PisterLab/scum-dev-board/sulu-ldo/readme.md

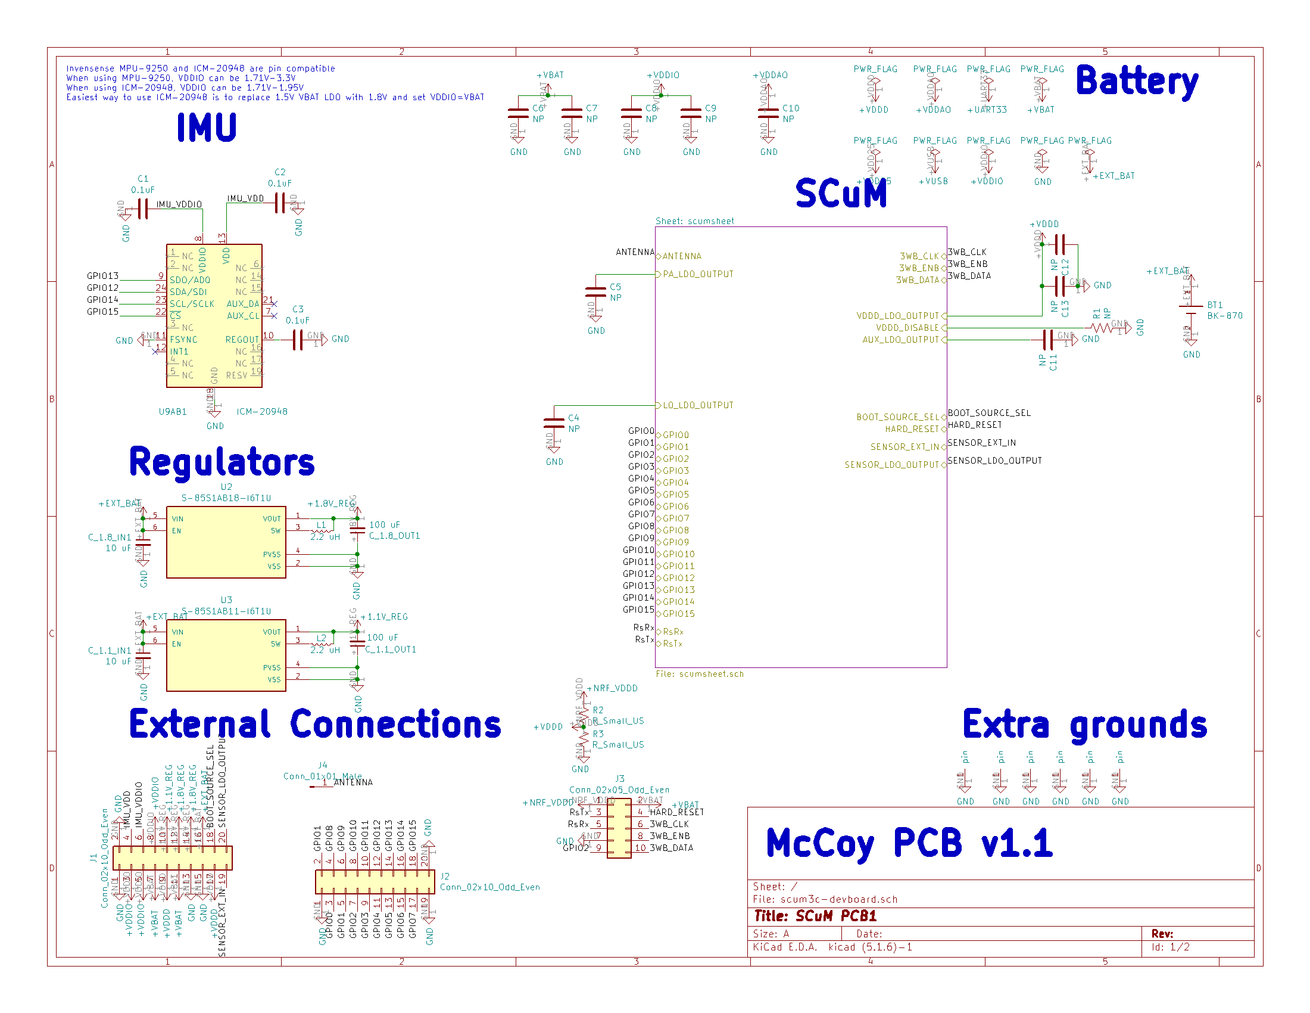
[picture p5: sulu-ldo/pictures/scum3c-devboard_schematic_Page_1.png]
Schematic page 1

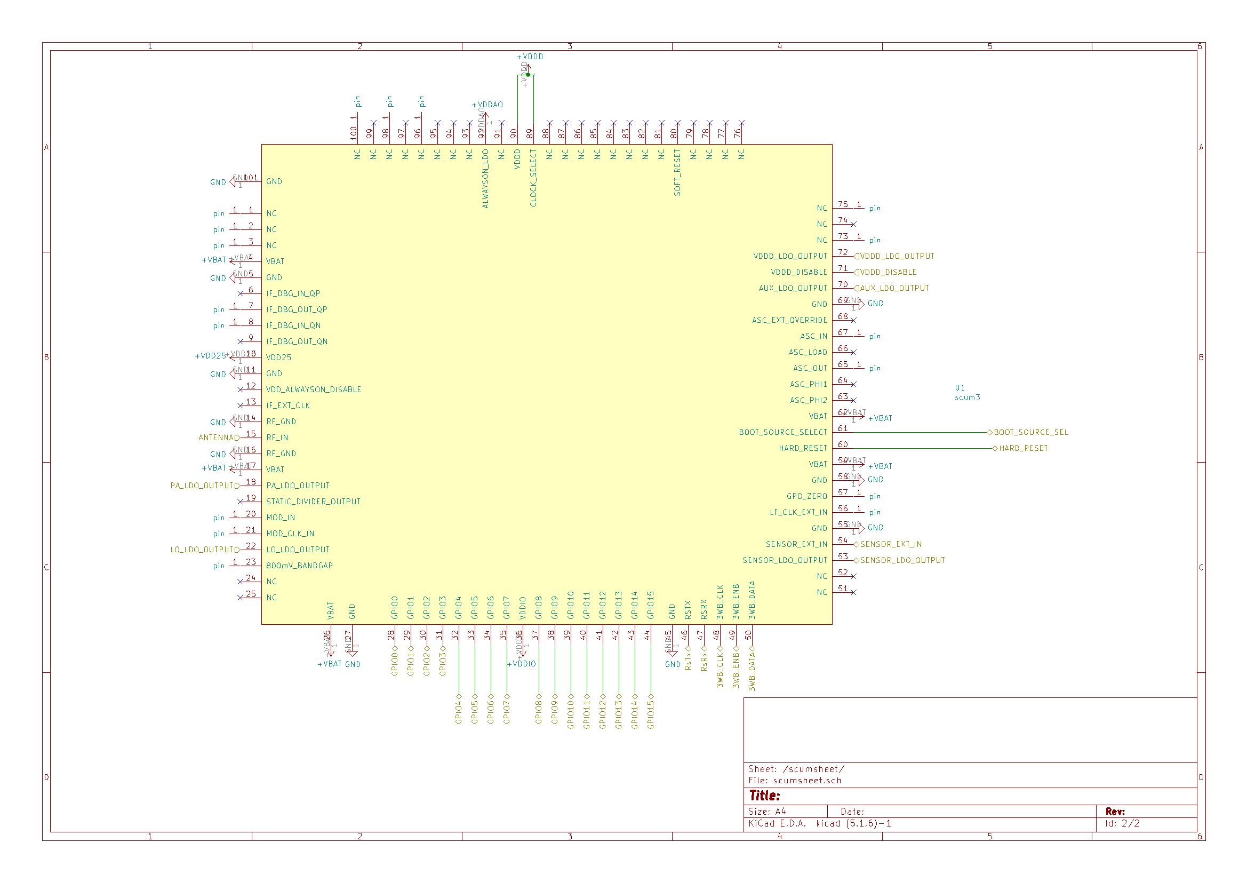
[picture p6: sulu-ldo/pictures/scum3c-devboard_schematic_Page_2.png]
Schematic page 2

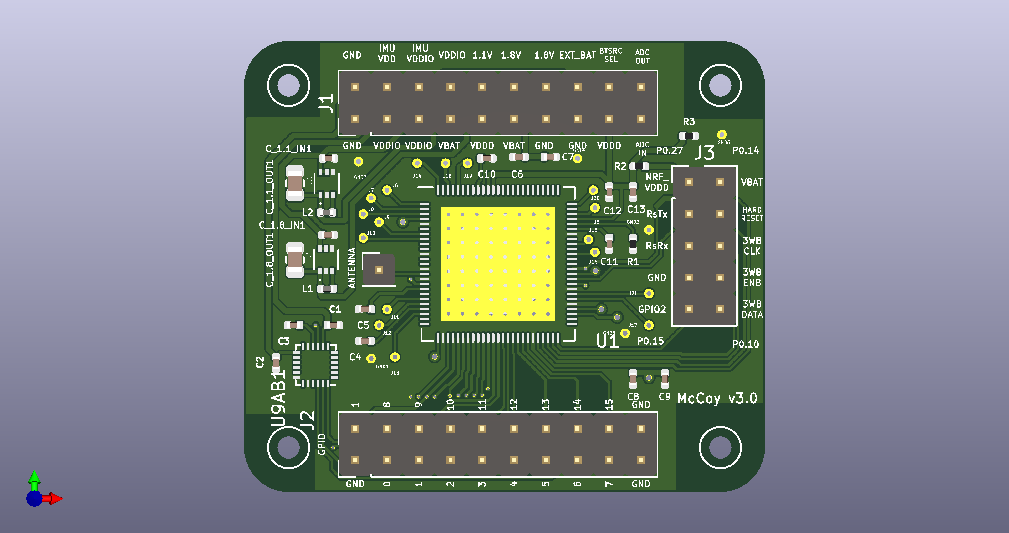
[picture p7: sulu-ldo/pictures/scum3c-devboard.png]
3D front

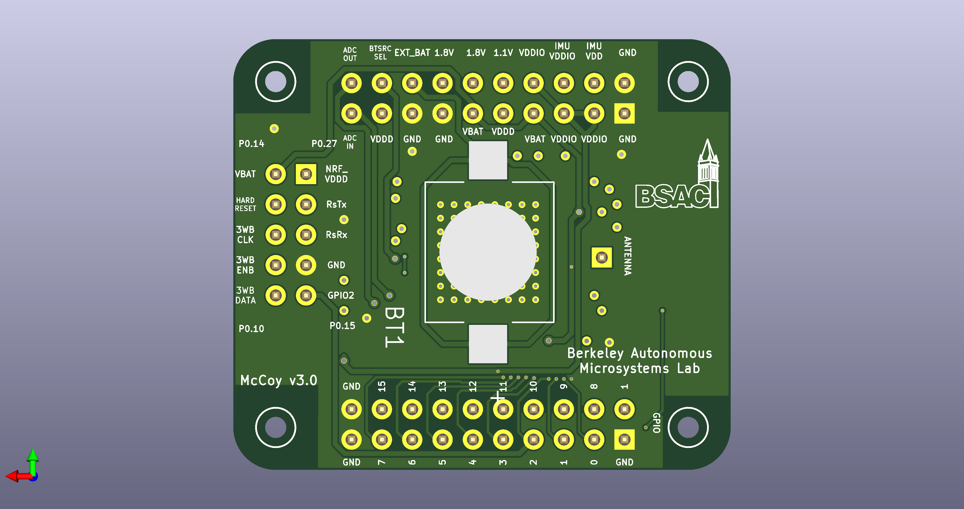
[picture p8: sulu-ldo/pictures/scum3c-devboard_back.png]
3D back


### Update from board review 2021.04.27
- Put the antenna on a solo pin
- rearrange some pins
- change through hole size to 15 mils
- nrf pin labels

### Updates 2021.04.25
- New layout for compatibility with NRF
- Bunch of through holes for emergency connections
- Return of the 2986 battery clip

### Updates 2021.04.14
- Austin’s requested layout
- Larger dimensions -- no longers square
- 0.1” pins
- Pins for all GPIOs
- Antenna pin
- Removed I2C for IMU
- Via holes for wiring
- 2 layer instead of 4 layer
- HARD_RESET pin
- GPO_ZERO pin instead of LED
- Swapped GPIO 12 and GPIO 13 on IMU
- Consolidated headers
- Neatened labels
- New battery clip

### Updates 2020.12.05
- removed zener diode
- added GPIOs 8, 9, 10
- added ground connections near GPIO
- added labels
- moved passives around
- added ADC pins

### Updates 2020.12.02
- Replaced antenna header with VDDD
- Kept LED
- 0-80 standoffs
- 0.1” -> 0.05” headers
- Removed GPIO 8-15 pins

### Updates 2020.10.07
- 30mm x 30 mm
- holes for standoffs
- SR521SW battery clip
- IMU
- GPIO, 3WB, UART, VBAT, VDDIO pins
- 1.8 V Zener diode for voltage protection
- LED programming indicator

### Updates 2021.01.15
- Added missing BOOT_SOURCE_SEL header
