PisterLab/scum-dev-board/spock/NJU7665.pdf

# NJU7665 Series

- 1 -

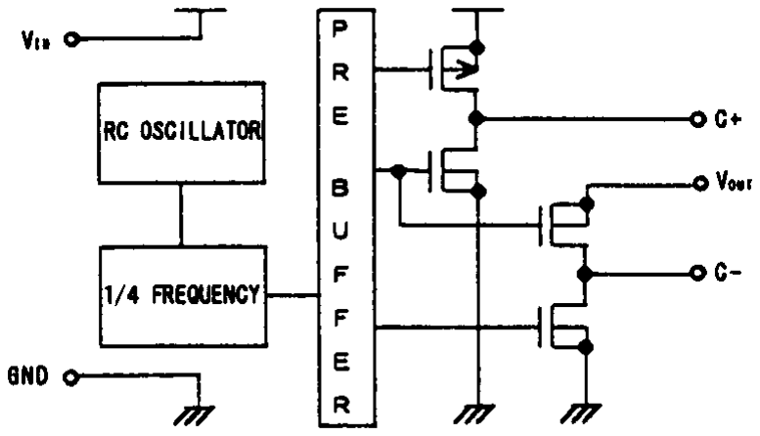
[picture p9: figure]

Ver.2018-07-18

## SMALL PACKAGE VOLTAGE INVERTER

■ GENERAL DESCRIPTION | ■ PACKAGE OUTLINE

### The NJU7665 series is a voltage inverter incorporated RC oscillator, pre-buffer and power-MOS, which generates a

polarity-converted negative voltage from +1.5V to +5.5V.

### The switching frequency is fixed by internal RC oscillator and the

following line-up of 3 version are available to select.

### The NJU7665 series is in MTP-5 package and it is suitable for

battery use items and other portable items.

### ■ FEATURES

Input Voltage | : | 1.5 to 5.5V
Switching Frequency | : | fsw = 7.5k, 75k, 150kHz
Low Output Resistance | : | 75Ω MAX. (C version, C = 1μF, VIN = 3V)
Low Operating Current | : | 100μA MAX. (Aversion)

### C-MOS Technology

Package Outline | : | MTP-5

### ■ LINE-UP TABLE

TYPE NO. | Switching Frequency | Supply Current | Output Resistance
NJU7665A | 7.5kHz (typ.) | 100μA(max.) | 1kΩ (max.)
NJU7665B | 75kHz (typ.) | 0.65mA(max.) | 100Ω (max.)
NJU7665C | 150kHz (typ.) | 1.4mA(max.) | 75Ω (max.)
■ BLOCK DIAGRAM | ■ PIN CONFIGURATION

### ■ TERMINAL DESCRIPTION

Terminal No. | Symbol | Function
1 | VOUT | Output Voltage
2 | VIN | Power Supply Terminal
3 | C
- Charge Pump Capacitor (-) Connecting Terminal
4 | GND | Ground Terminal
5 | C
| + | Charge Pump Capacitor (+) Connecting Terminal

### NJU7665XF

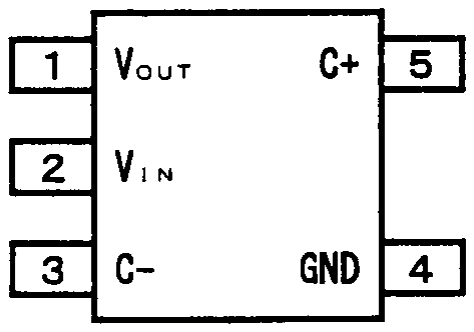
[picture p10: figure]

- 2 -
■ ABSOLUTE MAXIMUM RATINGS | (Ta = 25ºC)
PARAMETER | SYMBOL | RATINGS | UNIT
Input Supply Voltage | VIN | -0.3 to 6.0 | V
Power Dissipation | PD | 200 | mW
Operating Temperature | Topr | -40 to + 85 | ºC
Storage Temperature | Tstg | -55 to +125 | ºC
Note1) Decoupling capacitor should be connected between VIN and GND due to the stabilized operation for the IC.

### ■ ELECTRICAL CHARACTERISTICS

Aversion | (VIN = 3.0V, C1 = C2 = 1μF, Ta = 25°C)
PARAMETER | SYMBOL | CONDITION | MIN. | TYP. | MAX. | UNIT
Supply Current | IIN | RL= ∞ | – | – | 100 | μA
Input Supply Voltage | VIN | -40 °C ≤ Ta ≤ 85°C | 1.5 | – | 5.5 | V
Output Resistance | ROUT | IOUT = 500μA | – | – | 1.0 | kΩ
Switching Frequency | FSW | | 4.5 | 7.5 | 10.5 | kHz
Voltage Conversion Rate | VEF | RL= ∞ | 90 | 99.3 | – | %
B version | (VIN = 3.0V, C1 = C2 = 1μF, Ta = 25°C)
PARAMETER | SYMBOL | CONDITION | MIN. | TYP. | MAX. | UNIT
Supply Current | IIN | RL= ∞ | – | – | 0.65 | mA
Input Supply Voltage | VIN | -40 °C ≤ Ta ≤ 85°C | 1.5 | – | 5.5 | V
Output Resistance | ROUT | IOUT = 5mA | – | – | 100 | Ω
Switching Frequency | FSW | | 40 | 75 | 100 | kHz
Voltage Conversion Rate | VEF | RL= ∞ | 90 | 99.3 | – | %
C version | (VIN = 3.0V, C1 = C2 = 1μF, Ta = 25°C)
PARAMETER | SYMBOL | CONDITION | MIN. | TYP. | MAX. | UNIT
Supply Current | IIN | RL= ∞ | – | – | 1.4 | mA
Input Supply Voltage | VIN | -40 °C ≤ Ta ≤ 85°C | 1.5 | – | 5.5 | V
Output Resistance | ROUT | IOUT = 10mA | – | – | 75 | Ω
Switching Frequency | FSW | | 80 | 150 | 200 | kHz
Voltage Conversion Rate | VEF | RL= ∞ | 90 | 99.3 | – | %
NOTE2) Please minimize the wiring impedance of C+, C- terminals due to the power conversion rate.

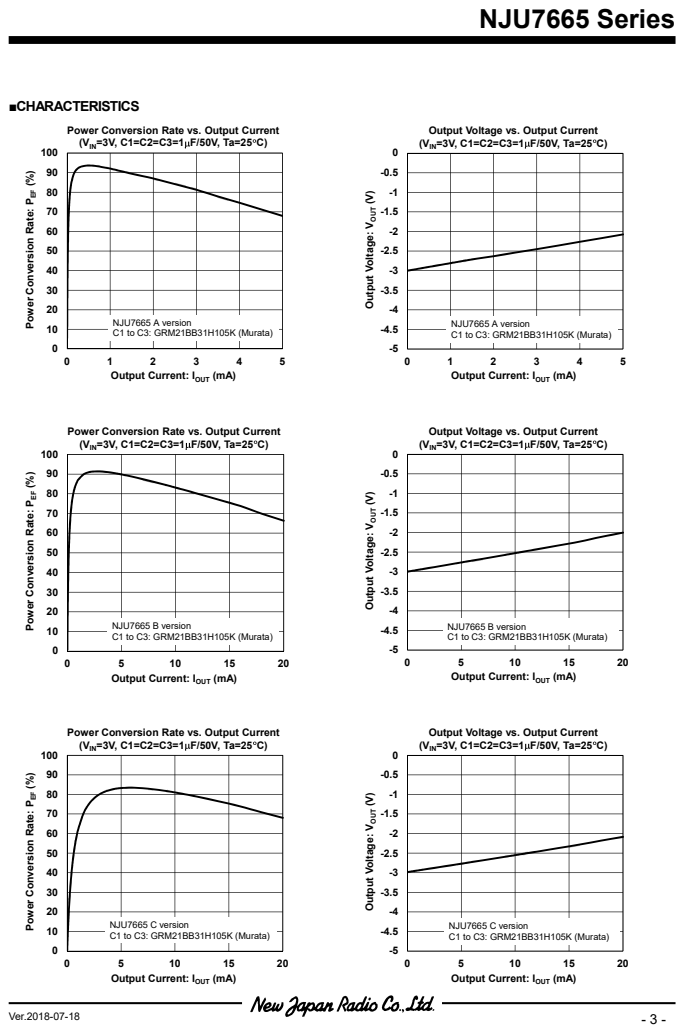
[picture p11: page 3]
■CHARACTERISTICS; NJU7665 A version C1 to C3: GRM21BB31H105K (Murata); Output Voltage vs. Output Current (VIN=3V, C1=C2=C3=1 F/50V, Ta=25 C); NJU7665 B version C1 to C3: GRM21BB31H105K (Murata); NJU7665 C version C1 to C3: GRM21BB31H105K (Murata)

Power Conversion Rate vs. Output Current
(VIN=3V, C1=C2=C3=1 F/50V, Ta=25 C)

Power Conversion Rate: PEF

Output Voltage: VOUT

Output Current: IOUT

- 4 -

### ■ APPLICATION CIRCUIT

### 1. Negative Voltage Output Circuit

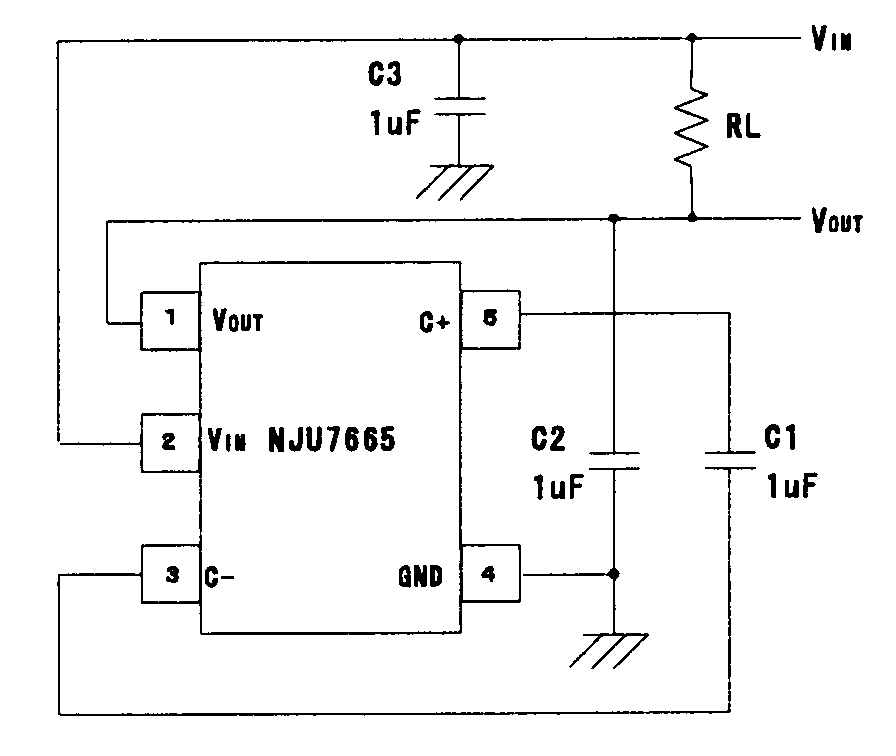
[picture p12: figure]

### 2. Parallel Connection Circuit

The following circuit reduce the output impedance.

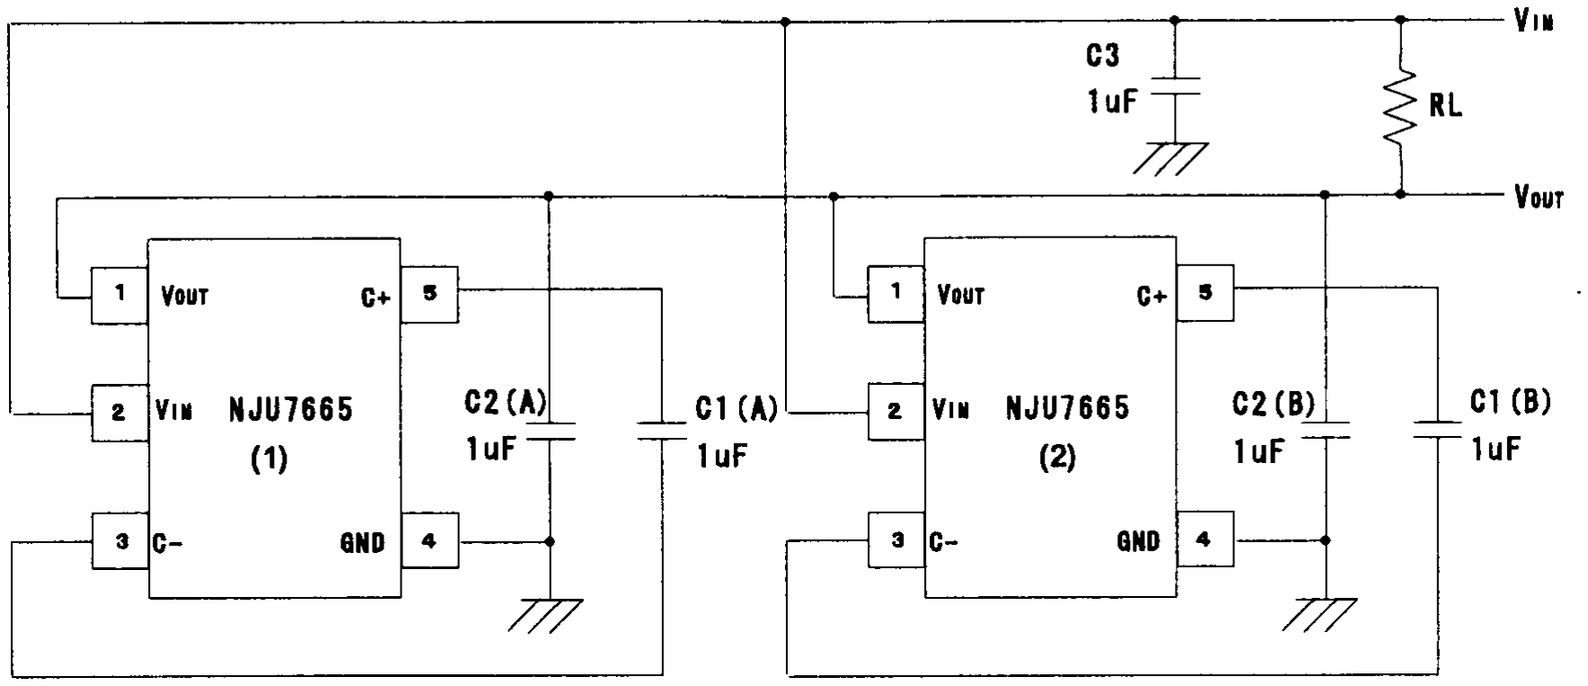
[picture p13: figure]

[CAUTION]
The specificationson thisdatabookare only given forinformation,without any guarantee asregardseither mistakesoromissions.The application circuitsinthisdatabookare describedonlyto showrepresentativeusages of the productandnot intended forthe guarantee orpermissionofanyright including theindustrialrights.
