PisterLab/scum-dev-board/sulu-ldo/pictures/mccoy_v2_bond_diagram.pptx

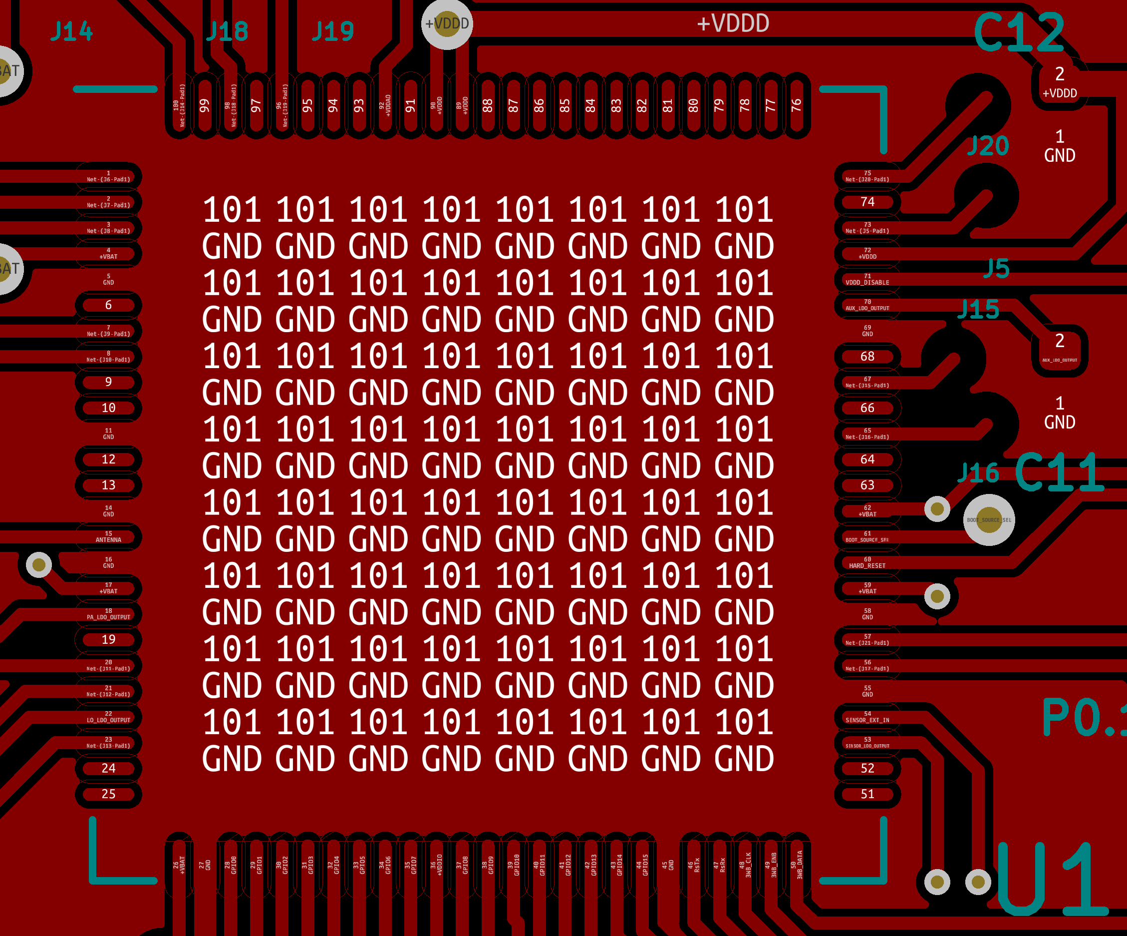
[picture p14: figure]
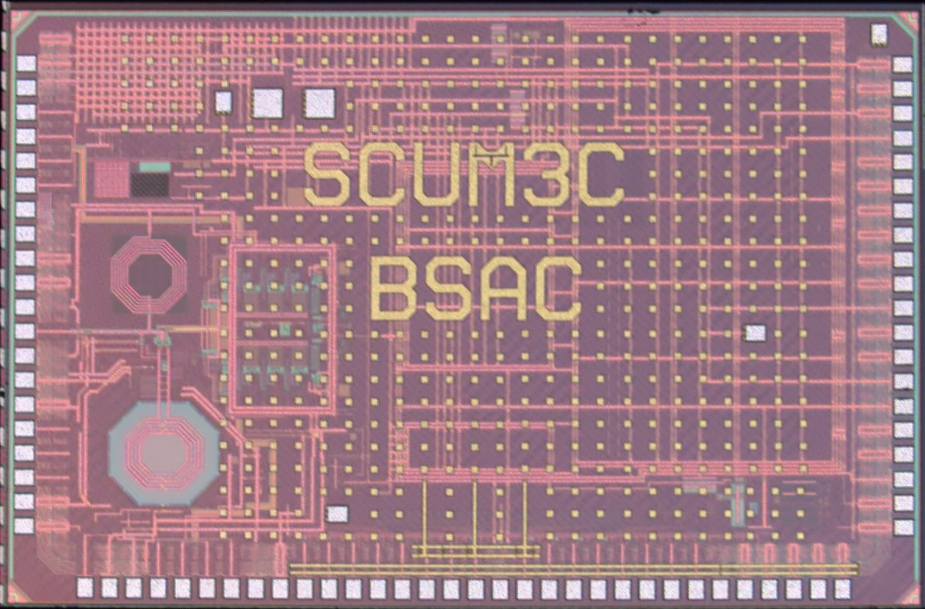
[picture p15: figure]
