PisterLab/scum-dev-board/SCM3C_PCB_Page_1.png

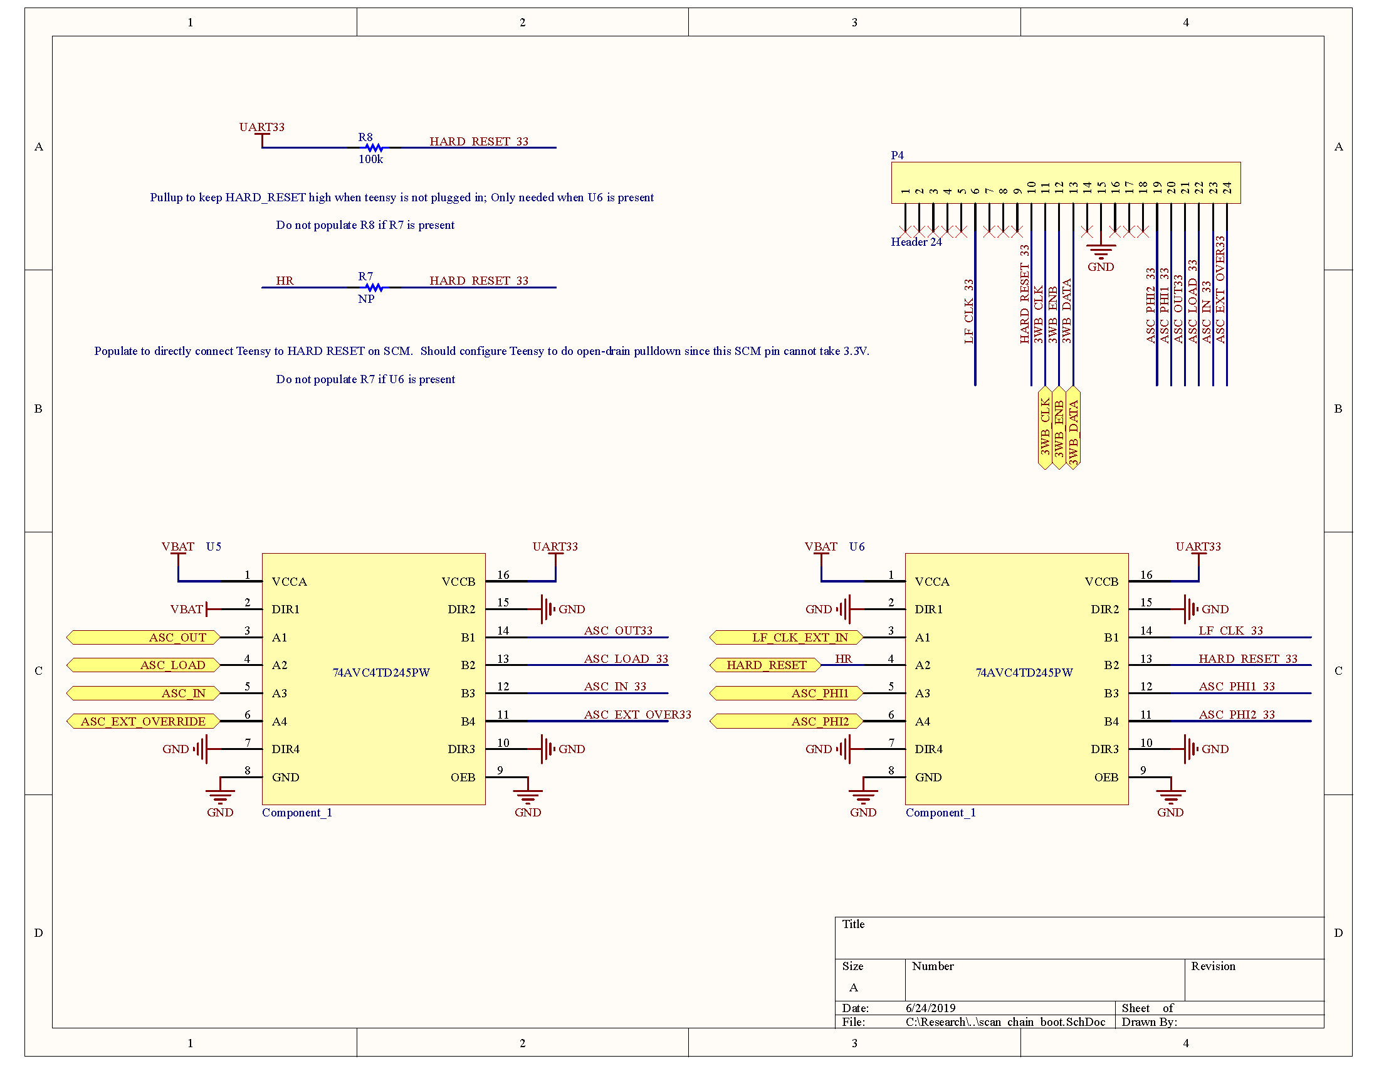
SCM3C_PCB_Page_1.png
