PisterLab/scum-dev-board/SCM3C_PCB_Page_2.png

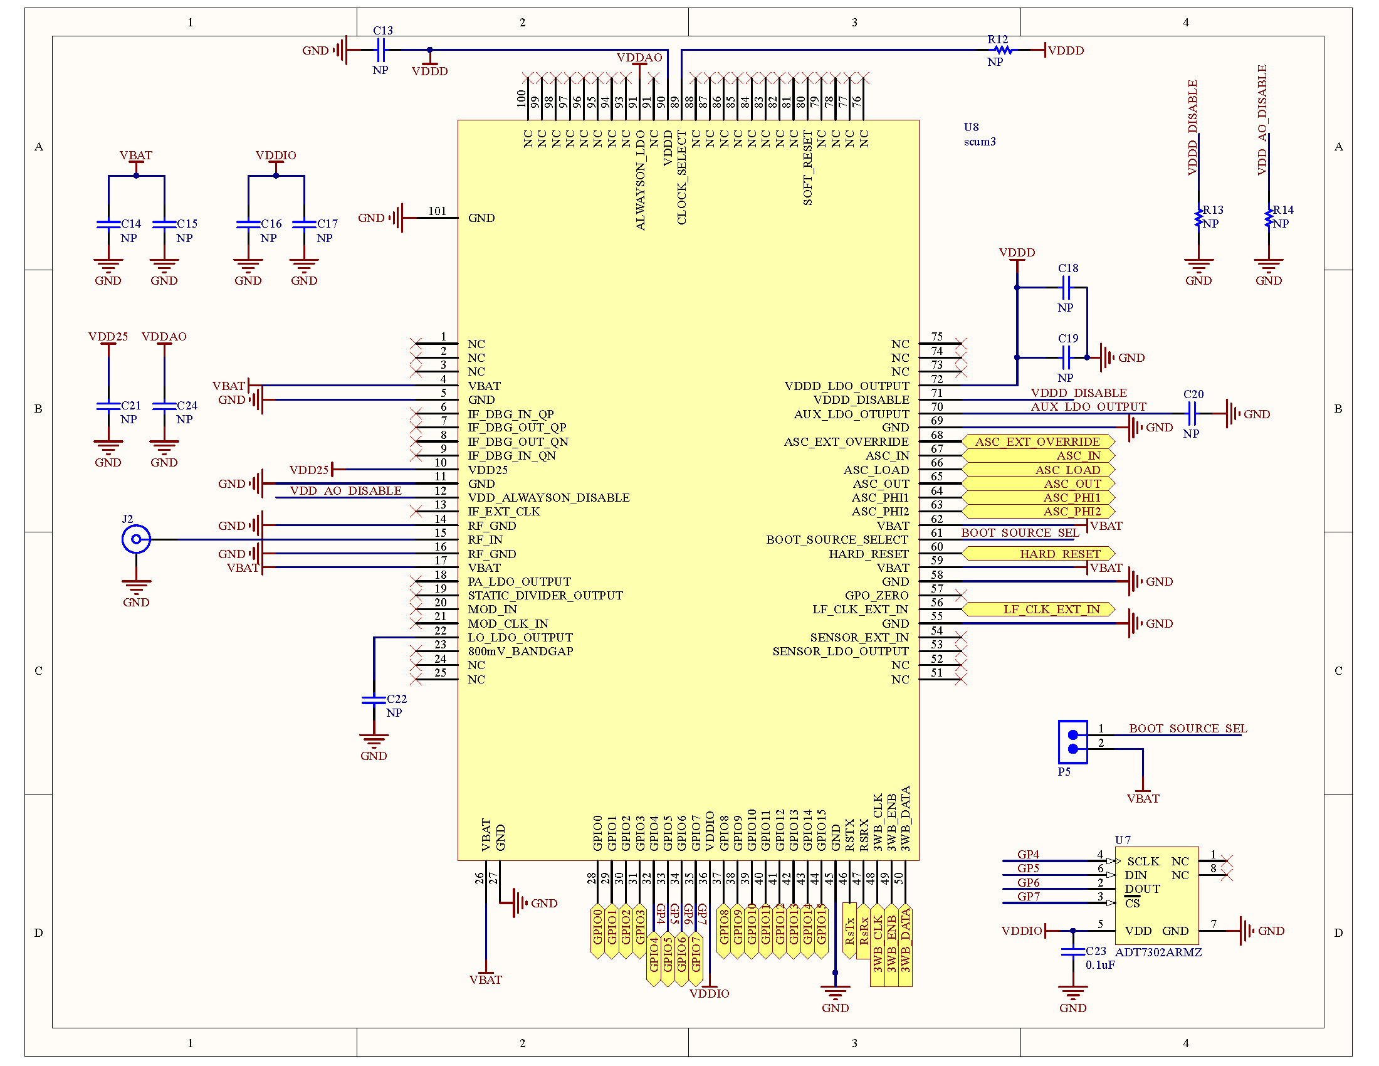
SCM3C_PCB_Page_2.png
