PisterLab/scum-dev-board/SCM3C_PCB_Page_3.png

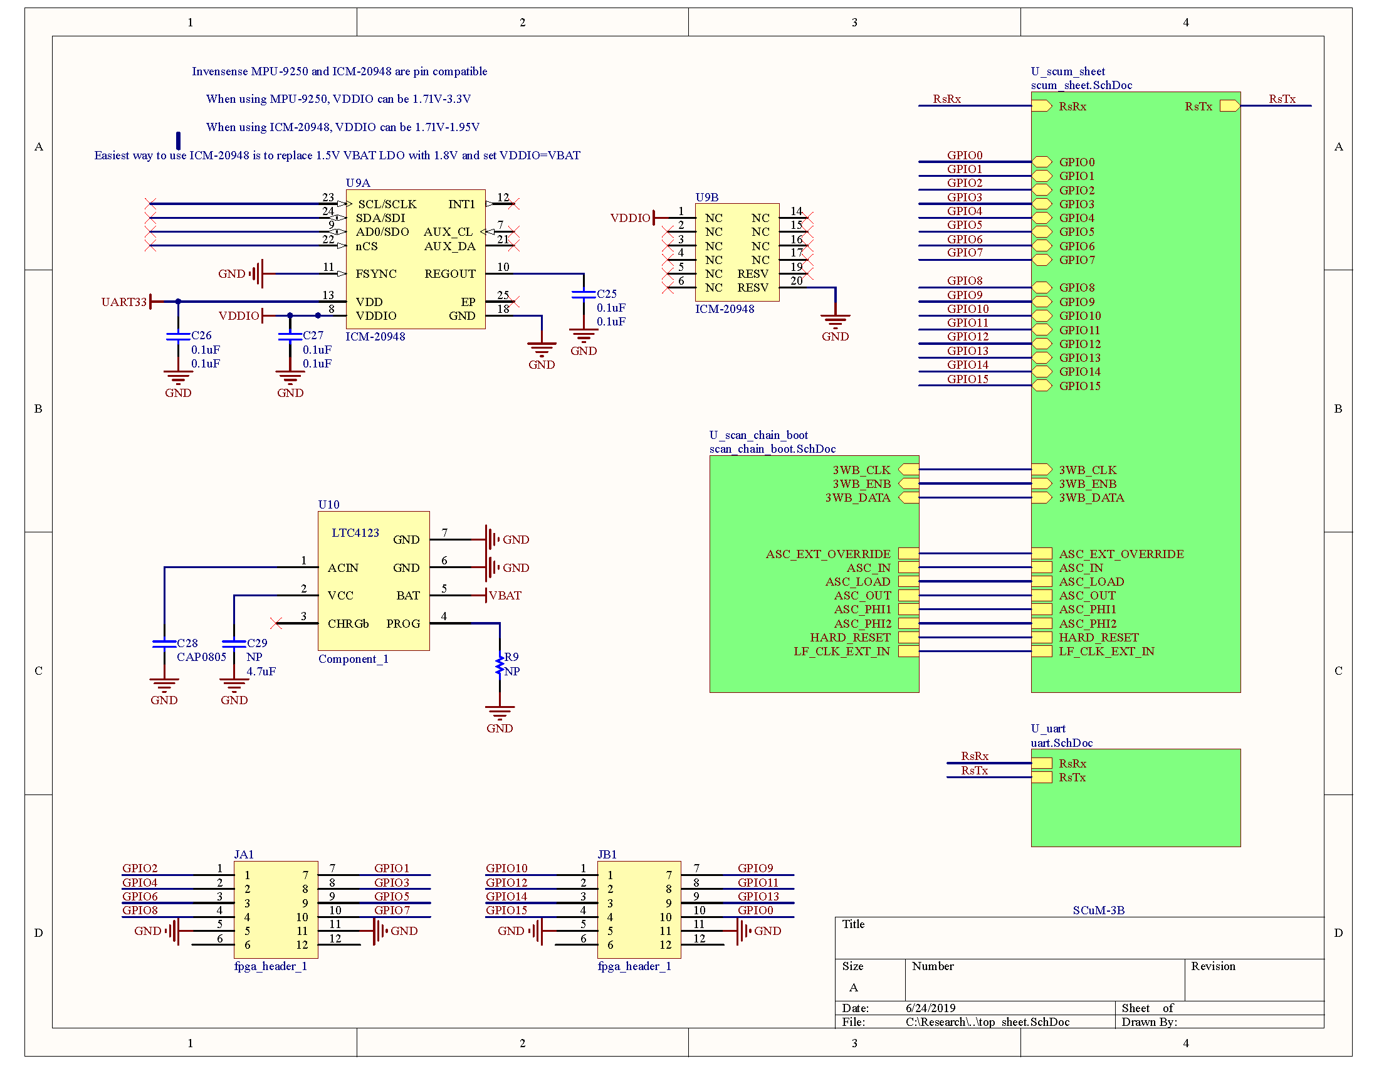
SCM3C_PCB_Page_3.png
