PisterLab/scum-dev-board/SCM3C_PCB_Page_4.png

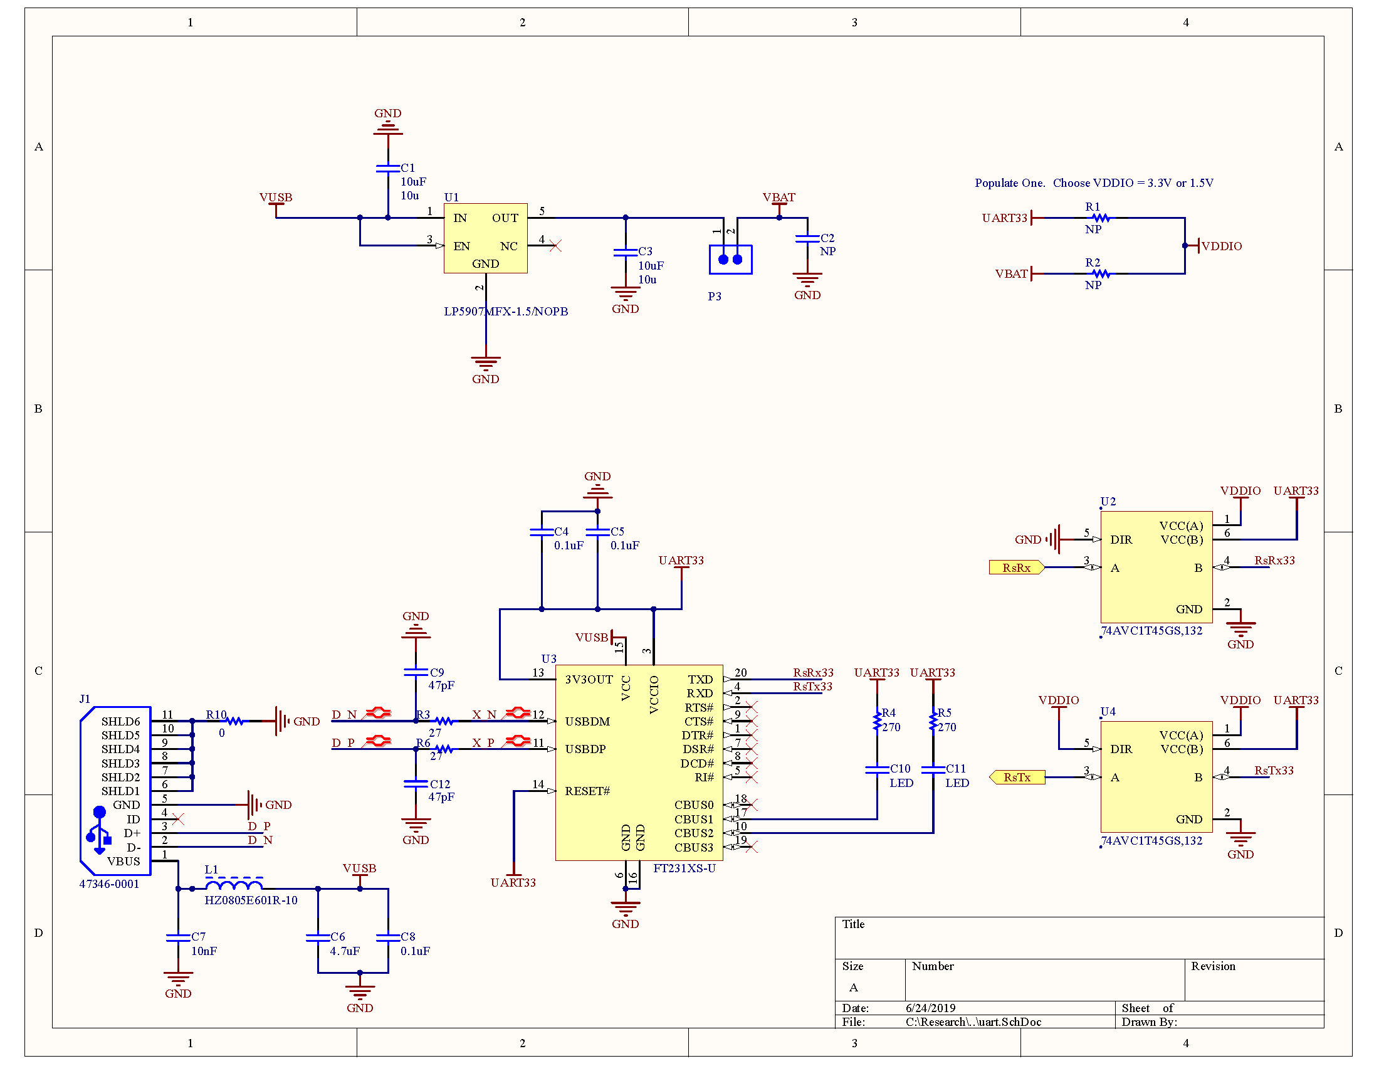
SCM3C_PCB_Page_4.png
