PisterLab/scum-dev-board/SCM3C_PCB_Page_5.png

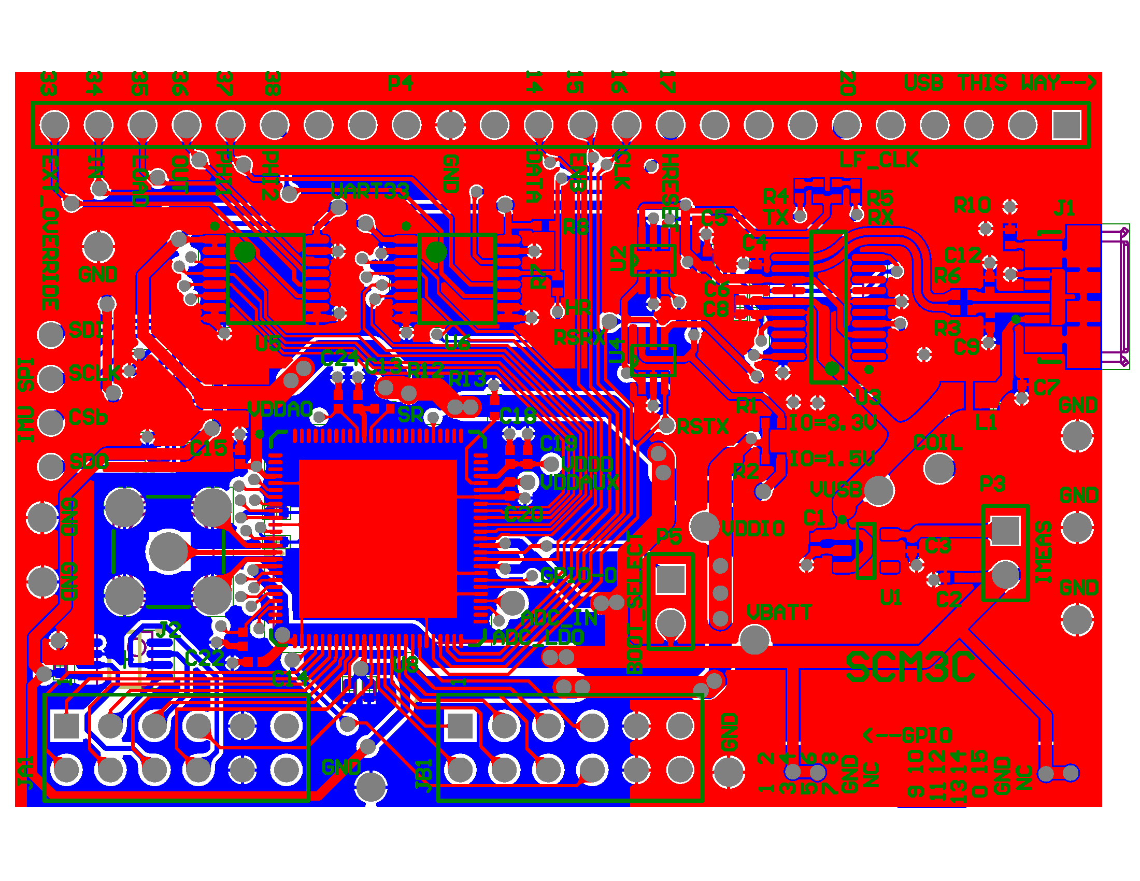
SCM3C_PCB_Page_5.png
