PisterLab/scum-dev-board/SCM3C_PCB_Page_6.png

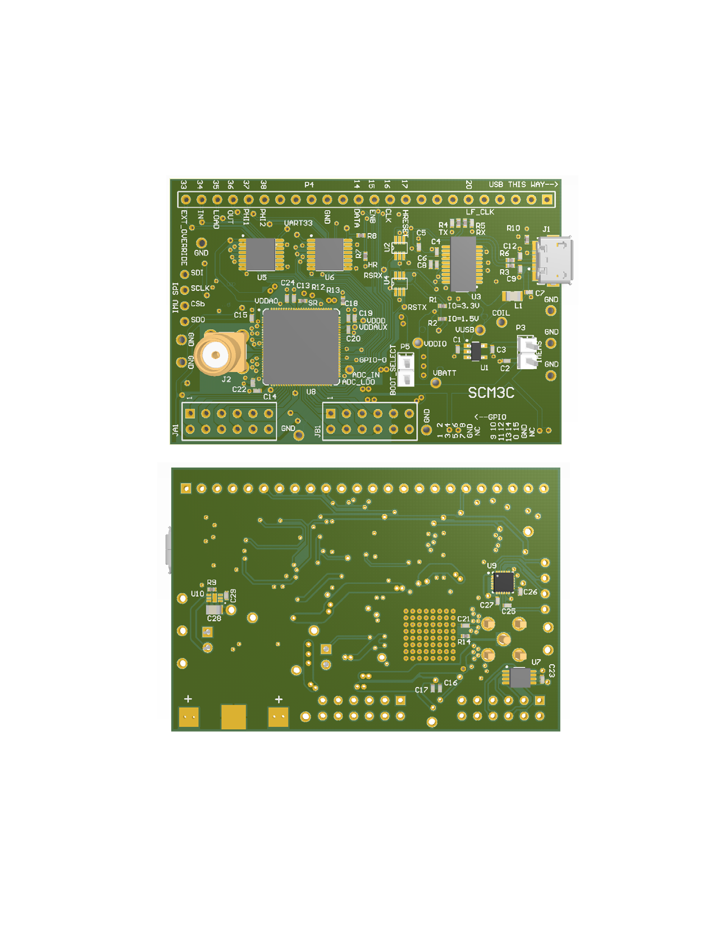
SCM3C_PCB_Page_6.png
