PisterLab/scum-dev-board/spock/Images/3D back view.PNG

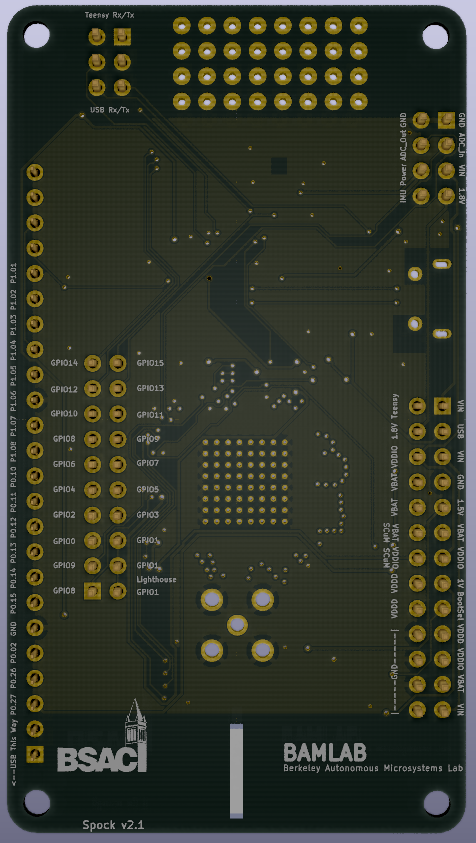
spock/Images/3D back view.PNG
