PisterLab/scum-dev-board/spock/Images/3D front view.PNG

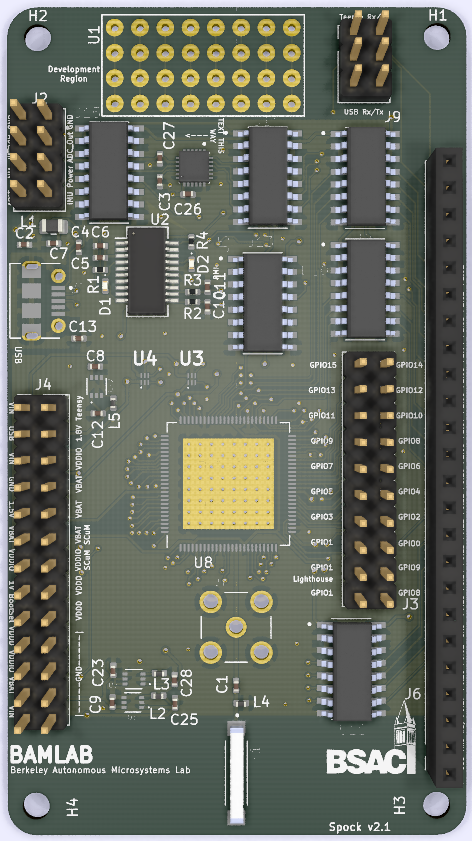
spock/Images/3D front view.PNG
