PisterLab/scum-dev-board/spock/Images/3D view.PNG

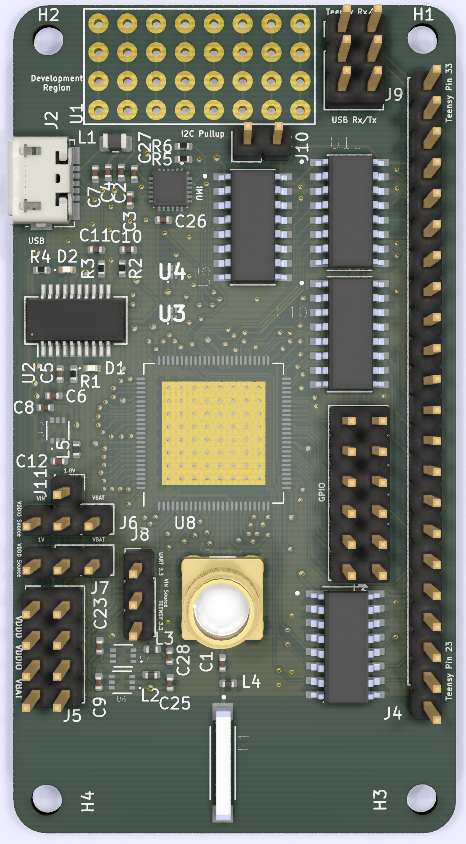
spock/Images/3D view.PNG
