PisterLab/scum-dev-board/spock/Images/Back Layout.PNG

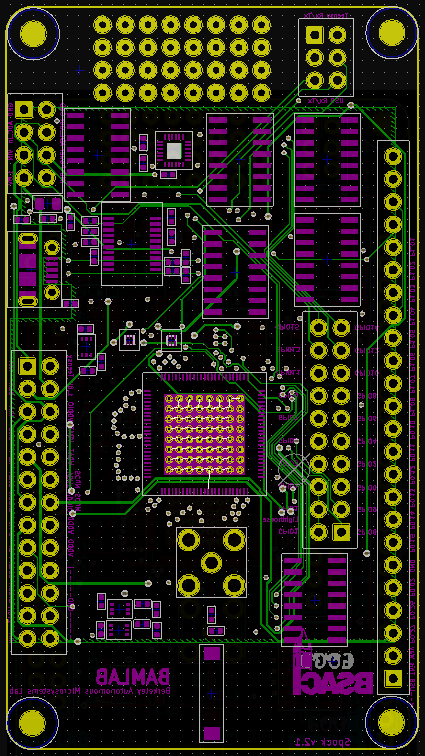
spock/Images/Back Layout.PNG
