PisterLab/scum-dev-board/spock/Images/bigBoard_bond_diagram.png

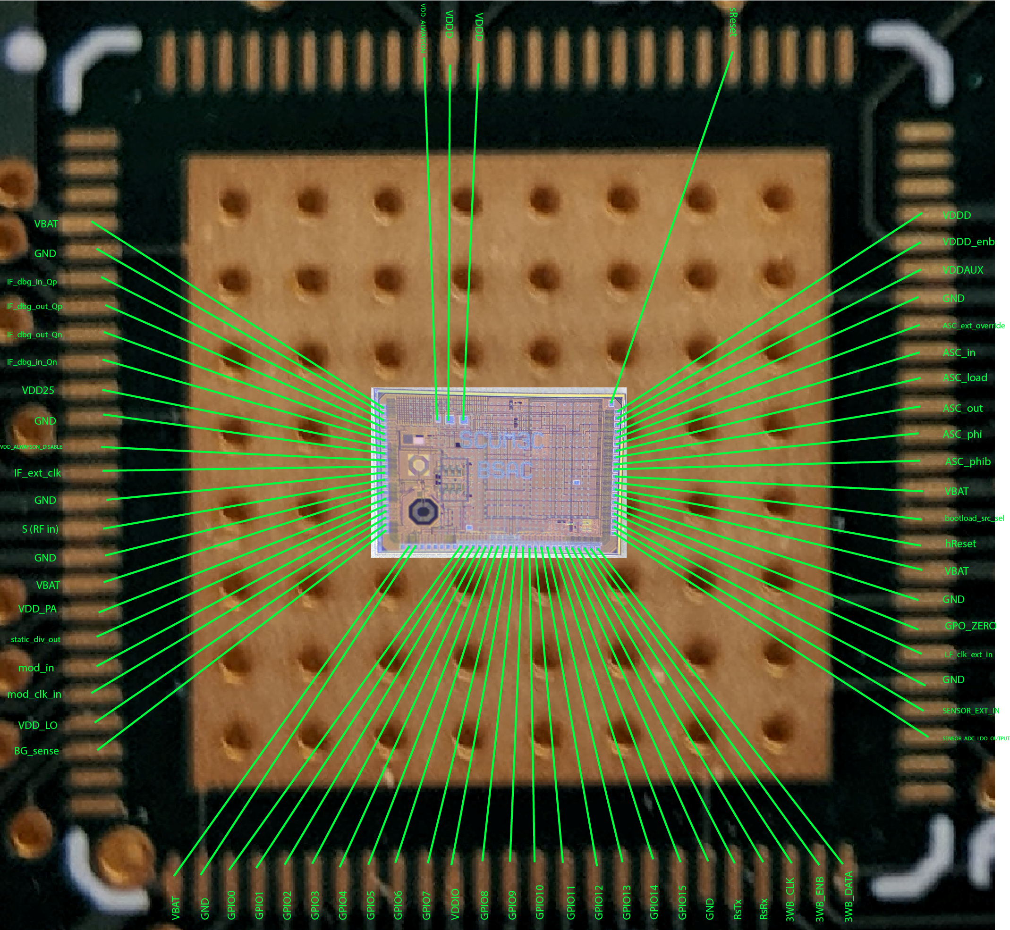
spock/Images/bigBoard_bond_diagram.png
