PisterLab/scum-dev-board/spock/Images/bigBoard_orientation_for_bonding.png

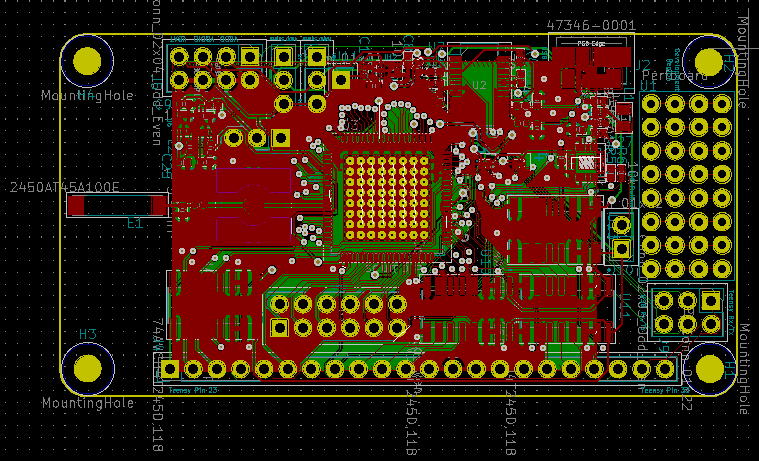
spock/Images/bigBoard_orientation_for_bonding.png
