PisterLab/scum-dev-board/spock/Images/Front Layout.PNG

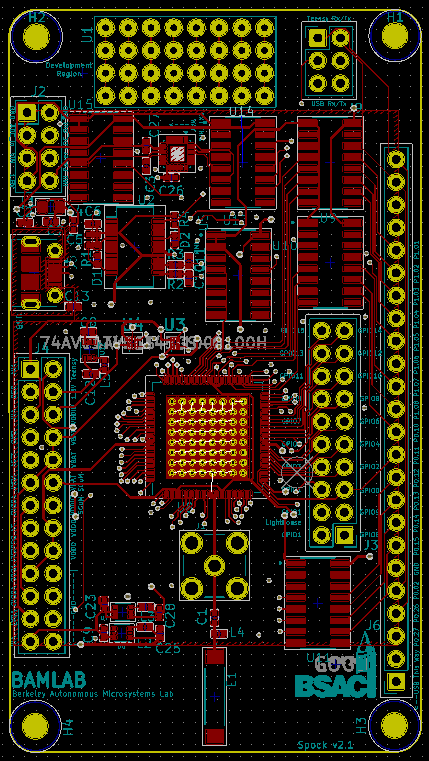
spock/Images/Front Layout.PNG
