PisterLab/scum-dev-board/sulu-ldo/pictures/gerber_settings1.png

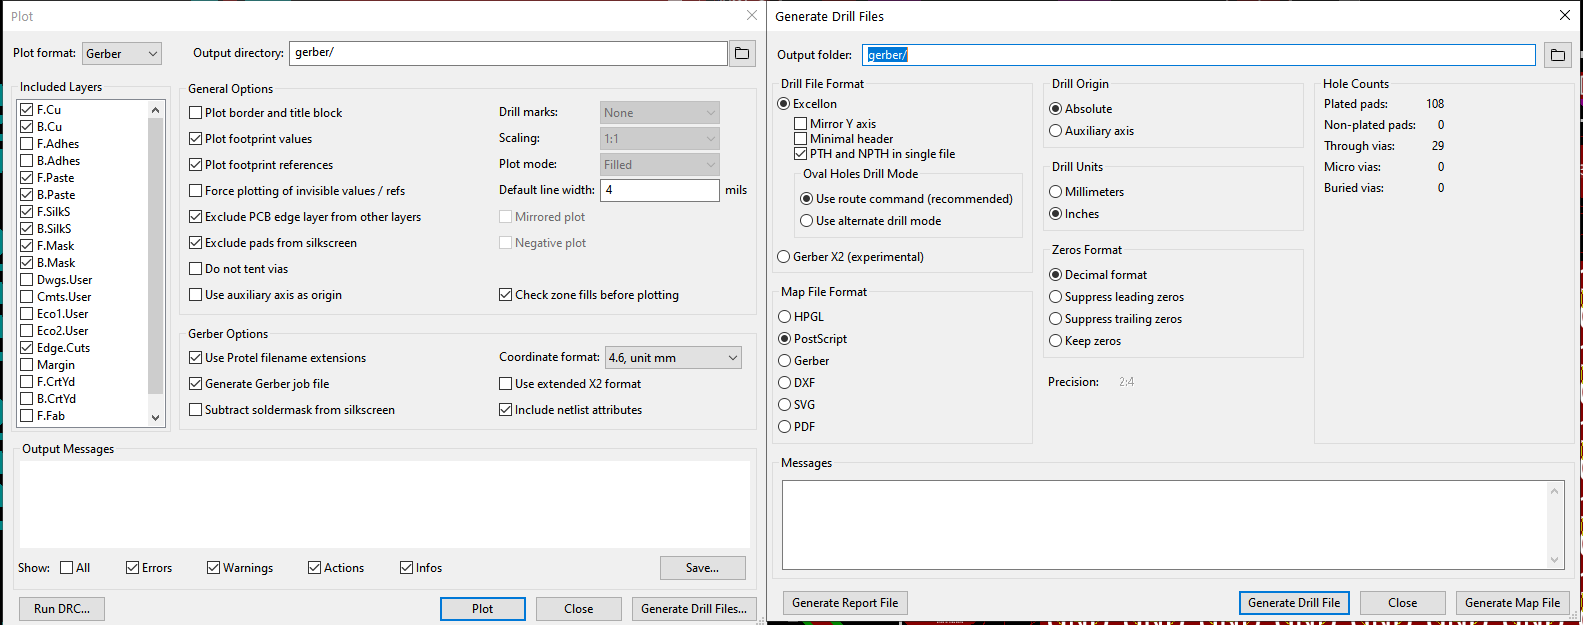
sulu-ldo/pictures/gerber_settings1.png
