PisterLab/scum-dev-board/sulu-ldo/pictures/scum3c_die_photo.png

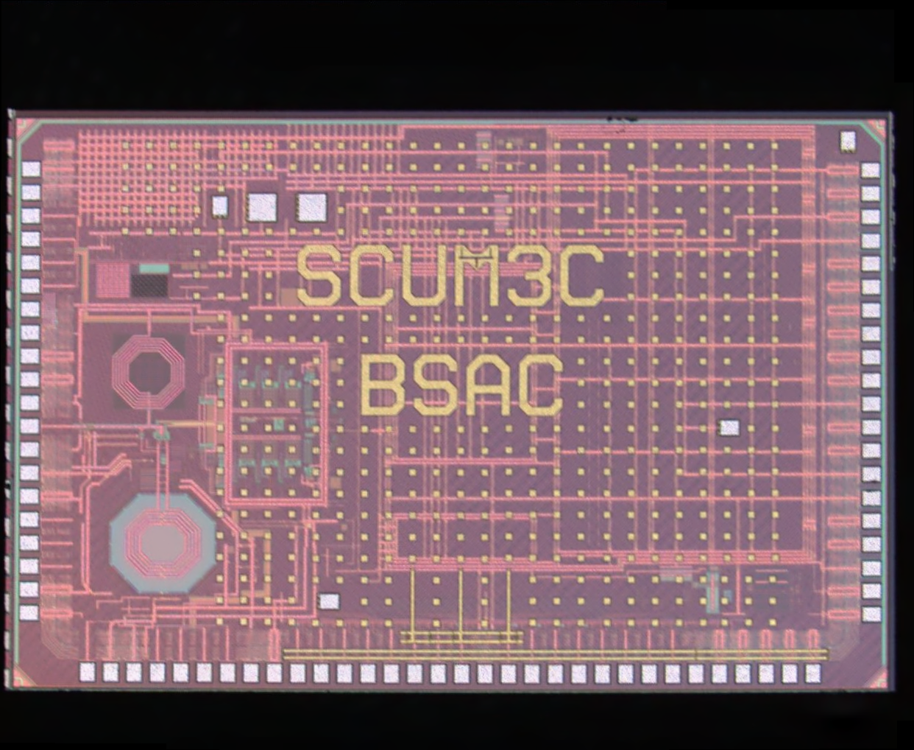
sulu-ldo/pictures/scum3c_die_photo.png
