PisterLab/scum-dev-board/sulu-ads1299/sulu_ads1299_bom_final.xlsx

Description | Detailed description | Designator | Manufacturer | Manufacturer Part Number# | Supplier | Supplier Part # | Link | QTY/BOARD | Populate
CAP CER (NP) |  | C1, C2, C3, C4, C5 |  |  |  |  |  |  | N
CAP CER 0.1UF 6.3V 10% X7R 0402 | 0.1 µF ±10% 6.3V Ceramic Capacitor X7R 0402 (1005 Metric) | C9, C10, C12, C15, C18 | Samsung Electro-Mechanics | CL05B104KQ5NNNC | Digi-Key | 1276-1511-1-ND | https://www.digikey.com/en/products/detail/samsung-electro-mechanics/CL05B104KQ5NNNC/3887169 | 5 | Y
CAP CER 1UF 6.3V X5R 0402 | 1 µF ±10% 6.3V Ceramic Capacitor X5R 0402 (1005 Metric) | C7, C8, C11, C14, C16, C17, C19 | Samsung Electro-Mechanics | CL05A105KQ5NNNC | Digi-Key |  | https://www.digikey.com/en/products/detail/samsung-electro-mechanics/CL05A105KQ5NNNC/3886668 | 7 | Y
CAP CER 2.2UF 10V X5R 0402 | 2.2 µF ±20% 10V Ceramic Capacitor X5R 0402 (1005 Metric) | C6 | Samsung Electro-Mechanics | CL03A225MQ3CRNC | Digi-Key |  | https://www.digikey.com/en/products/detail/samsung-electro-mechanics/CL05A225MP5NSNC/3887125 | 1 | Y
CAP CER 3.3UF 6.3V X5R 0402 | 3.3 µF ±10% 6.3V Ceramic Capacitor X5R 0402 (1005 Metric) | C27, C28, C29, C30 |  | C1005X5R0J335K050BC | Digi-Key |  | https://www.digikey.com/en/products/detail/tdk-corporation/C1005X5R0J335K050BC/2443424 | 4 | Y
CAP CER 10UF 6.3V X5R 0402 | 10 µF ±20% 6.3V Ceramic Capacitor X5R 0402 (1005 Metric) | C13, C26, C_1.1_IN1, C_1.8_IN1, C_1.1_OUT1, C_1.8_OUT1 | Murata Electronics | GRM155R60J106ME15D | Digi-Key |  | https://www.digikey.com/en/products/detail/murata-electronics/GRM155R60J106ME15D/5877401 | 6 | Y
CAP CER 100UF 6.3V X5R 0805 | 100 µF ±20% 6.3V Ceramic Capacitor X5R 0805 (2012 Metric) | C20 | Murata Electronics | GRM21BR60J107ME15K | Digi-Key |  | https://www.digikey.com/en/products/detail/murata-electronics/GRM21BR60J107ME15K/9887675 | 1 | Y
CAP CER (NP) |  | C21, C22, C23, C24, C25 |  |  |  |  |  |  | N
CONN SMA RCPT STR 50 OHM PCB | SMA Connector Receptacle, Female Socket 50Ohm Through Hole Solder | J1 |  | 733910060 | Digi-Key |  | https://www.digikey.com/en/products/detail/molex/0733910060/1465165 | 1 | N
RES SMD 10K OHM 1% 1/16W 0402 | 10 kOhms ±1% 0.063W, 1/16W Chip Resistor 0402 (1005 Metric) Thick Film | R1, R2 | YAGEO | RC0402FR-0710KP | Digi-Key |  | https://www.digikey.com/en/products/detail/yageo/RC0402FR-0710KP/4935264 | 2 | Y
RES 42.2K OHM 1% 1/16W 0402 | 42.2 kOhms ±1% 0.063W, 1/16W Chip Resistor 0402 (1005 Metric) Automotive AEC-Q200 Thick Film | R3 |  | RMCF0402FT42K2 | Digi-Key |  | https://www.digikey.com/en/products/detail/stackpole-electronics-inc/RMCF0402FT42K2/1714724 | 1 | Y
RES 66.5K OHM 1% 1/16W 0402 | 66.5 kOhms ±1% 0.063W, 1/16W Chip Resistor 0402 (1005 Metric) Automotive AEC-Q200 Thick Film | R4 |  | RMCF0402FT66K5 | Digi-Key |  | https://www.digikey.com/en/products/detail/stackpole-electronics-inc/RMCF0402FT66K5/1761639 | 1 | Y
RES 0 OHM |  | R5 |  |  |  |  |  |  | N
RES (NP) |  | R6 |  |  |  |  |  |  | N
RES SMD 200 OHM 0.5% 1/16W 0402 | 200 Ohms ±0.5% 0.063W, 1/16W Chip Resistor 0402 (1005 Metric) Thin Film | R7, R8, R9, R10, R11, R12, R13, R14 |  | RT0402DRE07200RL | Digi-Key |  | https://www.digikey.com/en/products/detail/yageo/RT0402DRE07200RL/1071388 | 8 | Y
FIXED IND 2.2UH 1.1A 270MOHM SMD | 2.2 µH Shielded Molded Inductor 1.1 A 270mOhm Max 0806 (2016 Metric) | L1, L2 |  | 74438343022 | Digi-Key |  | https://www.digikey.com/en/products/detail/w%C3%BCrth-elektronik/74438343022/4969341 | 2 | Y
IC REG BUCK 1.8V 200MA SNT-6A | Buck Switching Regulator IC Positive Fixed 1.8V 1 Output 200mA 6-SMD, Flat Leads | U1 | ABLIC Inc. | S-85S1AB18-I6T1U | Digi-Key |  | https://www.digikey.com/en/products/detail/ablic-u-s-a-inc/S-85S1AB18-I6T1U/9489538 | 1 | Y
IC REG BUCK 1.1V 200MA SNT-6A | Buck Switching Regulator IC Positive Fixed 1.1V 1 Output 200mA 6-SMD, Flat Leads | U2 | ABLIC Inc. | S-85S1AB11-I6T1U | Digi-Key |  | https://www.digikey.com/en/products/detail/ablic-u-s-a-inc/S-85S1AB11-I6T1U/9489535 | 1 | Y
IC REG CHARG PUMP 5V 200MA 8WSON | Charge Pump Switching Regulator IC Positive Fixed 5V 1 Output 200mA 8-WFDFN Exposed Pad | U3 | Texas Instruments | LM2775QDSGRQ1 | Digi-Key |  | https://www.digikey.com/en/products/detail/texas-instruments/LM2775QDSGRQ1/9675908 | 1 | Y
IC AFE 4 CHAN 24BIT 64TQFP | 4 Channel AFE 24 Bit 64-TQFP (10x10) | U4 | Texas Instruments | ADS1299-4PAG | Digi-Key | 3301-ADS1299-4PAG-ND | https://www.digikey.com/en/products/detail/texas-instruments/ADS1299-4PAG/14638208 | 1 | Y
SCuM QFN |  | U5 |  | Custom |  |  |  | 1 | N
CONN HEADER VERT 2POS 2.54MM | Connector Header Through Hole 2 position 0.100" (2.54mm) | J2 | Sullins Connector Solutions | PRPC002SFAN-RC | Digi-Key |  | https://www.digikey.com/en/products/detail/sullins-connector-solutions/PRPC002SFAN-RC/2775372 | 1 | Y
CONN SOCKET 10POS 0.1 GOLD PCB | 10 Position Elevated Socket Connector 0.100" (2.54mm) Through Hole Gold | J3 | Samtec Inc. | ESQ-110-14-G-S | Digi-Key |  | https://www.digikey.com/en/products/detail/samtec-inc/ESQ-110-14-G-S/6678044 | 1 | Y
CONN SOCKET 20POS 0.1 GOLD PCB | 20 Position Elevated Socket Connector 0.100" (2.54mm) Through Hole Gold | J4 | Samtec Inc. | ESQ-110-24-G-D | Digi-Key |  | https://www.digikey.com/en/products/detail/samtec-inc/ESQ-110-24-G-D/7097691 | 1 | Y
CONN RCPT 22POS 0.1 GOLD PCB | 22 Position Receptacle Connector 0.100" (2.54mm) Through Hole Gold | J5 | Samtec Inc. | SSW-111-24-F-D | Digi-Key |  | https://www.digikey.com/en/products/detail/samtec-inc/SSW-111-24-F-D/7878118 | 1 | Y
CONN HEADER VERT 2POS 2.5MM | Connector Header Through Hole 2 position 0.098" (2.50mm) | J6 | JST Sales America Inc. | B2B-XH-A-GU | Digi-Key |  | https://www.digikey.com/en/products/detail/jst-sales-america-inc/B2B-XH-A-GU/2043065 | 1 | Y
CONN HEADER VERT 14POS 2.54MM | Connector Header Through Hole 14 position 0.100" (2.54mm) | J7 | Sullins Connector Solutions | PRPC007DAAN-RC | Digi-Key |  | https://www.digikey.com/en/products/detail/sullins-connector-solutions/PRPC007DAAN-RC/2775287 | 1 | Y
THROUGH-HOLE TACTILE SWITCH, SPS | Tactile Switch SPST-NO Top Actuated Through Hole | SW1 | CIT Relay and Switch | CT11024.3F160 | Digi-Key |  | https://www.digikey.com/en/products/detail/cit-relay-and-switch/CT11024-3F160/12418834 | 1 | Y
