PisterLab/scum-dev-board/sulu-reg/sulu_reg_bom_0806ind.xlsx

Description | Detailed description | Designator | Manufacturer | Manufacturer Part Number# | Supplier | Supplier Part # | Link | QTY/BOARD
CAP CER 0.1UF 6.3V 10% X7R 0402 | 0.1 µF ±10% 6.3V Ceramic Capacitor X7R 0402 (1005 Metric) | C1, C2, C3 | Samsung Electro-Mechanics | CL05B104KQ5NNNC | Digi-Key | 1276-1511-1-ND | https://www.digikey.com/en/products/detail/samsung-electro-mechanics/CL05B104KQ5NNNC/3887169 | 3
IMU ACCEL/GYRO/COMPI2C/SPI 24QFN | Accelerometer, Gyroscope, Magnetometer, 9 Axis Sensor I²C, SPI Output | U9AB1 | TDK InvenSense | ICM-20948 | Digi-Key | 1428-1123-1-ND | https://www.digikey.com/en/products/detail/tdk-invensense/ICM-20948/6623535 | 1
CAP CER 100UF 2.5V X5R 0805 | 100 µF ±20% 2.5V Ceramic Capacitor X5R 0805 (2012 Metric) | C_1.1_OUT1, C_1.8_OUT2 | Murata Electronics | GRM21BR60E107ME15L | Digi-Key |  | https://www.digikey.com/en/products/detail/murata-electronics/GRM21BR60E107ME15L/6155809 | 2
Battery Holder (Open) Coin, 24.5mm 1 Cell PC Pin | Battery Holder (Open) Coin, 24.5mm 1 Cell PC Pin | BT1 |  | BH1000G | Digi-Key |  | https://www.digikey.com/en/products/detail/mpd-memory-protection-devices/BH1000G/140383 | 1
BATT LITHIUM COIN 3.0V | Coin, 24.5mm Lithium Manganese Dioxide Battery Non-Rechargeable (Primary) |  |  | CR 2477 JAUCH (IB) | Digi-Key |  | https://www.digikey.com/en/products/detail/jauch-quartz/CR-2477-JAUCH-(IB)/9561010 | 1
CAP CER 10UF 10V X5R 0402 | 10 µF ±20% 10V Ceramic Capacitor X5R 0402 (1005 Metric) | C_1.1_IN1, C_1.8_IN2 |  |  | Digi-Key |  | https://www.digikey.com/en/products/detail/samsung-electro-mechanics/CL05A106MP8NUB8/5961314 | 2
CONN SMA RCPT STR 50 OHM PCB | SMA Connector Receptacle, Female Socket 50Ohm Through Hole Solder |  |  | 733910060 | Digi-Key |  | https://www.digikey.com/en/products/detail/molex/0733910060/1465165 | 1
RES 42.2K OHM 1% 1/16W 0402 | 42.2 kOhms ±1% 0.063W, 1/16W Chip Resistor 0402 (1005 Metric) Automotive AEC-Q200 Thick Film | R2 |  | RMCF0402FT42K2 | Digi-Key |  | https://www.digikey.com/en/products/detail/stackpole-electronics-inc/RMCF0402FT42K2/1714724 | 1
RES 66.5K OHM 1% 1/16W 0402 | 66.5 kOhms ±1% 0.063W, 1/16W Chip Resistor 0402 (1005 Metric) Automotive AEC-Q200 Thick Film | R3 |  | RMCF0402FT66K5 | Digi-Key |  | https://www.digikey.com/en/products/detail/stackpole-electronics-inc/RMCF0402FT66K5/1761639 | 1
IC REG BUCK 1.8V 200MA SNT-6A | Buck Switching Regulator IC Positive Fixed 1.8V 1 Output 200mA 6-SMD, Flat Leads | U2 |  | S-85S1AB18-I6T1U | Digi-Key |  | https://www.digikey.com/en/products/detail/ablic-u-s-a-inc/S-85S1AB18-I6T1U/9489538 | 1
IC REG BUCK 1.1V 200MA SNT-6A | Buck Switching Regulator IC Positive Fixed 1.1V 1 Output 200mA 6-SMD, Flat Leads | U3 |  | S-85S1AB11-I6T1U | Digi-Key |  | https://www.digikey.com/en/products/detail/ablic-u-s-a-inc/S-85S1AB11-I6T1U/9489535 | 1
FIXED IND 2.2UH 1.1A 270MOHM SMD | 2.2 µH Shielded Molded Inductor 1.1 A 270mOhm Max 0806 (2016 Metric) | L1, L2 |  | 74438343022 | Digi-Key |  | https://www.digikey.com/en/products/detail/w%C3%BCrth-elektronik/74438343022/4969341 | 2
