PisterLab/scum-dev-board/scum3c_devboard/scum3c_devboard_surface_mount_components.jpeg

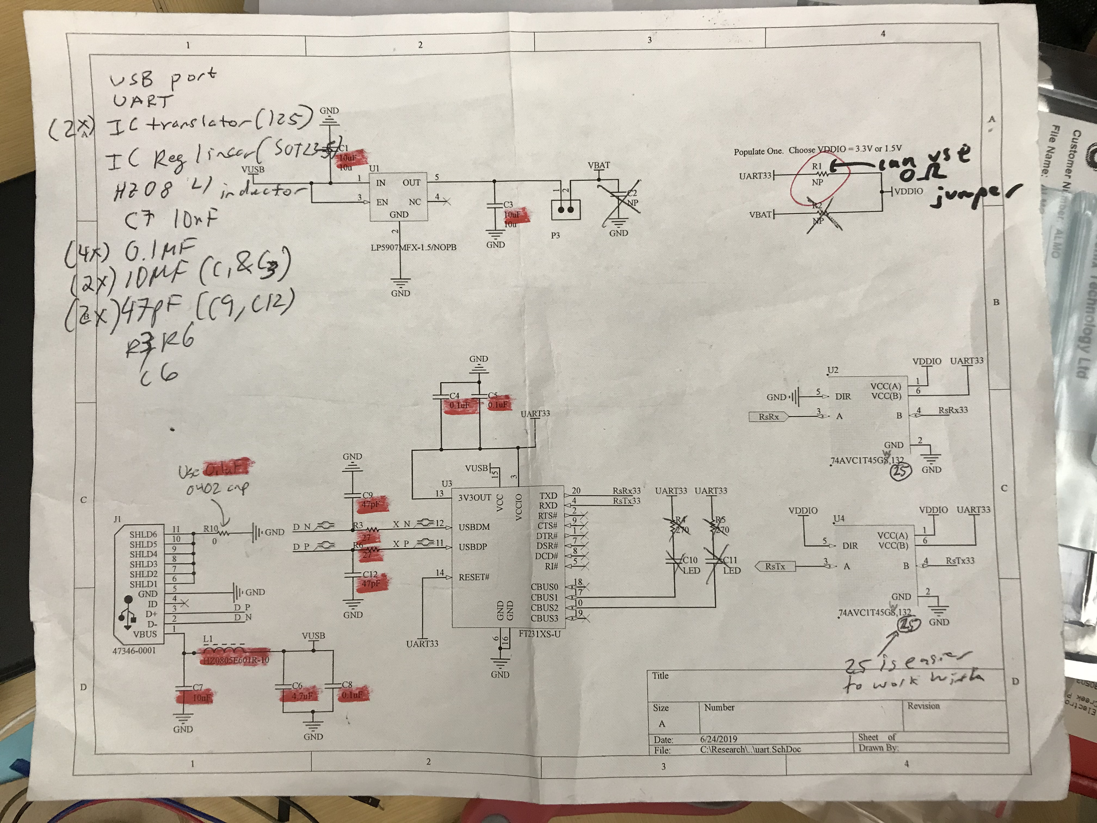
scum3c_devboard/scum3c_devboard_surface_mount_components.jpeg
