PisterLab/scum-dev-board/sulu-ads1299/downloaded_libs/3D_Models/BH1000G.STEP

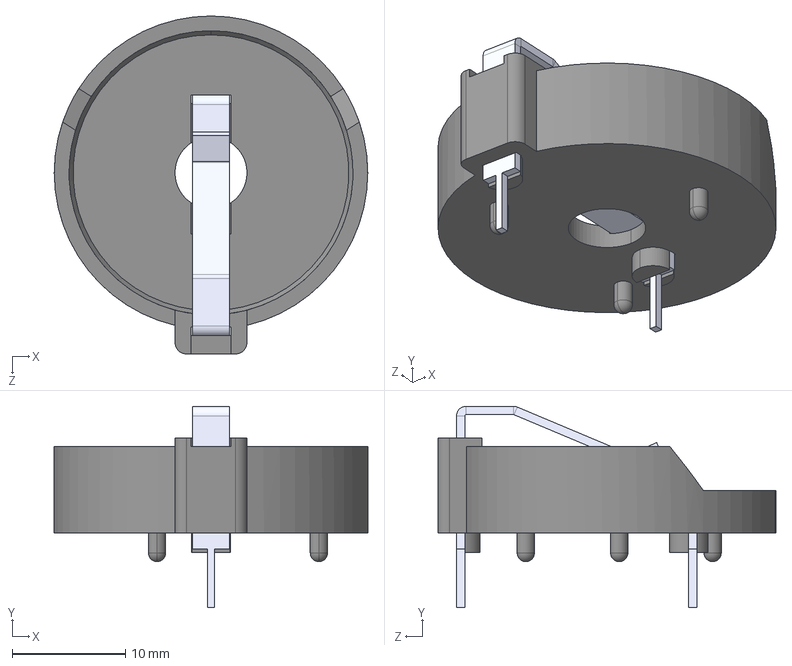
[picture p32: CAD file, 2021-09-03]
sulu-ads1299/downloaded_libs/3D_Models/BH1000G.STEP
27.7 x 17.8 x 29.8 mm
