PisterLab/scum-dev-board/sulu-ads1299/Switch_C&K_Components_TDA02H0SB1/eec.models/C&K_Components_-_TDA02H0SB1.step

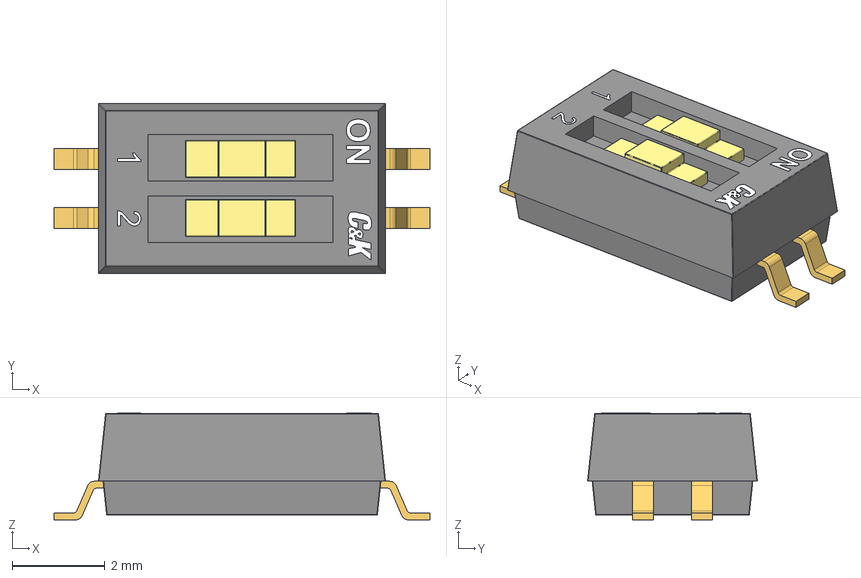
[picture p33: CAD file, 2023-06-01]
sulu-ads1299/Switch_C&K_Components_TDA02H0SB1/eec.models/C&K_Components_-_TDA02H0SB1.step
8.12 x 3.67 x 2.30 mm
logo_
terminal x 2
actuator x 2
