PisterLab/scum-dev-board/spock/downloaded_libs/3D_Models/CONSMA001-G.step

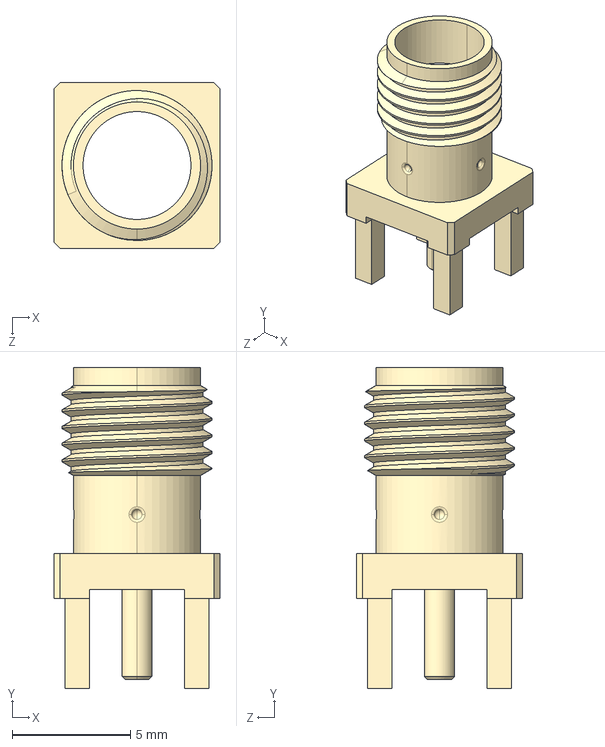
[picture p34: CAD file, 2021-03-09]
spock/downloaded_libs/3D_Models/CONSMA001-G.step
7.01 x 13.6 x 7.01 mm
