PisterLab/scum-dev-board/sulu-ads1299/downloaded_libs/3D_Models/DDZ9678-7.step

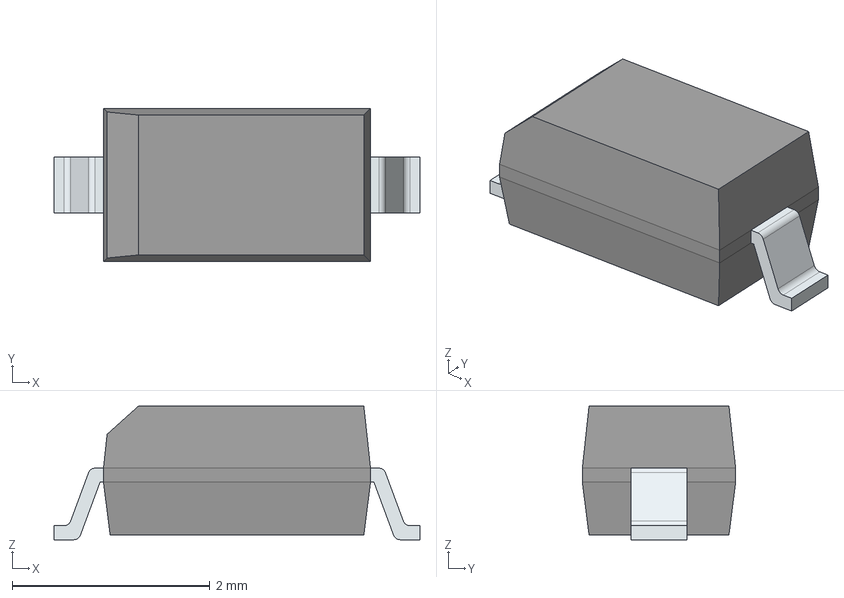
[picture p35: CAD file, 2020-10-07]
sulu-ads1299/downloaded_libs/3D_Models/DDZ9678-7.step
3.70 x 1.55 x 1.35 mm
FilletPinL
FilletPinR
