PisterLab/scum-dev-board/spock/downloaded_libs/3D_Models/CONSMA001-SMD-G-T--3DModel-STEP-56544.STEP

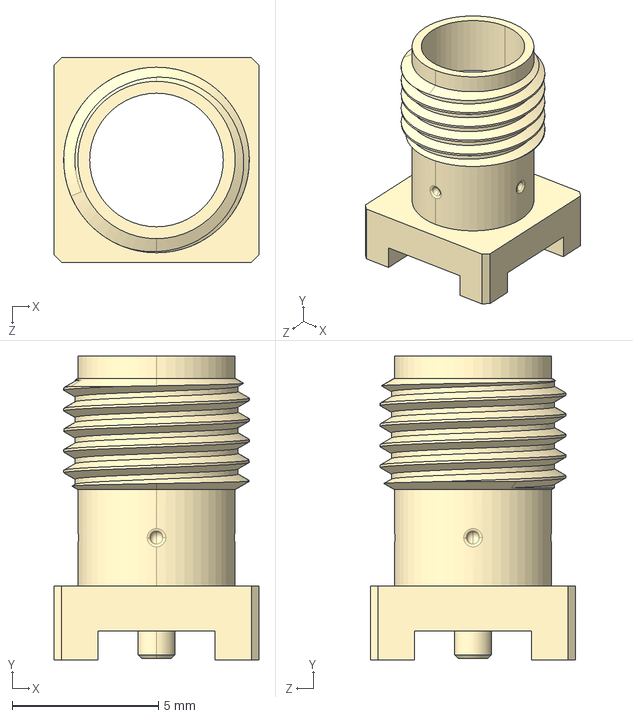
[picture p36: CAD file, 2021-01-27]
spock/downloaded_libs/3D_Models/CONSMA001-SMD-G-T--3DModel-STEP-56544.STEP
7.00 x 10.4 x 7.00 mm
