PisterLab/scum-dev-board/sulu-ads1299/downloaded_libs/3D_Models/2986.step

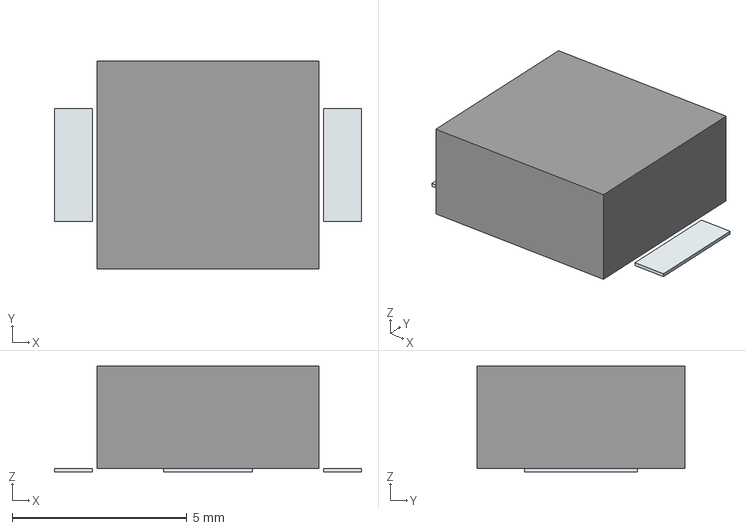
[picture p37: CAD file, 2020-10-07]
sulu-ads1299/downloaded_libs/3D_Models/2986.step
8.78 x 5.96 x 3.02 mm
Pins
