PisterLab/scum-dev-board/spock/downloaded_libs/3D_Models/2450AT45A100E.step

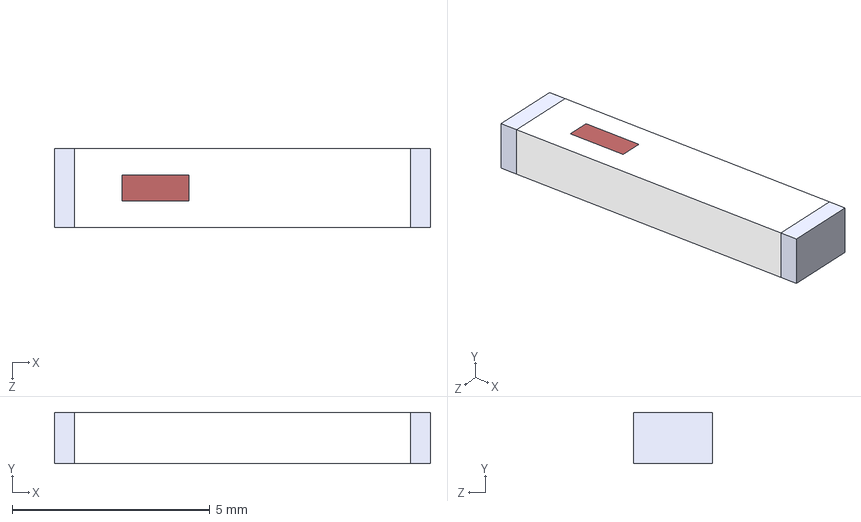
[picture p38: CAD file, 2021-01-27]
spock/downloaded_libs/3D_Models/2450AT45A100E.step
9.50 x 1.30 x 2.00 mm
