PisterLab/scum-dev-board/sulu-ads1299/downloaded_libs/3D_Models/ADP2138ACBZ-1.8.step

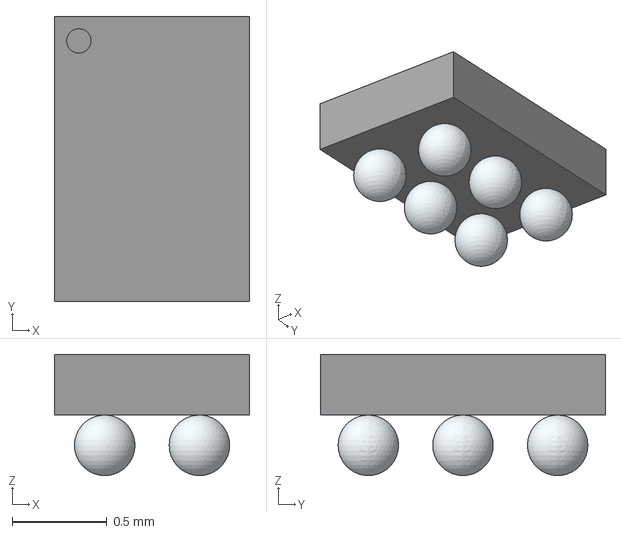
[picture p39: CAD file, 2020-10-07]
sulu-ads1299/downloaded_libs/3D_Models/ADP2138ACBZ-1.8.step
1.03 x 1.50 x 0.64 mm
