PisterLab/scum-dev-board/spock/downloaded_libs/3D_Models/ICM-20948.step

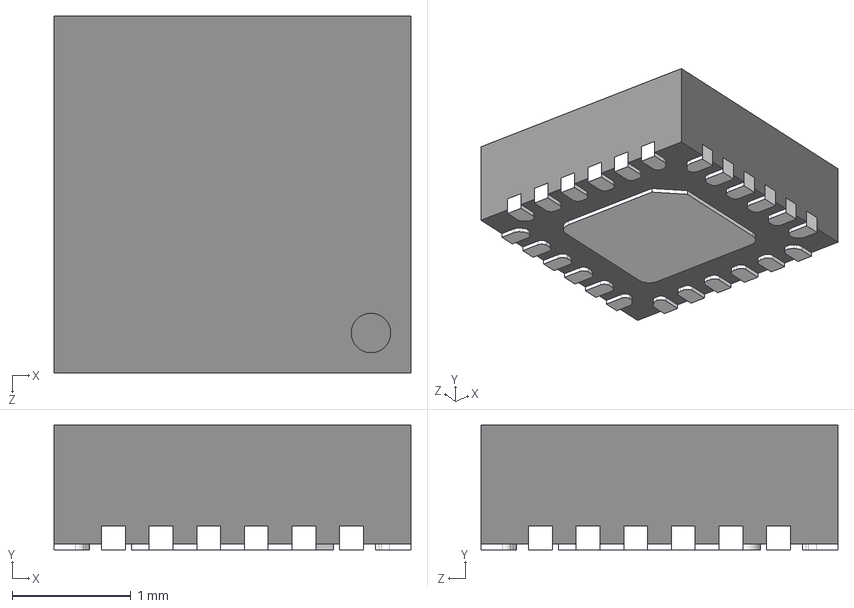
[picture p40: CAD file, 2021-01-22]
spock/downloaded_libs/3D_Models/ICM-20948.step
3.00 x 1.05 x 3.00 mm
