PisterLab/scum-dev-board/sulu-ads1299/downloaded_libs/3D_Models/FT231XS-U.step

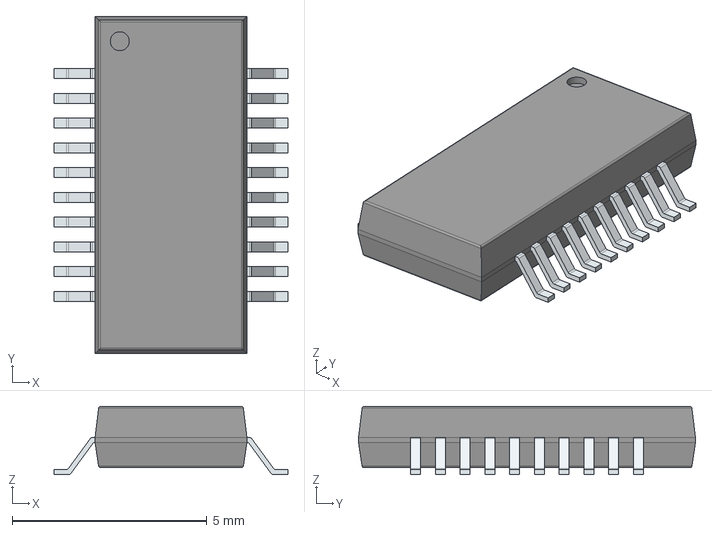
[picture p41: CAD file, 2020-08-20]
sulu-ads1299/downloaded_libs/3D_Models/FT231XS-U.step
5.99 x 8.65 x 1.75 mm
PinsArrayLR
