PisterLab/scum-dev-board/spock/downloaded_libs/3D_Models/74AVCH4T245D_118.step

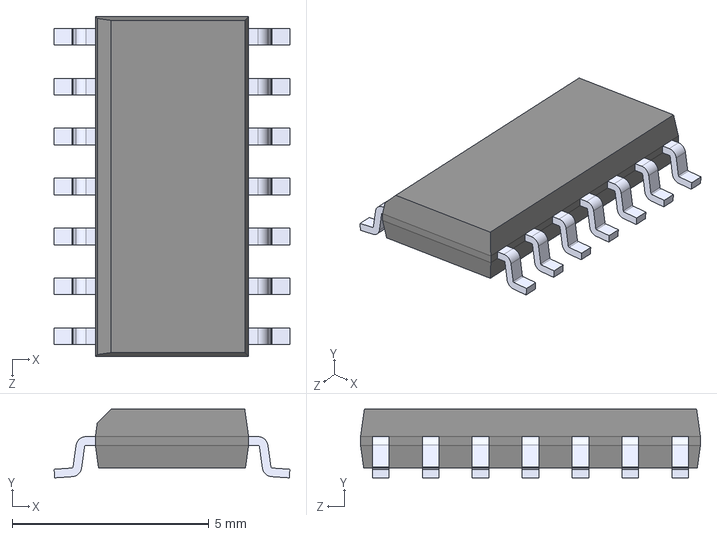
[picture p42: CAD file, 2021-01-22]
spock/downloaded_libs/3D_Models/74AVCH4T245D_118.step
6.00 x 1.75 x 8.65 mm
