PisterLab/scum-dev-board/spock/downloaded_libs/3D_Models/2450AT42B100E--3DModel-STEP-56544.STEP

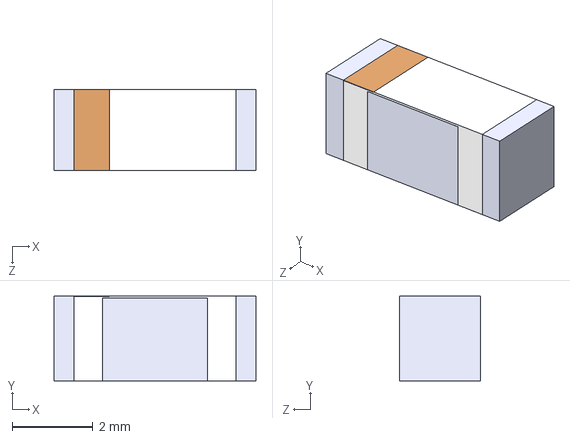
[picture p43: CAD file, 2020-12-02]
spock/downloaded_libs/3D_Models/2450AT42B100E--3DModel-STEP-56544.STEP
5.00 x 2.10 x 2.00 mm
