PisterLab/scum-dev-board/sulu-ads1299/downloaded_libs/3D_Models/HZ0805E601R-10.step

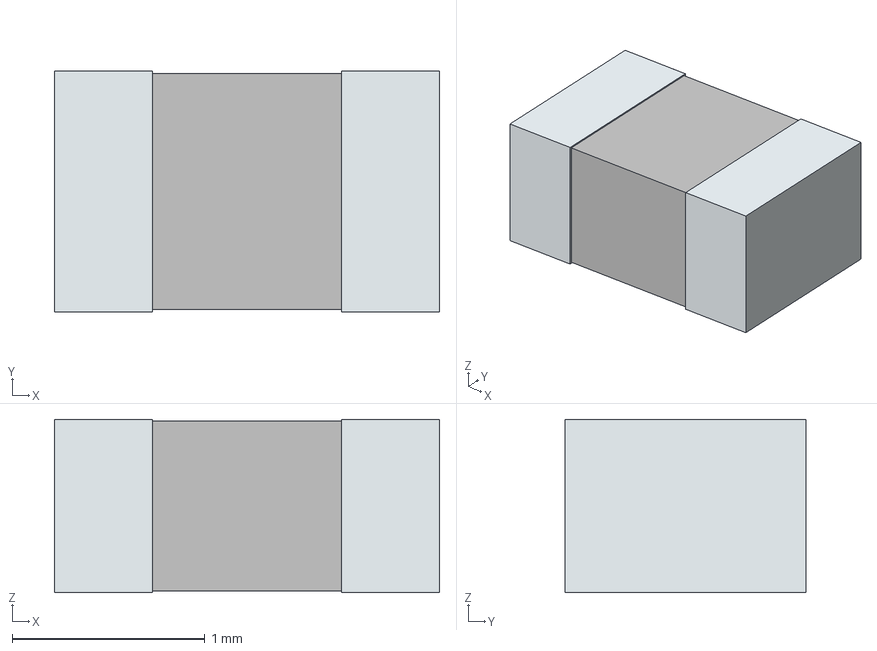
[picture p44: CAD file, 2020-08-20]
sulu-ads1299/downloaded_libs/3D_Models/HZ0805E601R-10.step
2.00 x 1.25 x 0.9 mm
term1
term2
