PisterLab/scum-dev-board/sulu-ads1299/downloaded_libs/3D_Models/NE555DR.step

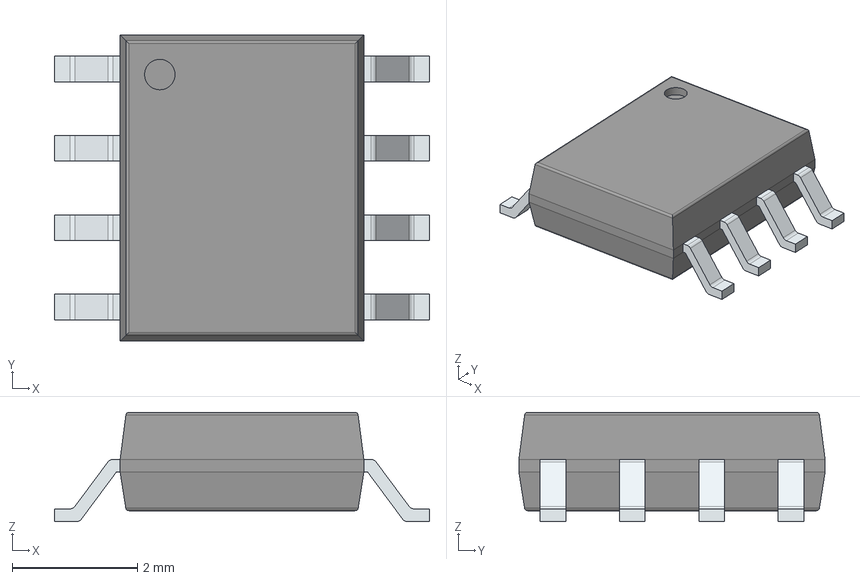
[picture p45: CAD file, 2020-08-20]
sulu-ads1299/downloaded_libs/3D_Models/NE555DR.step
6.00 x 4.90 x 1.75 mm
PinsArrayLR
