PisterLab/scum-dev-board/sulu-ads1299/downloaded_libs/3D_Models/74AVC4TD245PW_118.step

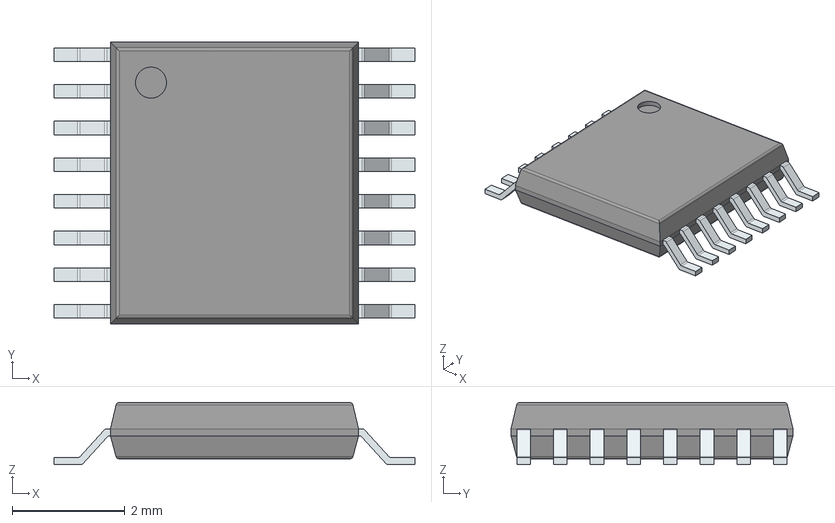
[picture p46: CAD file, 2020-08-20]
sulu-ads1299/downloaded_libs/3D_Models/74AVC4TD245PW_118.step
6.40 x 5.00 x 1.10 mm
PinsArrayLR
