PisterLab/scum-dev-board/spock/downloaded_libs/3D_Models/1050170001.step

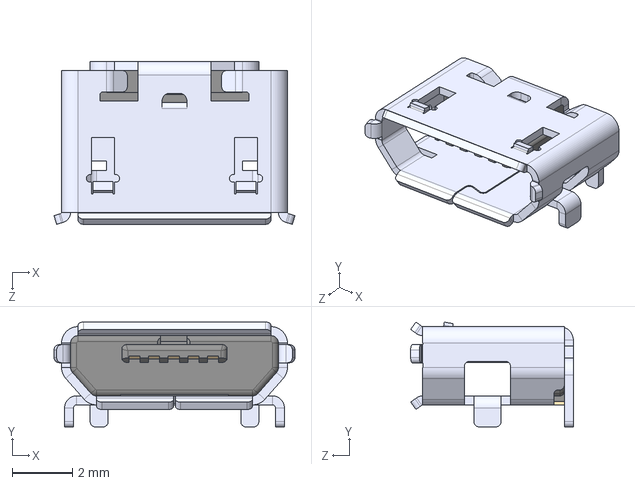
[picture p47: CAD file, 2021-06-09]
spock/downloaded_libs/3D_Models/1050170001.step
8.00 x 3.48 x 5.40 mm
