PisterLab/scum-dev-board/spock/downloaded_libs/3D_Models/TPS8268150SIPT.STEP

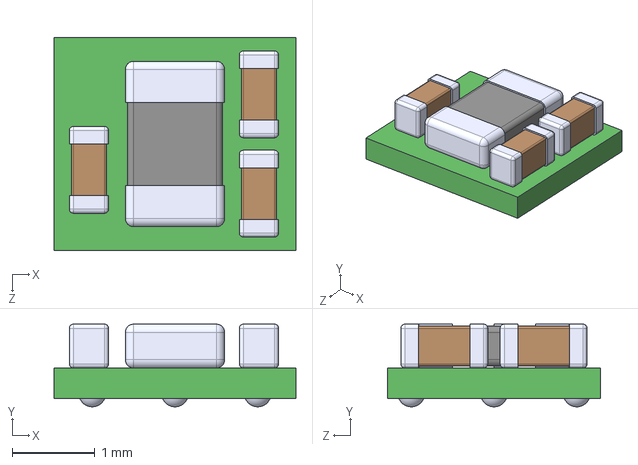
[picture p48: CAD file, 2020-12-02]
spock/downloaded_libs/3D_Models/TPS8268150SIPT.STEP
2.92 x 1.00 x 2.58 mm
