PisterLab/scum-dev-board/(threads)

Thread 5 (2020-08-21):

Dimension SCuM footprint

afearing, 2020-08-21:
I don't know what dimensions the footprint for SCuM should have. It would be easy to measure if I had a blank dev board.

afearing, 2020-10-07:
Done. Looked at Altium drawing. Looks like 12mm x 12mm with 0.2mm x 0.8mm contacts at 0.4mm pitch. 100 pin.

Closed 2020-10-07.

Thread 6 (2020-08-22):

Resize cap and resistor footprints

afearing, 2020-08-22:
I don't know what size these should be. Ideally as small as possible, but maybe the placement machine has a lower limit.

afearing, 2020-10-07:
Done. Pretty sure they're all 0402.

Closed 2020-10-07.

Thread 15 (2021-01-29):

Remove LED pads

afearing, 2021-01-29:
We don't need the LED, but the pad is still there so it can be probed to see if scum programmed

afearing, 2021-04-14:
Done.

Closed 2021-04-14.

Thread 17 (2021-02-05):

Connect antenna

afearing, 2021-02-05:

afearing, 2021-04-14:
Put a header pin with a short trace.

Closed 2021-04-14.

Thread 19 (2021-02-17):

Create map of pins

afearing, 2021-02-17:
The silkscreen labels got screwed up (probably added a pin without changing the labels on them) and the kicad nets lost their names, so it's hard to figure out the pins on the IRL board in 2/2021.

Thread 22 (2021-03-12):

Use larger IMU package

afearing, 2021-03-12:
The QFN-24 3x3mm package is really hard to work with.  Swap it to something with larger connections.

afearing, 2021-03-17:
https://invensense.tdk.com/products/motion-tracking/9-axis/icm-20948/
It looks like this IMU only comes in the 3x3 mm package.

afearing, 2021-04-14:
Can't be done and not needed.

Closed 2021-04-14.

Thread 26 (2021-04-14):

Courtyard for battery clip

afearing, 2021-04-14:
Need to figure out how much space it takes. Thought I did this but it doesn't show.

afearing, 2021-04-16:
Done

Closed 2021-04-16.
