PisterLab/scum-dev-board/spock/Images/bigBoard_bond_diagram_for_self_testing OUT OF DATE DO NOT USE.pdf

I

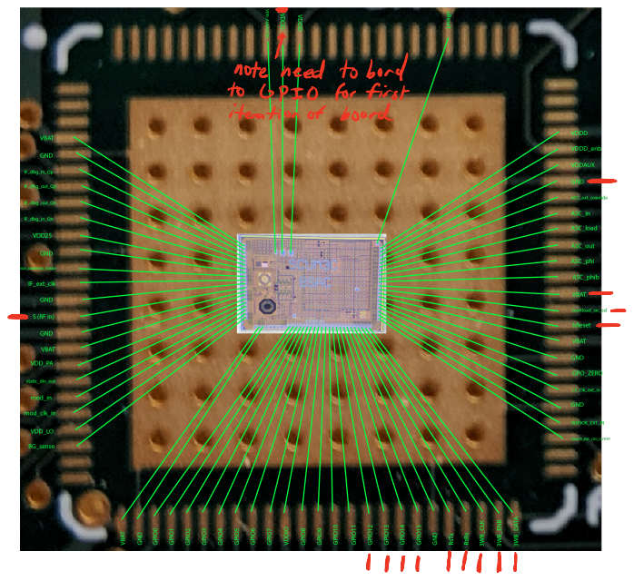
[picture p49: page 1]
note; need tobond; PIO for first; iteration of board; r ppp I l f I I
