PisterLab/scum-dev-board/SCM3C_PCB.pdf

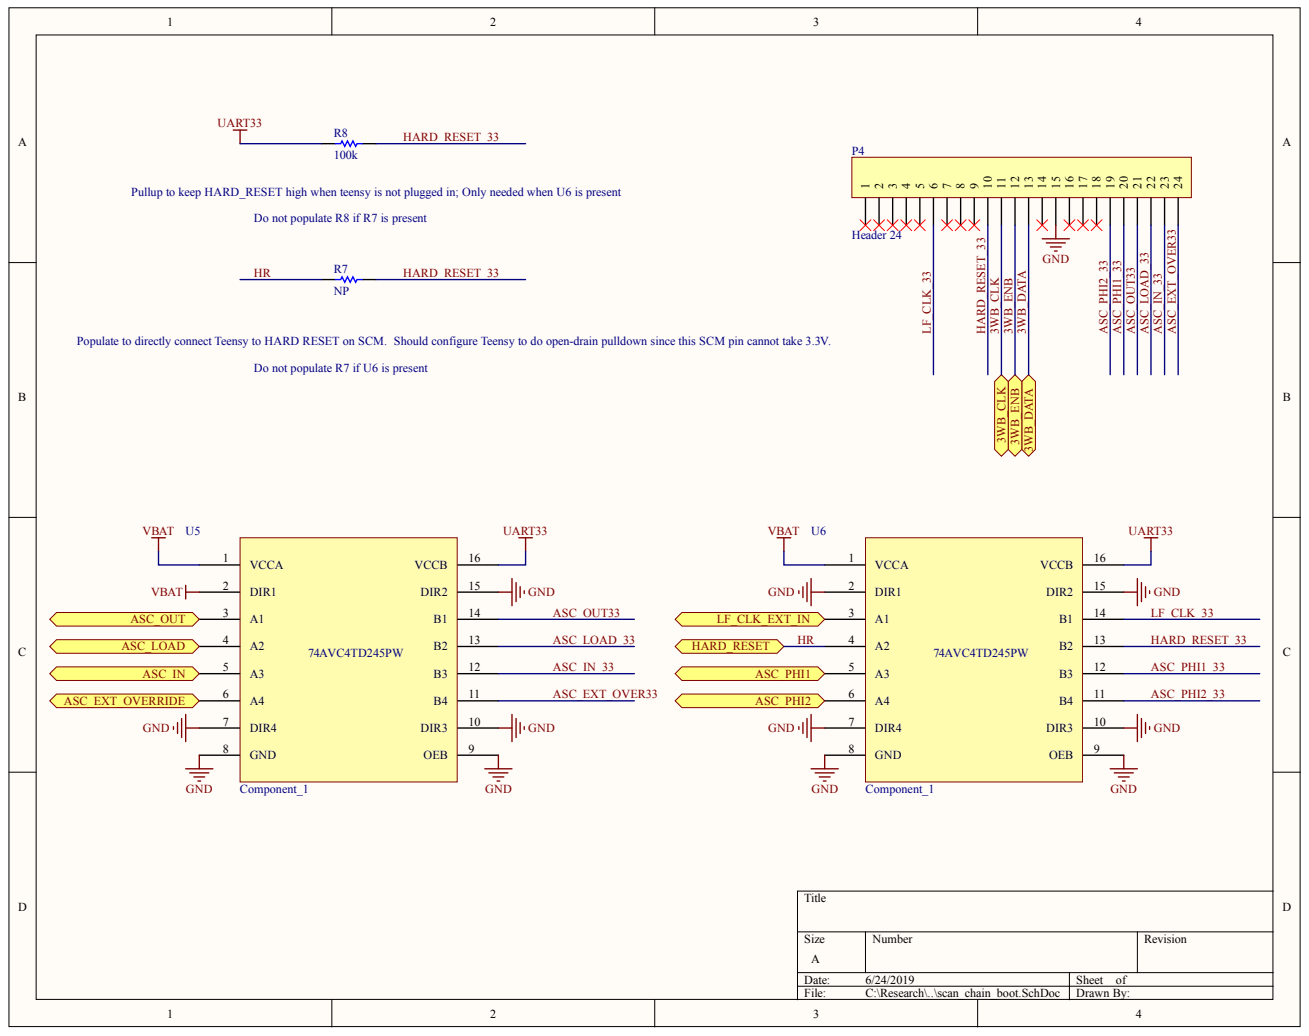
[picture p50: page 1]
Title; Size; Number; Revision; Date:; Sheet of; File:; C:\Research\..\scan_chain_boot.SchDoc; Drawn By:; Header 24; GND; ASC_EXT_O; VER33; ASC_IN_33; ASC_LO; ASC_O; ASC_PHI1_33; ASC_PHI2_33; ATA; 3WB_ENB; 3WB_CLK; D_RESET_33; VCCA 1; DIR1 2; DIR4 7; GND 8; OEB; DIR3; DIR2; VCCB; 74AVC4TD245PW; Component_1; VBAT; UART33; ASC_EXT_OVER33; ASC_LOAD_33; ASC_OUT33; HARD_RESET_33; LF_CLK_33; ASC_EXT_OVERRIDE; ASC_IN; ASC_LOAD; LF_CLK_EXT_IN; HARD_RESET; ASC_PHI2; ASC_PHI1; ASC_OUT

Pullup to keep HARD_RESET high when teensy is not plugged in; Only needed when U6 is present

Do not populate R8 if R7 is present

Populate to directly connect Teensy to HARD RESET on SCM. Should configure Teensy to do open-drain pulldown since this SCM pin cannot take 3.3V.

Do not populate R7 if U6 is present

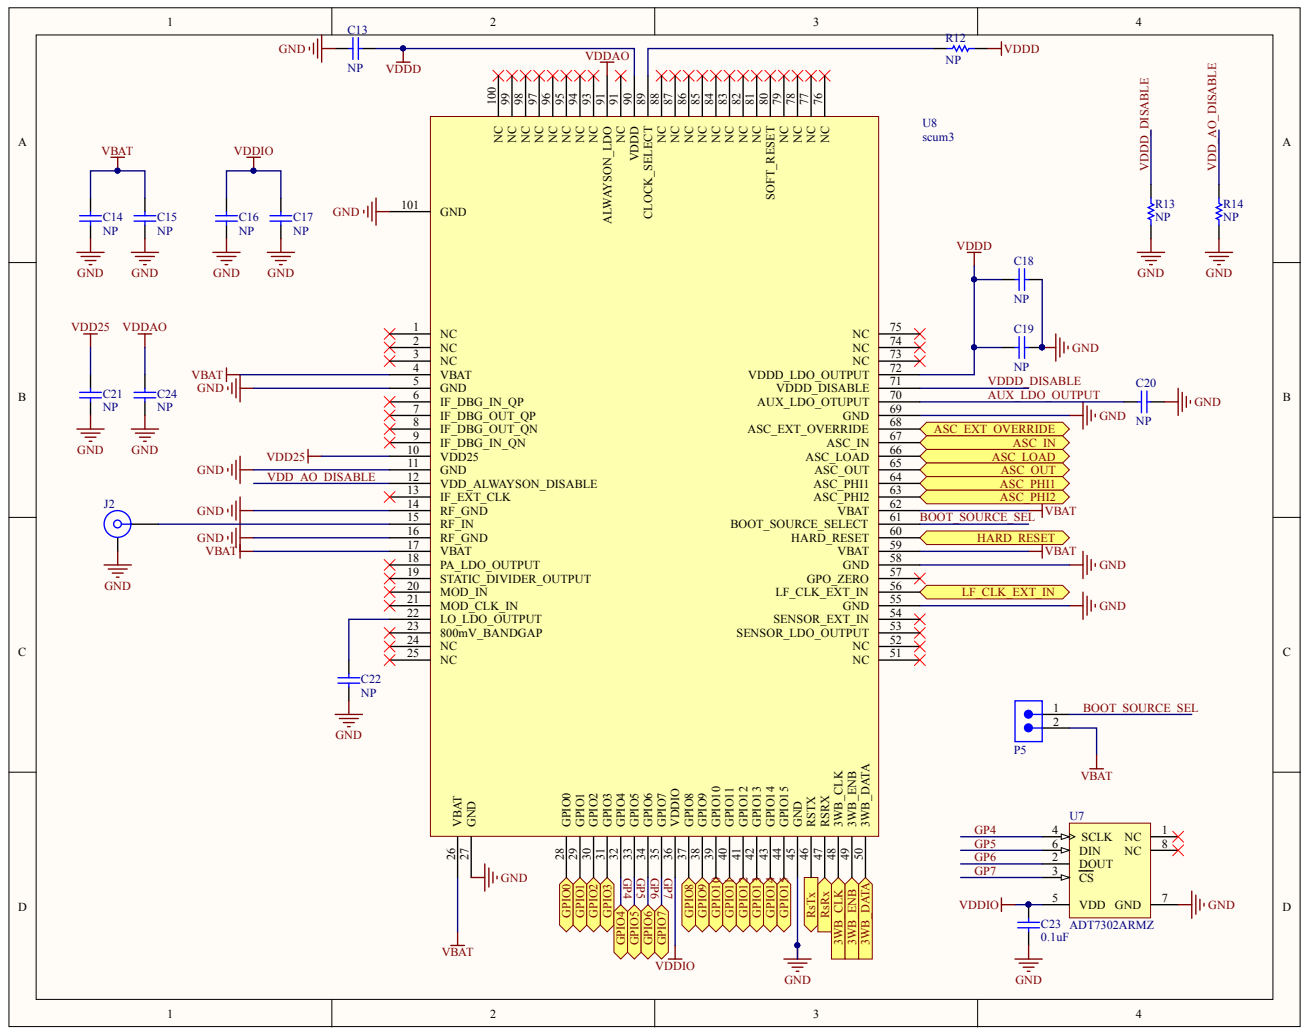
[picture p51: page 2]

NC 81 NC 82 NC 83 NC 84 NC 85 NC 86 NC 87 NC 88 CLOCK_SELECT 89 V

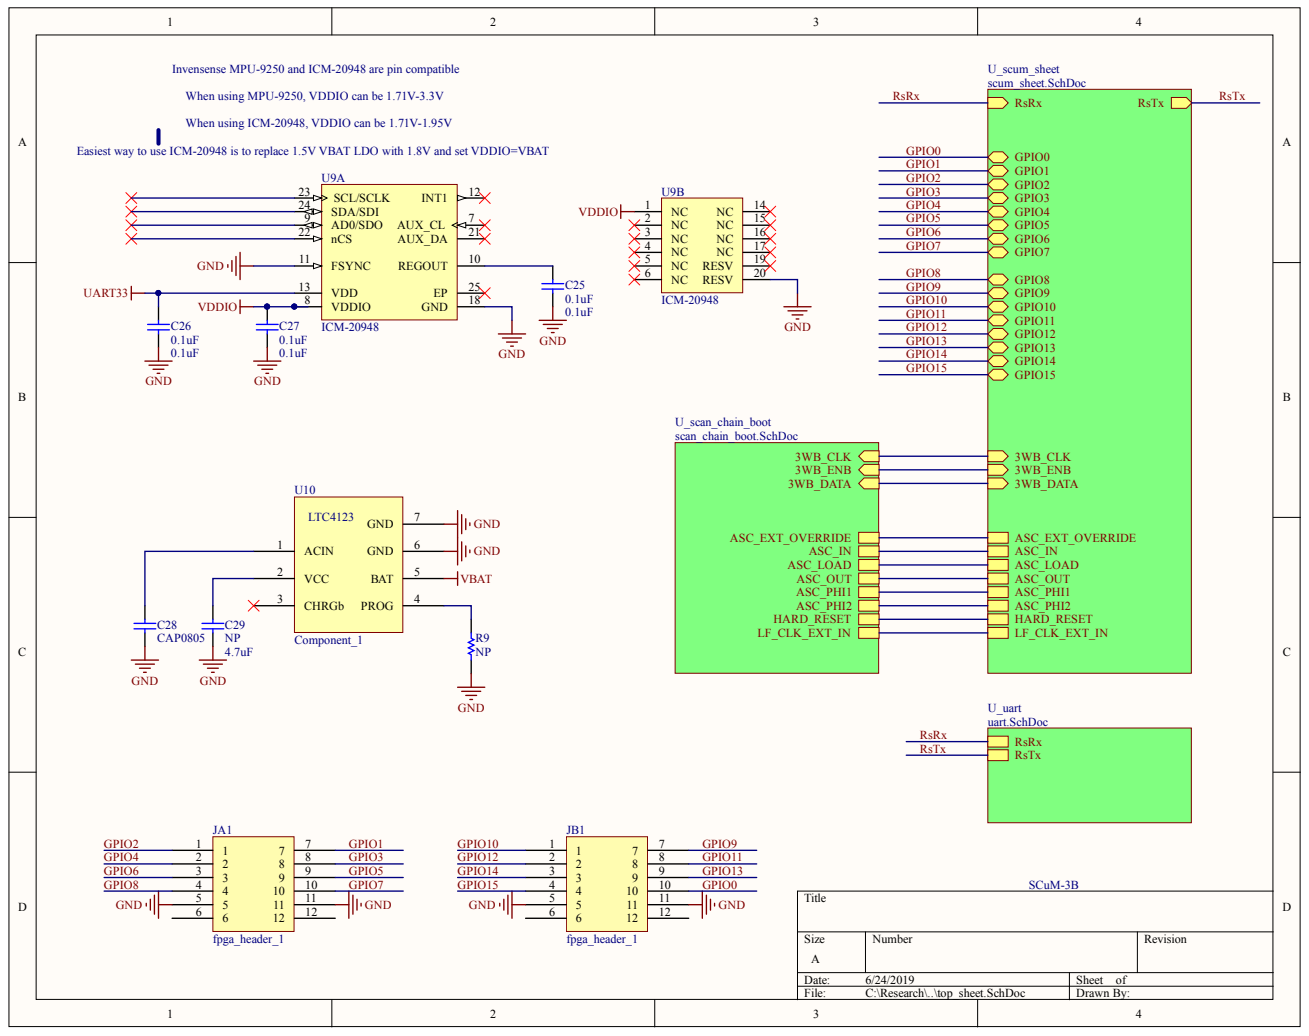
[picture p52: page 3]

Invensense MPU-9250 and ICM-20948 are pin compatible

When using MPU-9250, VDDIO can be 1.71V-3.3V

When using ICM-20948, VDDIO can be 1.71V-1.95V

Easiest way to use ICM-20948 is to replace 1.5V VBAT LDO with 1.8V and set VDDIO=VBAT

# RT33 VBAT

## R1 NP

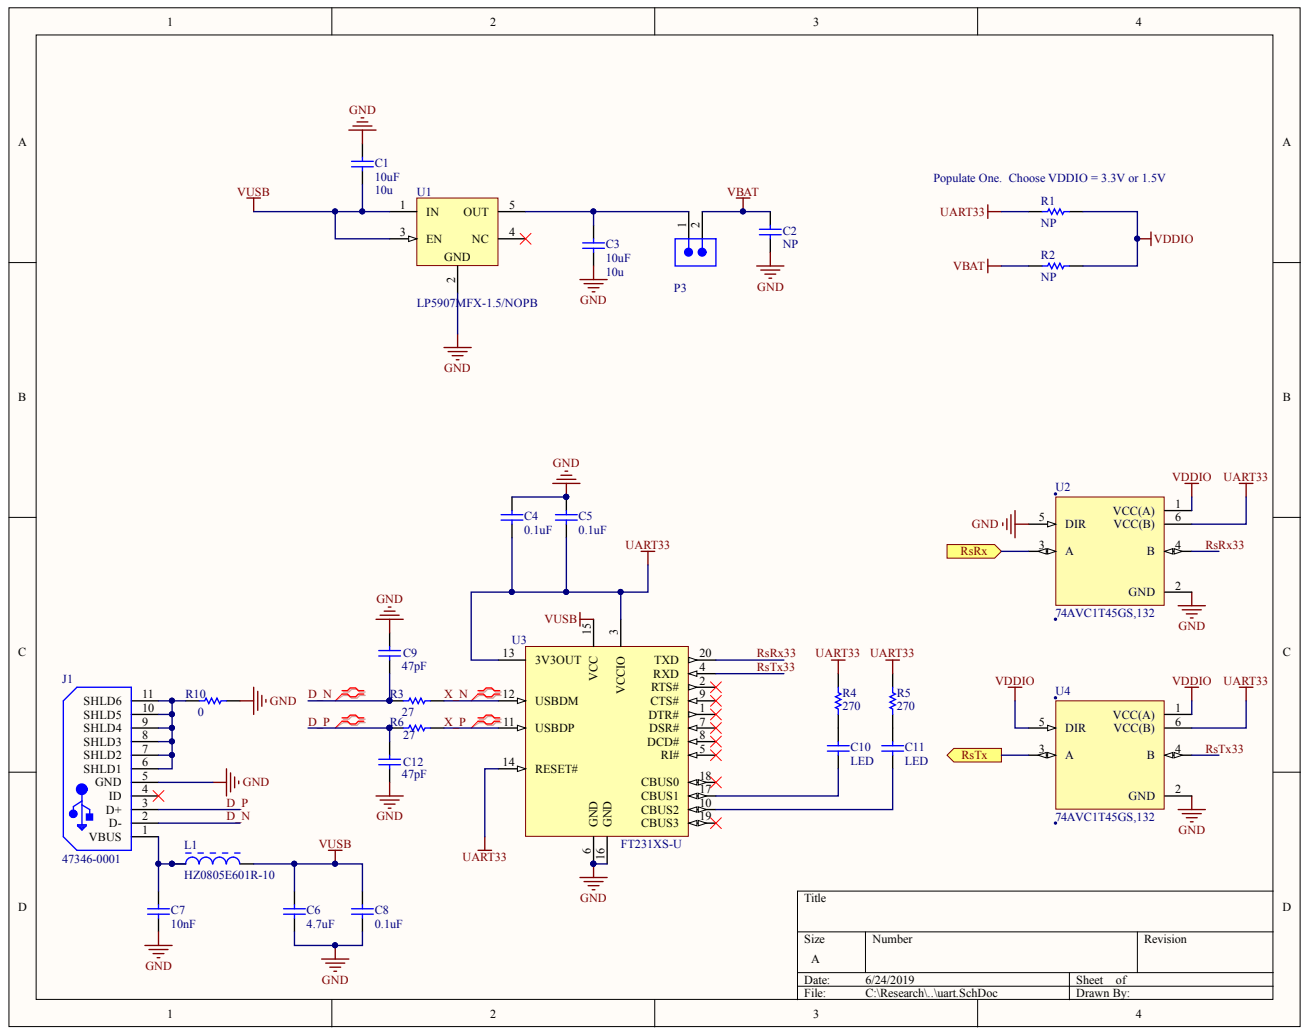
[picture p53: page 4]

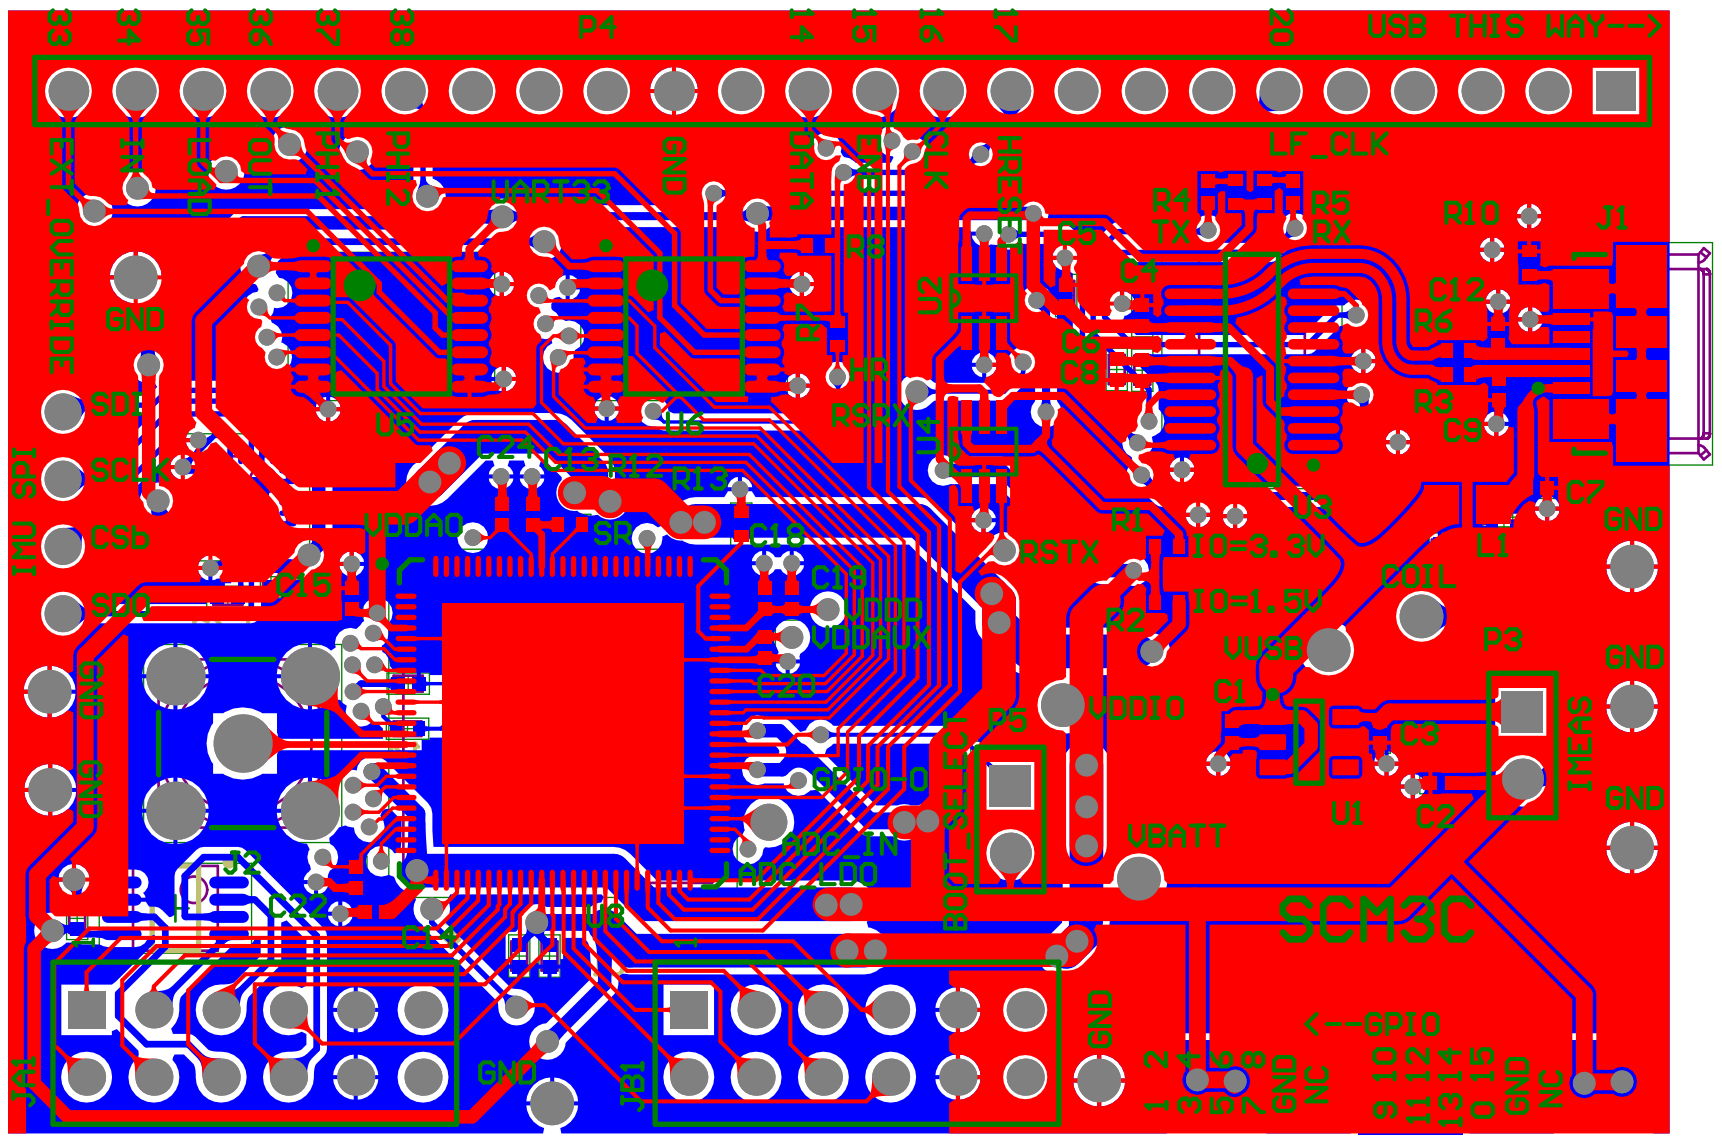
[picture p54: page 5]

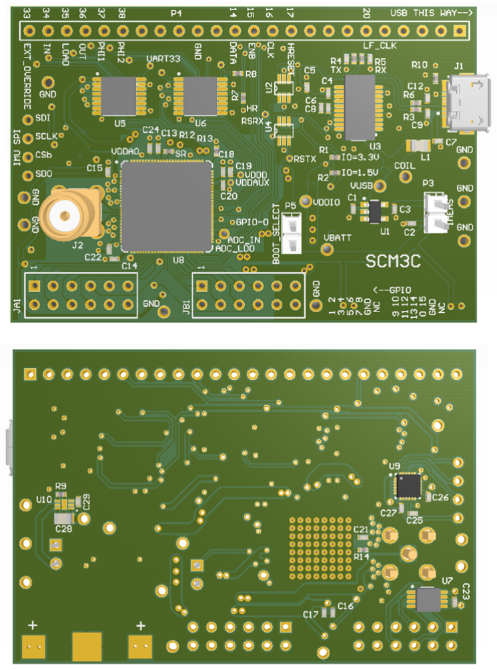
[picture p55: page 6]
