PisterLab/scum-dev-board/sulu-ldo/pictures/smallBoard_bond_diagram_for_self_testing.pdf

# org

# Etf

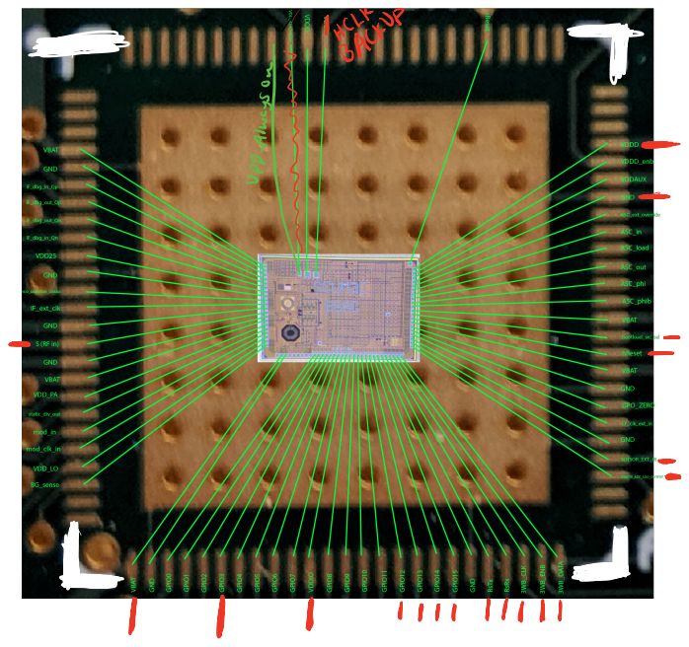
[picture p56: page 1]
Todd; Kiffin; and; a pro 11111
