PisterLab/scum-dev-board/sulu-ads1299/sulu_ads1299_sch_full.pdf

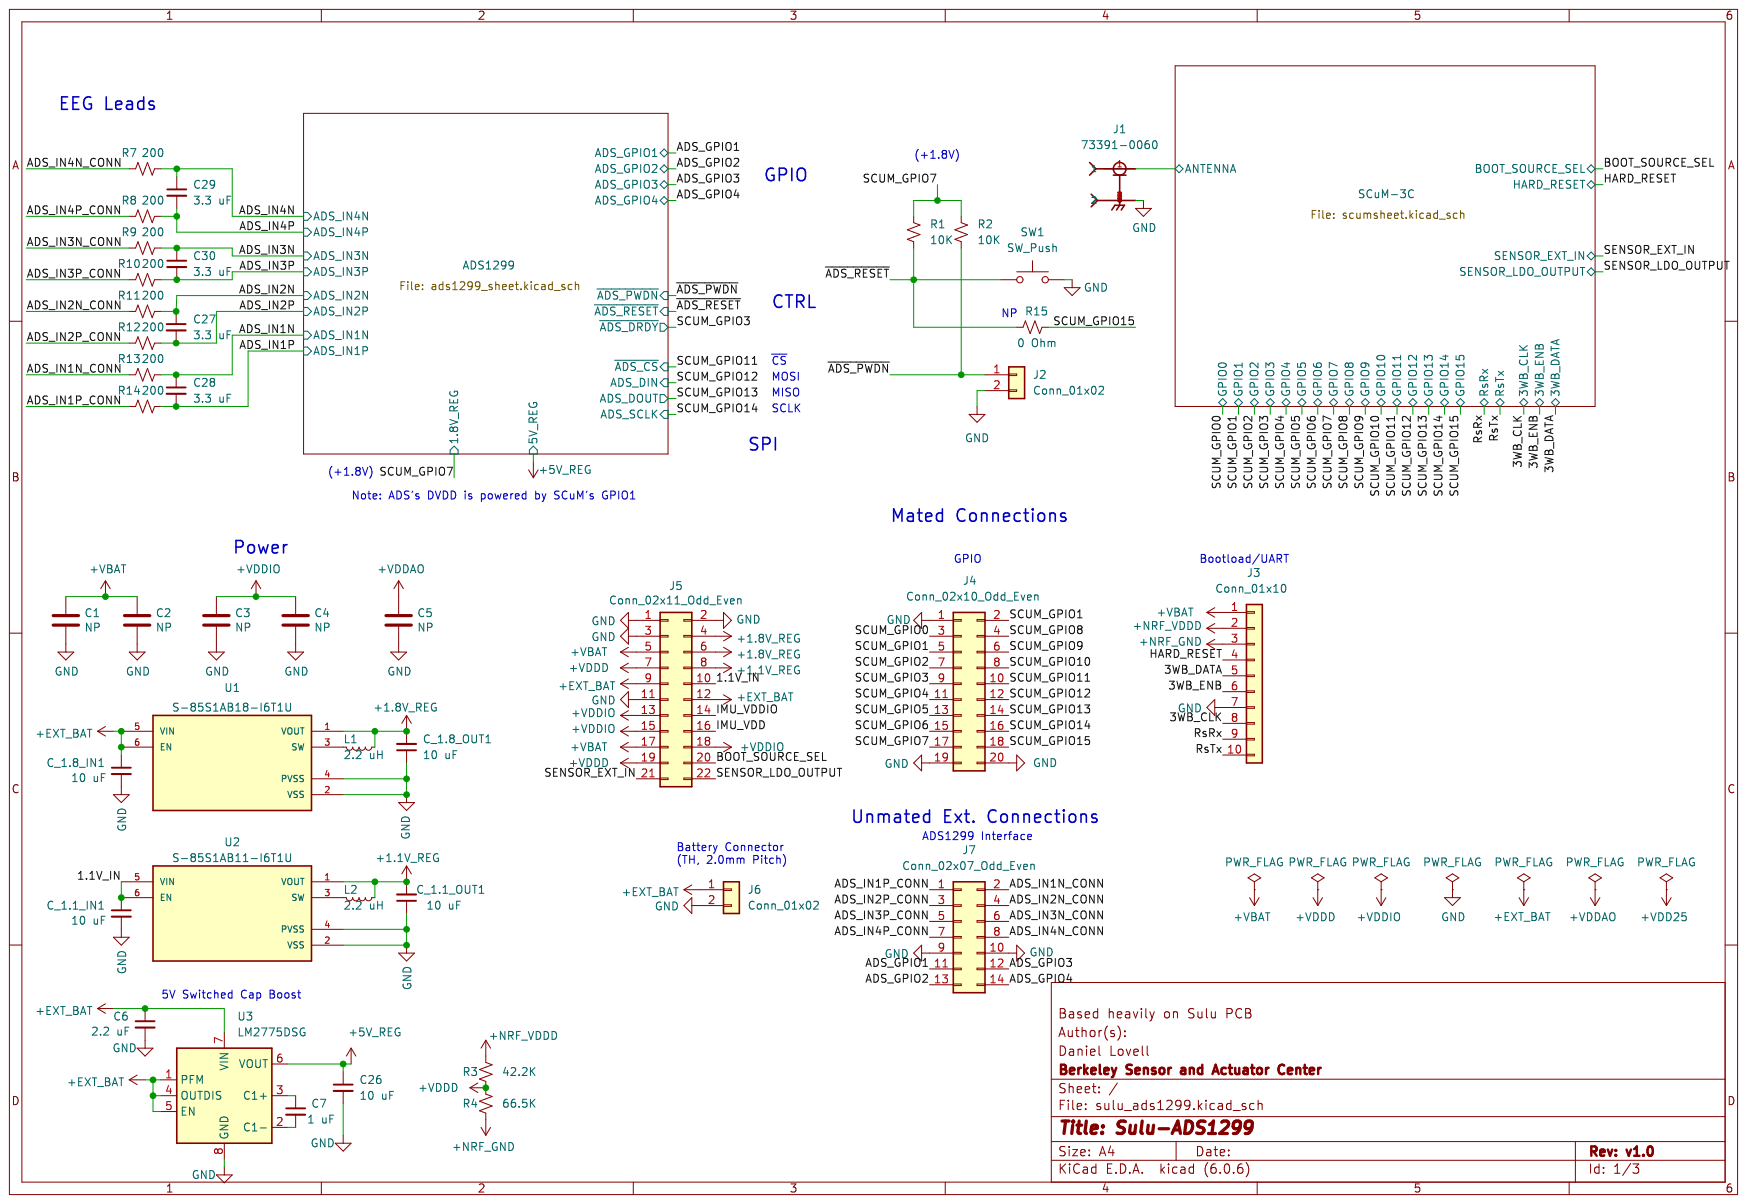
[picture p57: page 1]

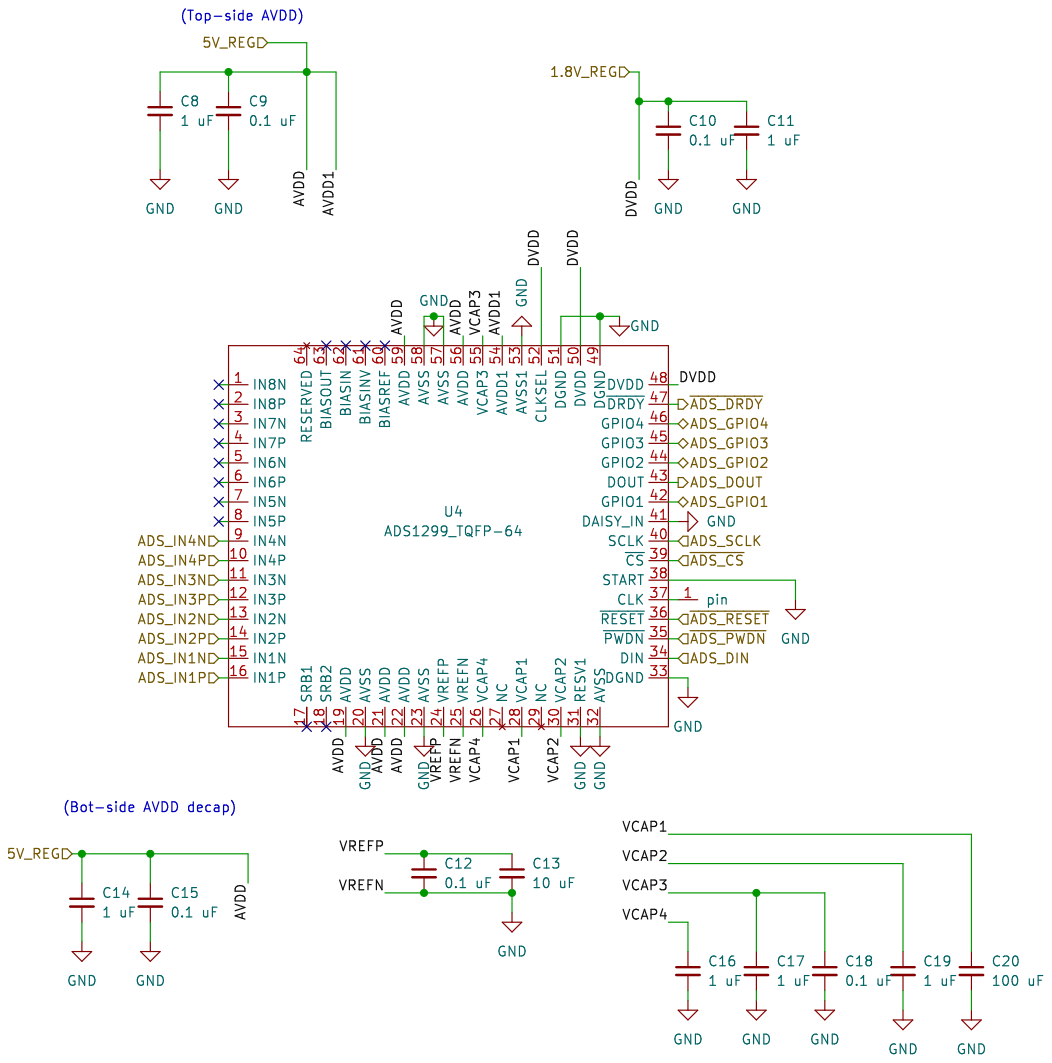
[picture p58: page 2]

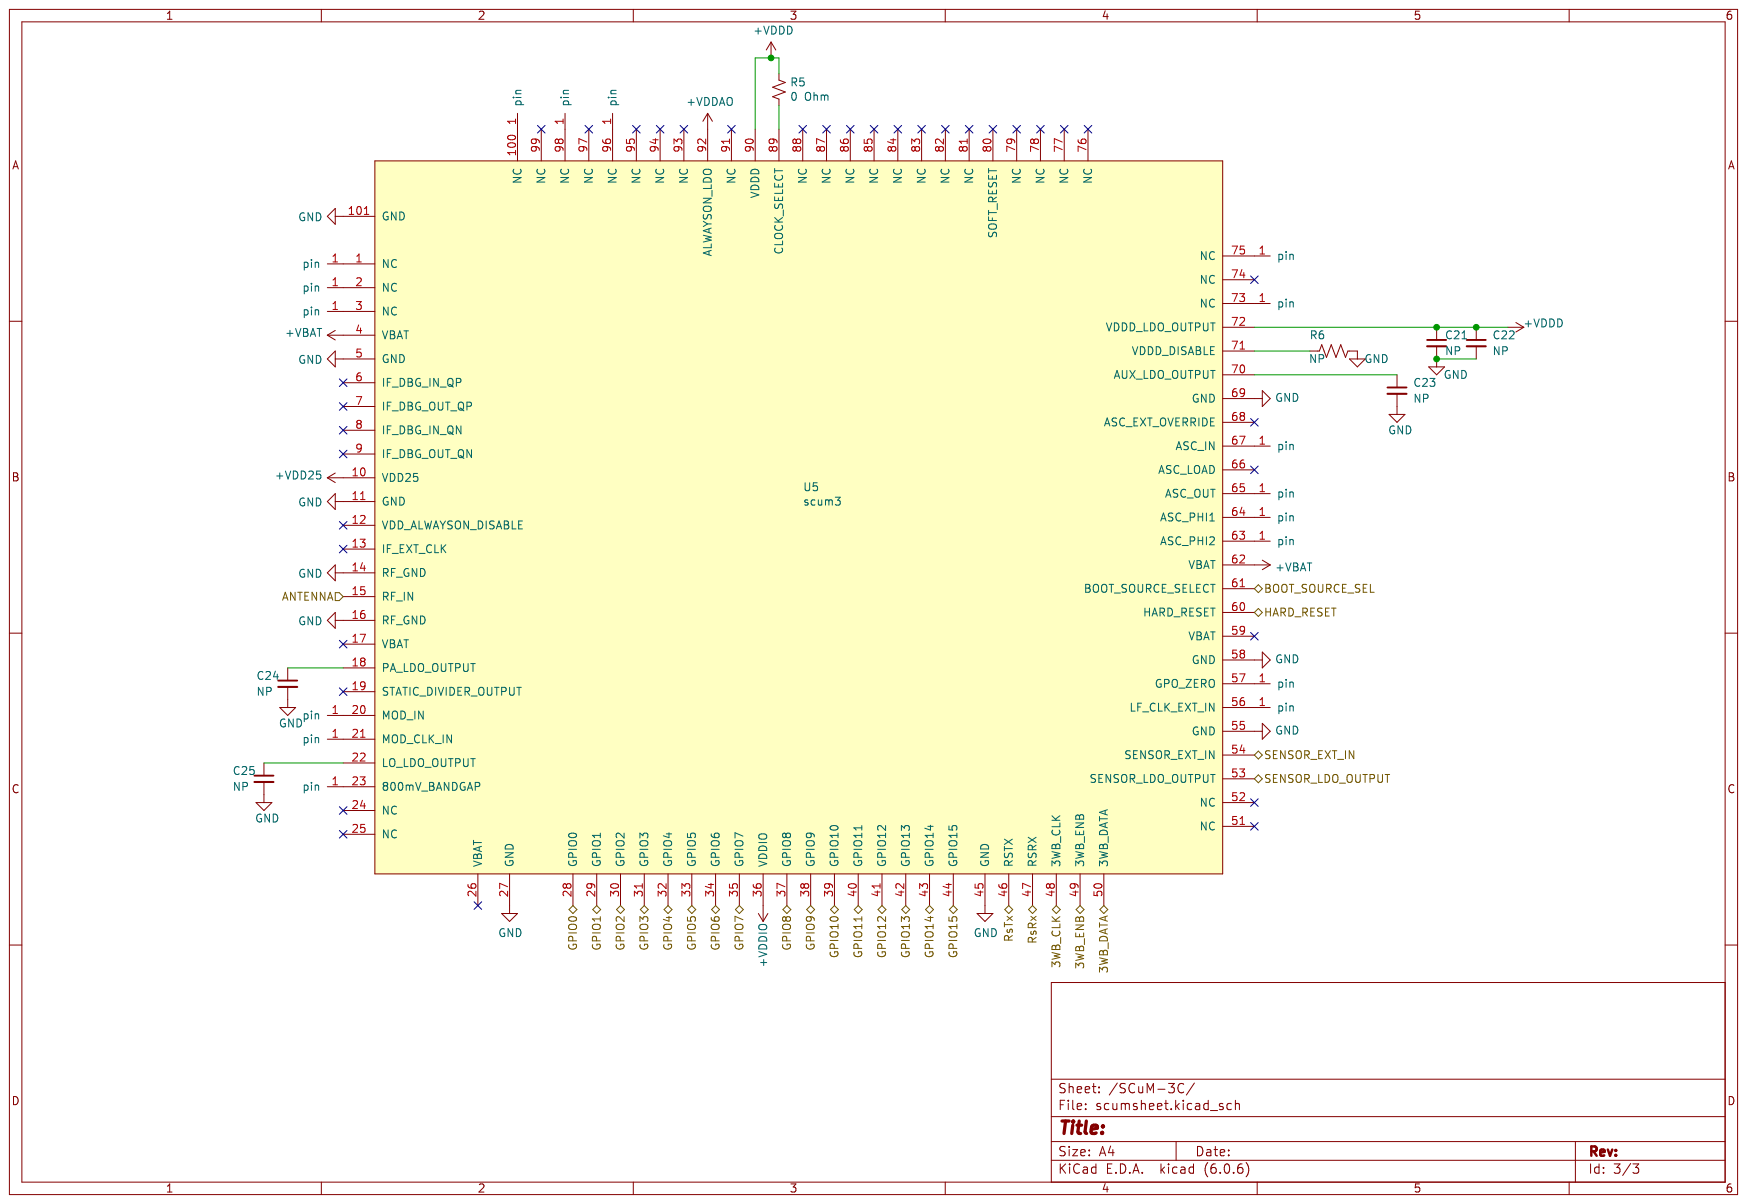
[picture p59: page 3]
