PisterLab/scum-dev-board/spock/Images/scum3c-devboard.pdf

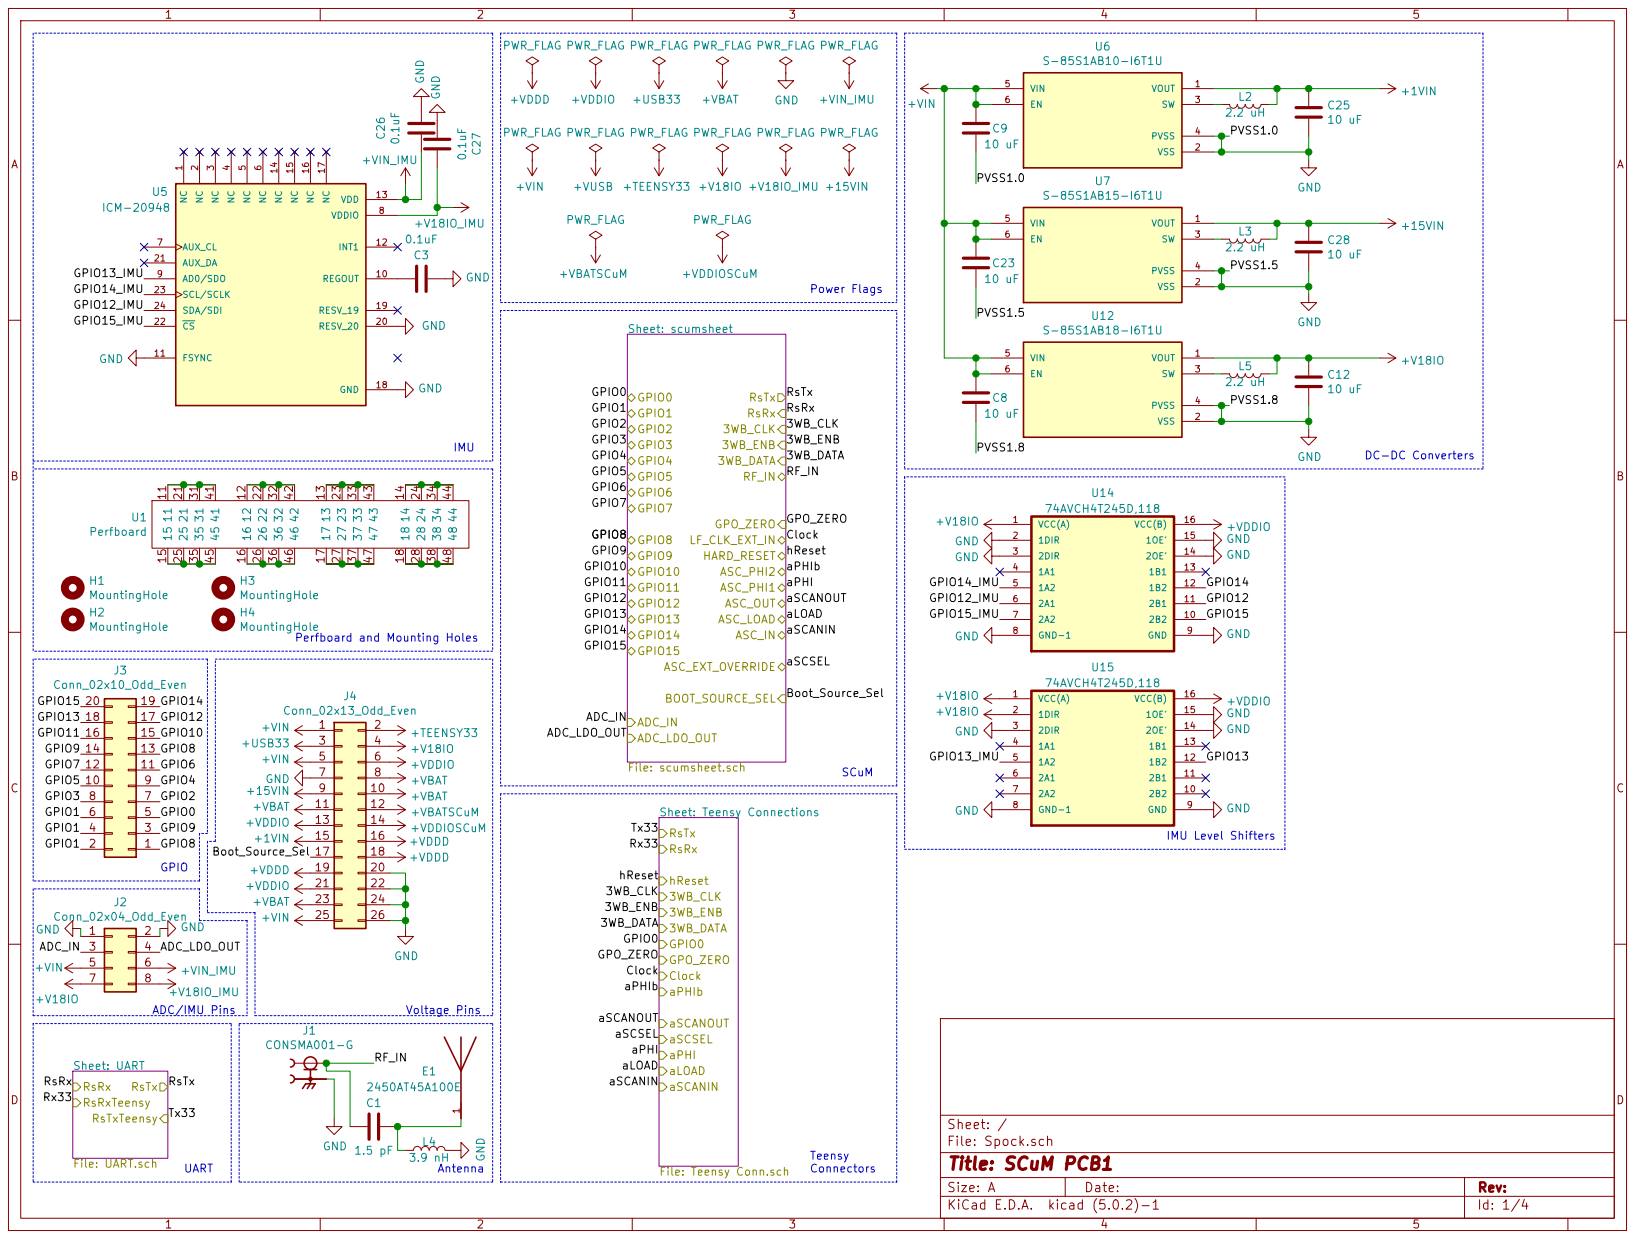
[picture p60: page 1]

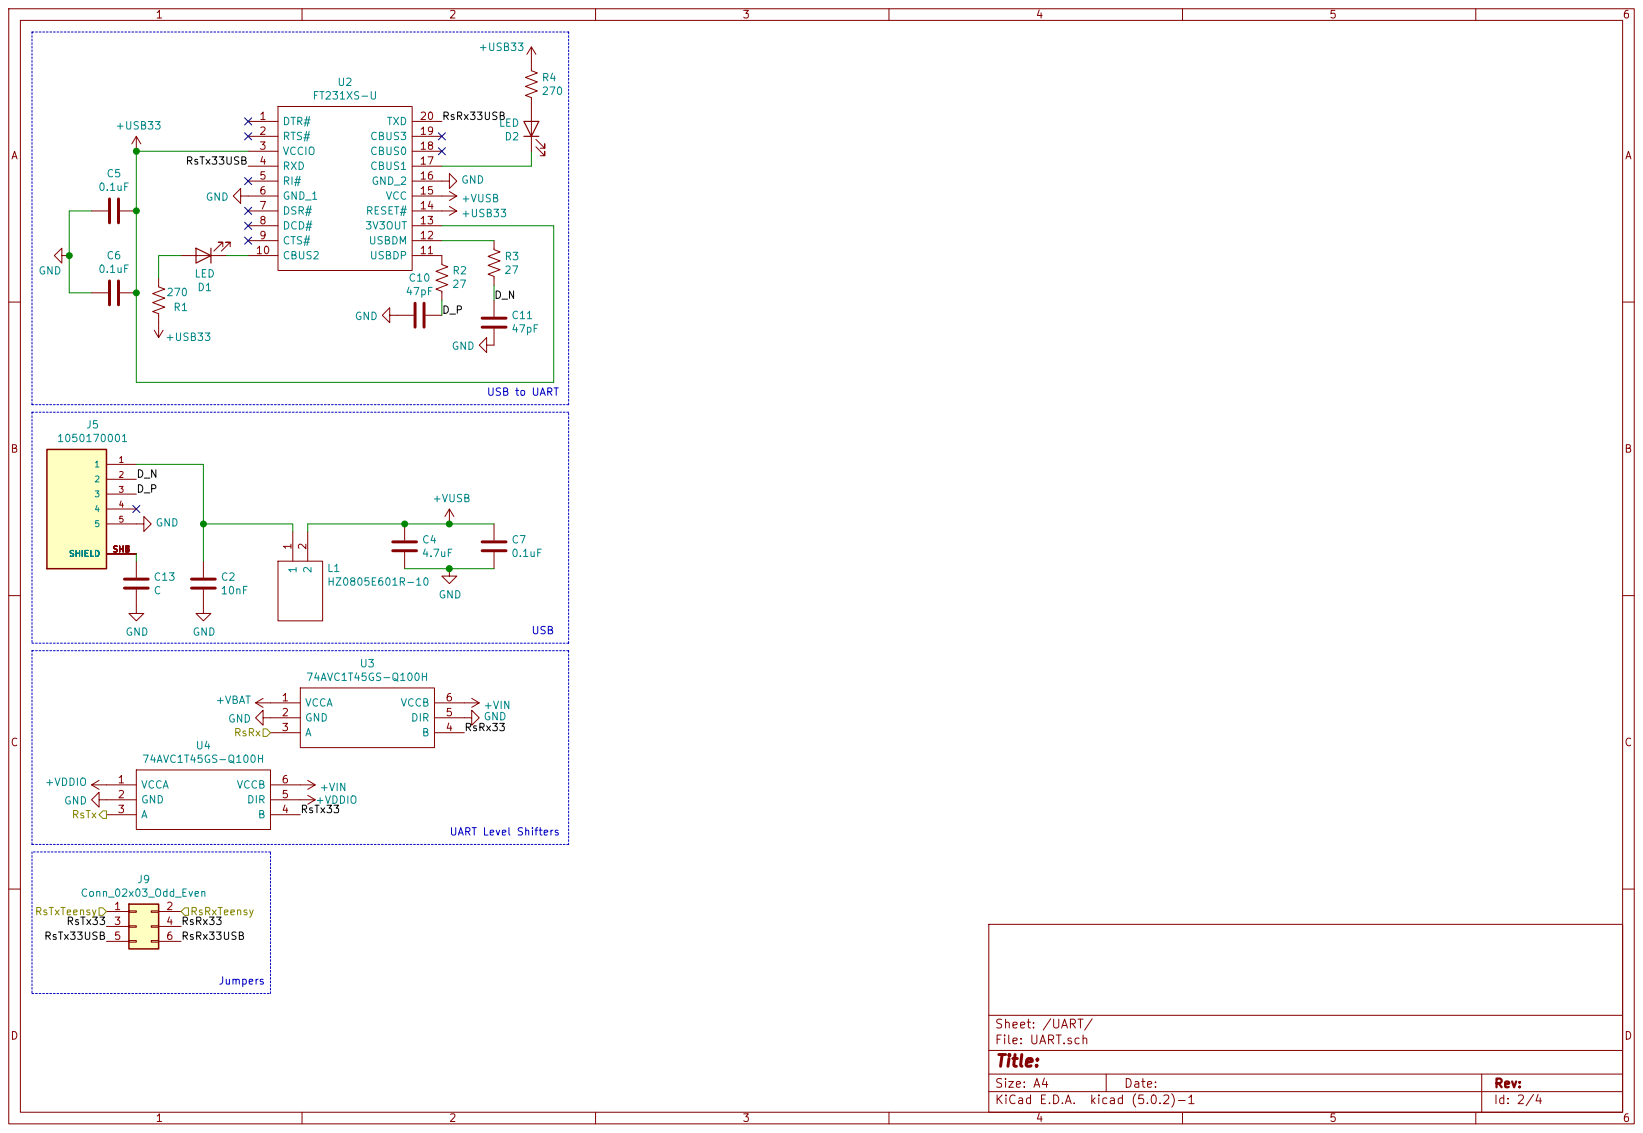
[picture p61: page 2]

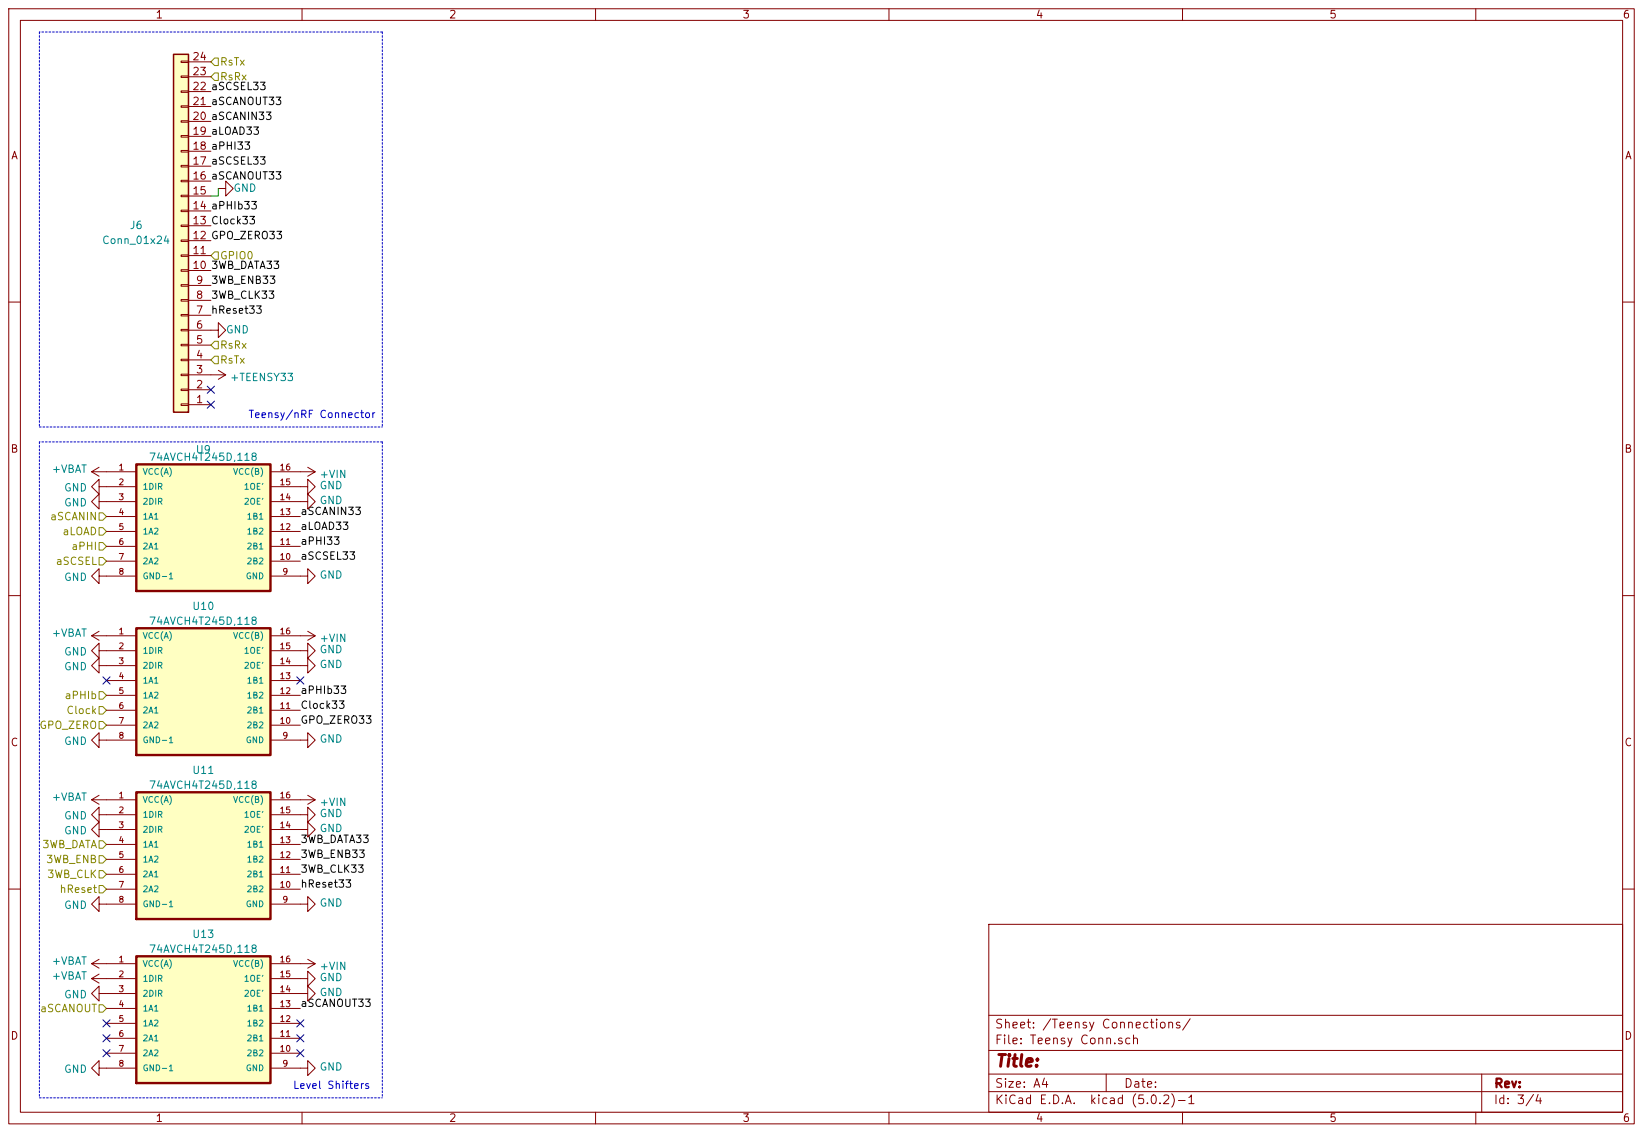
[picture p62: page 3]

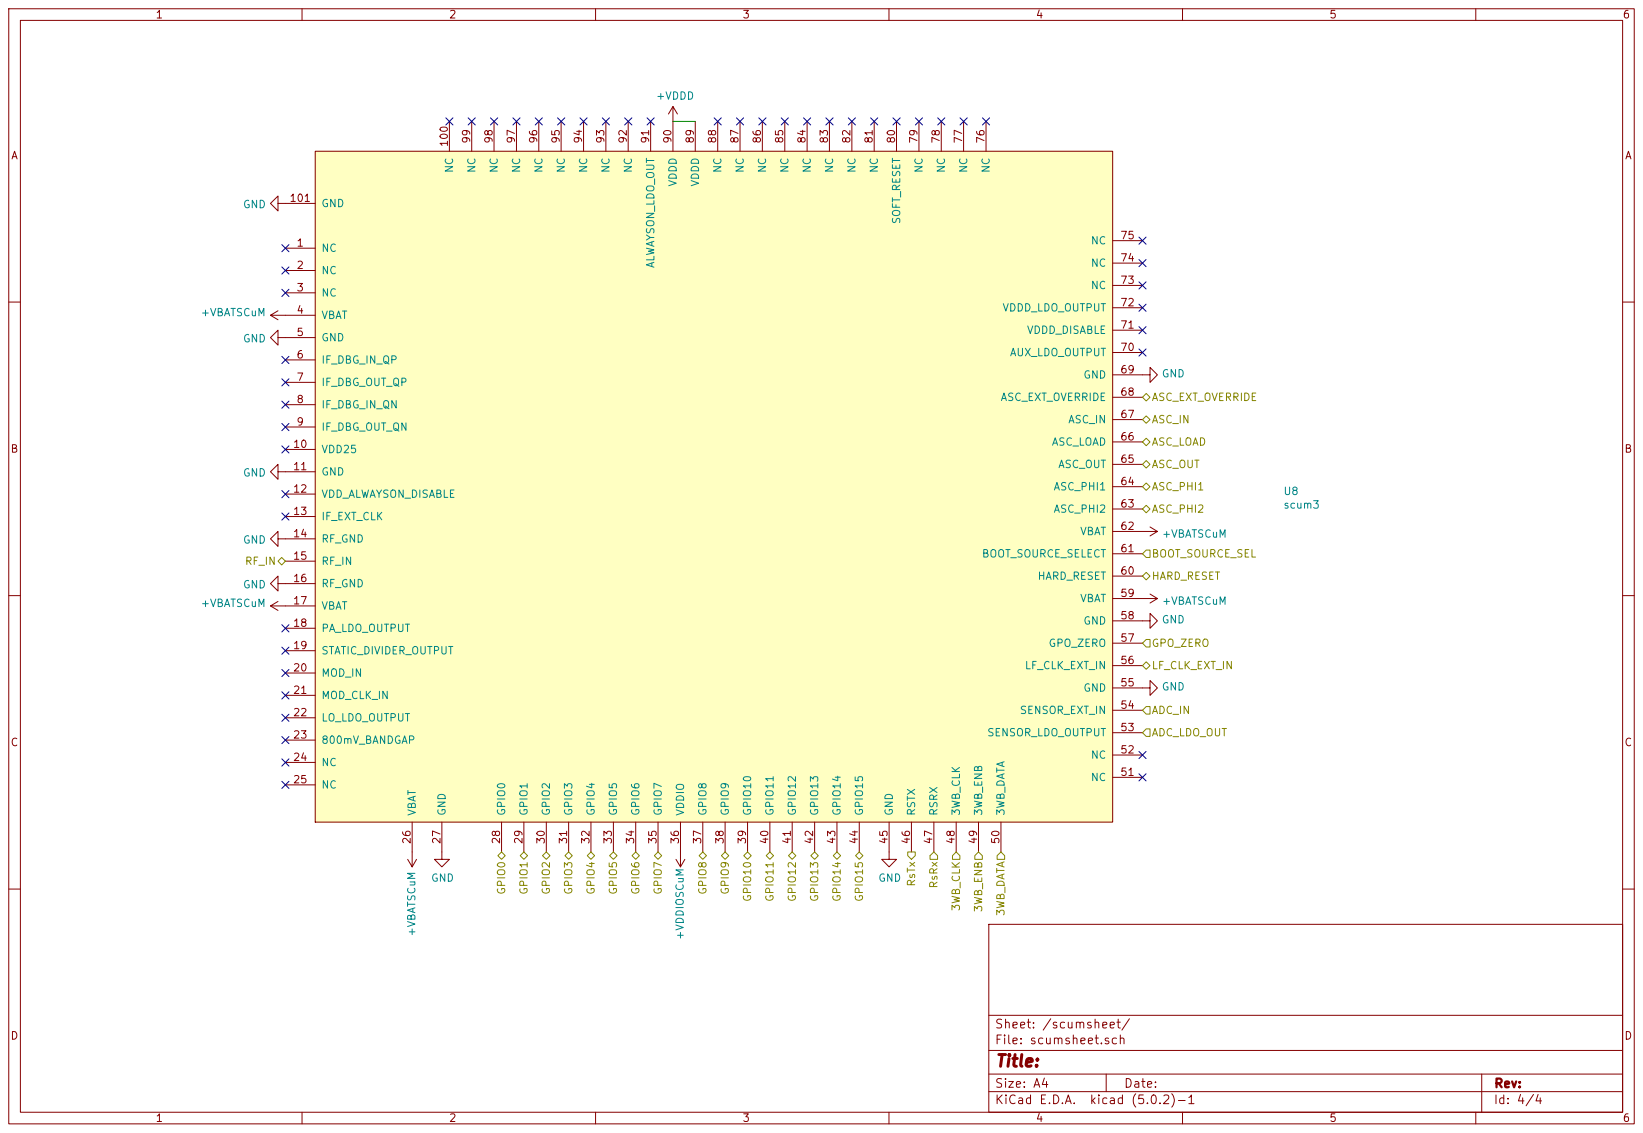
[picture p63: page 4]
