PisterLab/scum-dev-board/(list of files, drawings)

Other design files:
scum3c_devboard/draft1.dsn
