PisterLab/scum-dev-board/pico-w-breakout/pico-w-breakout.kicad_pcb

## KiCad design pico-w-breakout/pico-w-breakout.kicad_pcb (2025-06-02)

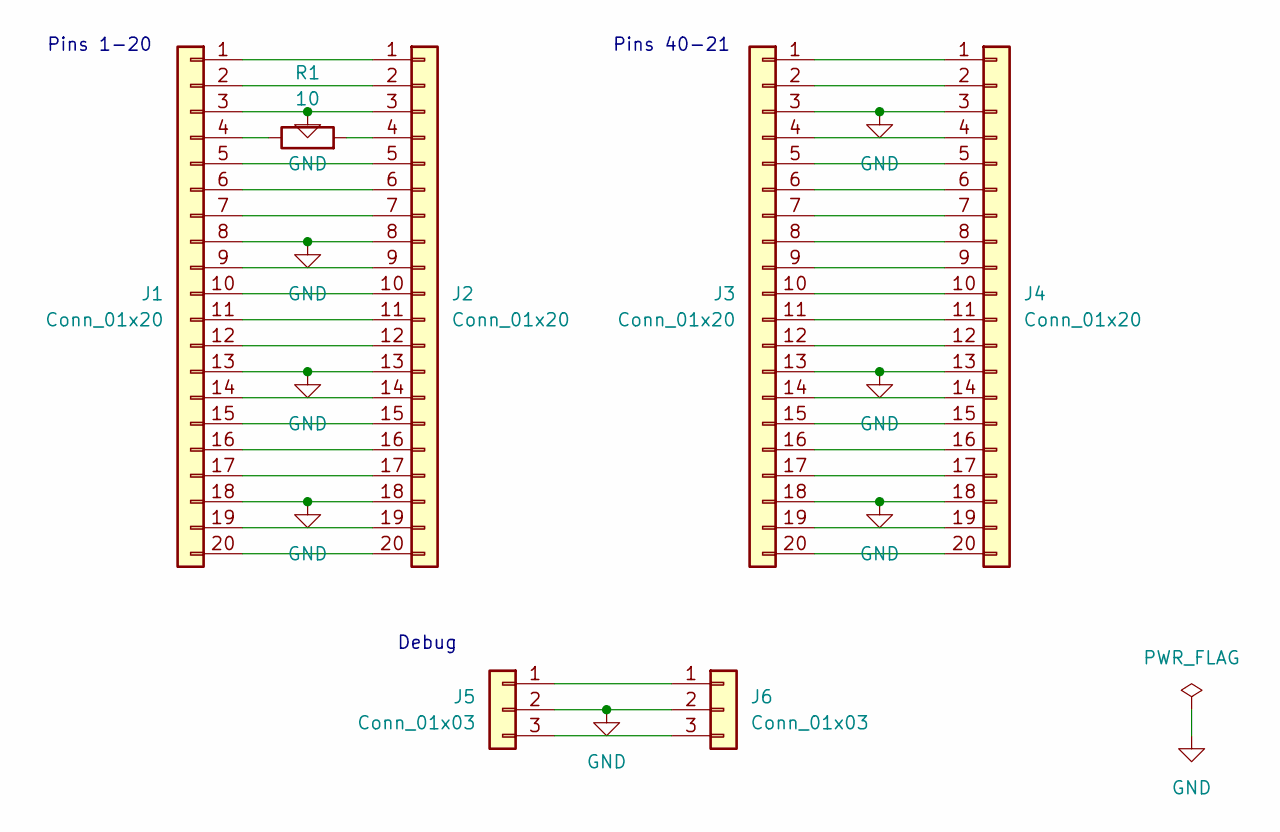
[picture p64: schematic pico-w-breakout.kicad_sch]

Parts:
J1, J4: Conn_01x20; PinHeader_1x20_P2.54mm_Vertical
J2, J3: Conn_01x20; PinSocket_1x20_P2.54mm_Vertical
J5: Conn_01x03; PinHeader_1x03_P2.54mm_Vertical
J6: Conn_01x03; PinSocket_1x03_P2.54mm_Vertical
R1: 10; R_0603_1608Metric

Connections:
GND: J1.3, J1.8, J1.13, J1.18, J2.3, J2.8, J2.13, J2.18, J3.3, J3.13, J3.18, J4.3, J4.13, J4.18, J5.2, J6.2
unnamed: J1.1, J2.1
unnamed: J1.2, J2.2
unnamed: J1.4, R1.1
unnamed: J1.5, J2.5
unnamed: J1.6, J2.6
unnamed: J1.7, J2.7
unnamed: J1.9, J2.9
unnamed: J1.10, J2.10
unnamed: J1.11, J2.11
unnamed: J1.12, J2.12
unnamed: J1.14, J2.14
unnamed: J1.15, J2.15
unnamed: J1.16, J2.16
unnamed: J1.17, J2.17
unnamed: J1.19, J2.19
unnamed: J1.20, J2.20
unnamed: J2.4, R1.2
unnamed: J3.1, J4.1
unnamed: J3.2, J4.2
unnamed: J3.4, J4.4
unnamed: J3.5, J4.5
unnamed: J3.6, J4.6
unnamed: J3.7, J4.7
unnamed: J3.8, J4.8
unnamed: J3.9, J4.9
unnamed: J3.10, J4.10
unnamed: J3.11, J4.11
unnamed: J3.12, J4.12
unnamed: J3.14, J4.14
unnamed: J3.15, J4.15
unnamed: J3.16, J4.16
unnamed: J3.17, J4.17
unnamed: J3.19, J4.19
unnamed: J3.20, J4.20
unnamed: J5.1, J6.1
unnamed: J5.3, J6.3

Notes on the sheet:
Pins 40-21
Debug
Pins 1-20

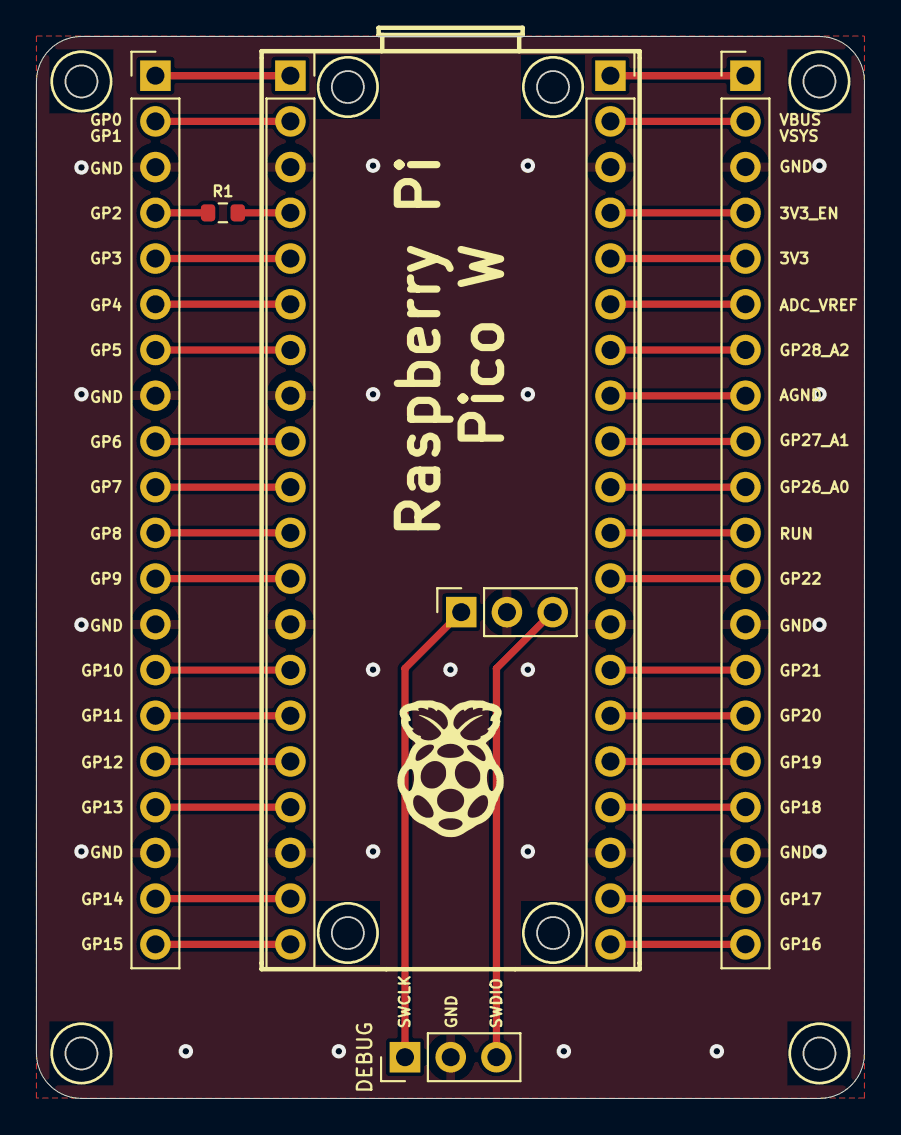
[picture p65: board pico-w-breakout.kicad_pcb from above]

Board: 2 copper layers, 46.0 x 59.0 mm, 7 parts (0 on the bottom side), 37 nets.
