PisterLab/scum-dev-board/sulu-reg/scum3c-devboard.kicad_pcb

## KiCad design sulu-reg/scum3c-devboard.kicad_pcb (2024-09-16)

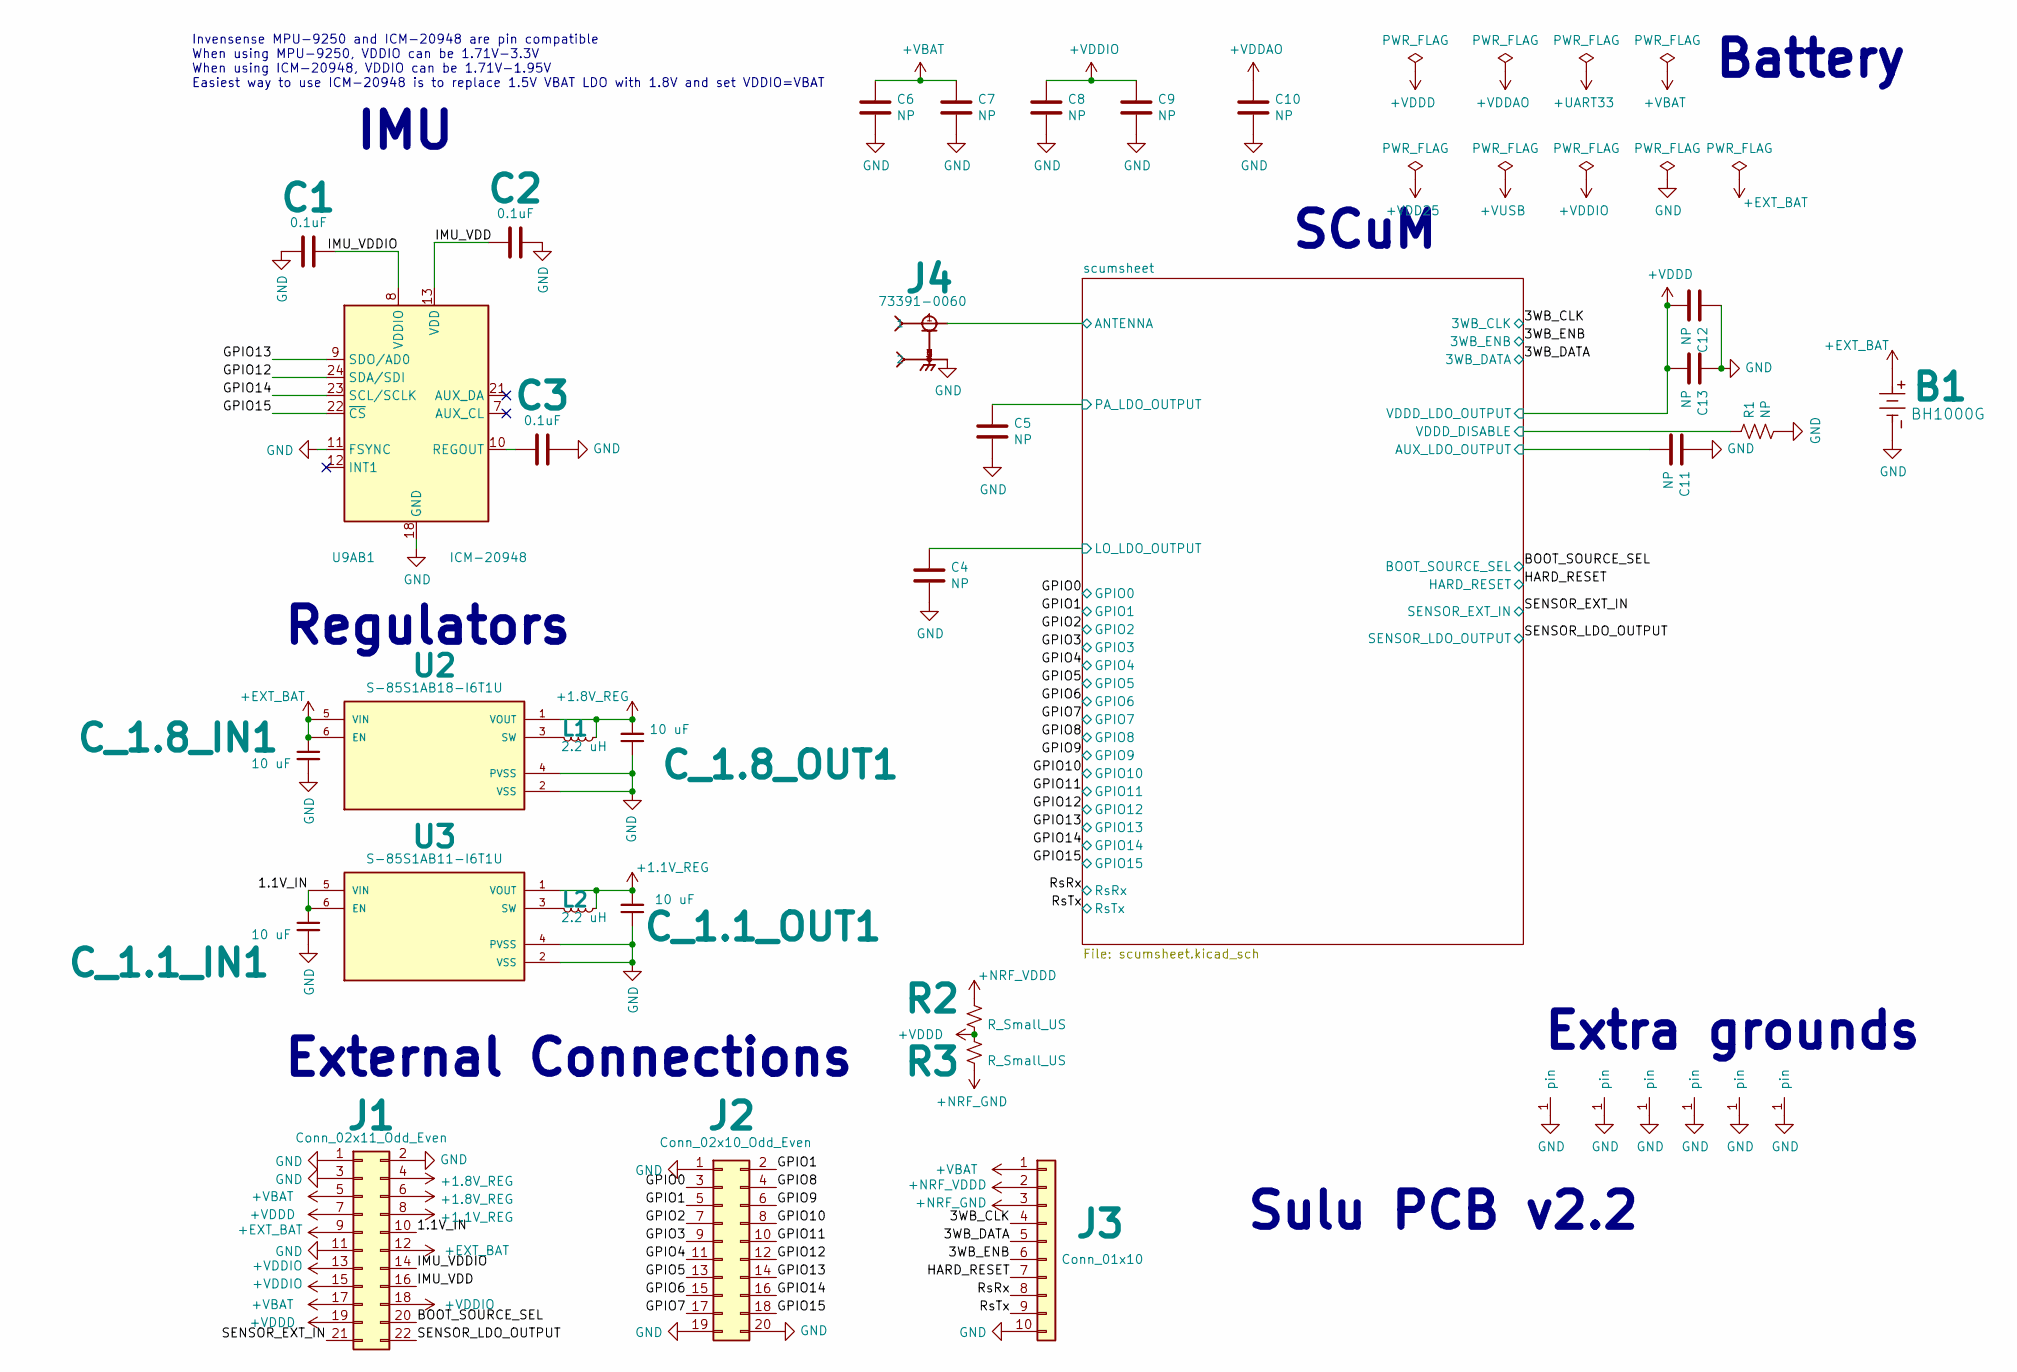
[picture p66: schematic scum3c-devboard.kicad_sch, SCuM PCB1]

Parts:
B1: BH1000G
C1, C2, C3: 0.1uF; C_0402_1005Metric
C4, C5, C6, C7, C8, C9, C10, C11, C12, C13: NP; C_0402_1005Metric
C_1.1_IN1, C_1.1_OUT1, C_1.8_IN1, C_1.8_OUT1: 10 uF; C_0402_1005Metric
GND1, GND2, GND3, GND4, GND5, GND6: through_hole
J1: Conn_02x11_Odd_Even; PinHeader_2x11_P2.54mm_Vertical
J2: Conn_02x10_Odd_Even; PinHeader_2x10_P2.54mm_Vertical
J3: Conn_01x10; PinHeader_1x10_P2.54mm_Vertical
J4: 73391-0060; MOLEX_73391-0060
L1, L2: 2.2 uH; L_Wuerth_MAPI-2010
R1: NP; R_0402_1005Metric
R2, R3: R_Small_US; R_0402_1005Metric
U2: S-85S1AB18-I6T1U; SOFL50P180X50-6N; PARTREV 1.4_00
U3: S-85S1AB11-I6T1U; SOFL50P180X50-6N; PARTREV 1.4_00
U9AB1: ICM-20948; InvenSense_QFN-24_3x3mm_P0.4mm

Connections:
+1.1V_REG: C_1.1_OUT1.2, J1.8, L2.1, U3.1 (VOUT)
+1.8V_REG: C_1.8_OUT1.2, J1.4, J1.6, L1.1, U2.1 (VOUT)
+EXT_BAT: B1.2, C_1.8_IN1.1, J1.9, J1.12, U2.5 (VIN), U2.6 (EN)
+NRF_GND: J3.3, R3.2
+NRF_VDDD: J3.2, R2.1
+VBAT: C6.1, C7.1, J1.5, J1.17, J3.1; also elsewhere on the board
+VDDAO: C10.1; also elsewhere on the board
+VDDD: C12.2, C13.2, J1.7, J1.19, R2.2, R3.1; also elsewhere on the board
+VDDIO: C8.1, C9.1, J1.13, J1.15, J1.18; also elsewhere on the board
/1.1V_IN: C_1.1_IN1.1, J1.10, U3.5 (VIN), U3.6 (EN)
/3WB_CLK: J3.4; also elsewhere on the board
/3WB_DATA: J3.5; also elsewhere on the board
/3WB_ENB: J3.6; also elsewhere on the board
/BOOT_SOURCE_SEL: J1.20; also elsewhere on the board
/GPIO0: J2.3; also elsewhere on the board
/GPIO1: J2.2, J2.5; also elsewhere on the board
/GPIO2: J2.7; also elsewhere on the board
/GPIO3: J2.9; also elsewhere on the board
/GPIO4: J2.11; also elsewhere on the board
/GPIO5: J2.13; also elsewhere on the board
/GPIO6: J2.15; also elsewhere on the board
/GPIO7: J2.17; also elsewhere on the board
/GPIO8: J2.4; also elsewhere on the board
/GPIO9: J2.6; also elsewhere on the board
/GPIO10: J2.8; also elsewhere on the board
/GPIO11: J2.10; also elsewhere on the board
/GPIO12: J2.12, U9AB1.24 (SDA/SDI); also elsewhere on the board
/GPIO13: J2.14, U9AB1.9 (SDO/AD0); also elsewhere on the board
/GPIO14: J2.16, U9AB1.23 (SCL/SCLK); also elsewhere on the board
/GPIO15: J2.18, U9AB1.22 (~CS); also elsewhere on the board
/HARD_RESET: J3.7; also elsewhere on the board
/IMU_VDD: C2.1, J1.16, U9AB1.13 (VDD)
/IMU_VDDIO: C1.1, J1.14, U9AB1.8 (VDDIO)
/RsRx: J3.8; also elsewhere on the board
/RsTx: J3.9; also elsewhere on the board
/SENSOR_EXT_IN: J1.21; also elsewhere on the board
/SENSOR_LDO_OUTPUT: J1.22; also elsewhere on the board
/scumsheet/ANTENNA: J4.1; also elsewhere on the board
/scumsheet/AUX_LDO_OUTPUT: C11.2; also elsewhere on the board
/scumsheet/LO_LDO_OUTPUT: C4.1; also elsewhere on the board
/scumsheet/PA_LDO_OUTPUT: C5.1; also elsewhere on the board
/scumsheet/VDDD_DISABLE: R1.1; also elsewhere on the board
GND: B1.1, C1.2, C2.2, C3.2, C4.2, C5.2, C6.2, C7.2, C8.2, C9.2, C10.2, C11.1, C12.1, C13.1, C_1.1_IN1.2, C_1.1_OUT1.1, C_1.8_IN1.2, C_1.8_OUT1.1, GND1.1 (pin), GND2.1 (pin), GND3.1 (pin), GND4.1 (pin), GND5.1 (pin), GND6.1 (pin), J1.1, J1.2, J1.3, J1.11, J2.1, J2.19, J2.20, J3.10, J4.2, J4.3 (2), J4.4 (2), J4.5 (2), R1.2, U2.2 (VSS), U2.4 (PVSS), U3.2 (VSS), U3.4 (PVSS), U9AB1.11 (FSYNC), U9AB1.18 (GND), U9AB1.20 (GND); also elsewhere on the board
unnamed: L1.2, U2.3 (SW)
unnamed: L2.2, U3.3 (SW)
unnamed: C3.1, U9AB1.10 (REGOUT)

Notes on the sheet:
SCuM
Extra grounds
Sulu PCB v2.2
Invensense MPU-9250 and ICM-20948 are pin compatible When using MPU-9250, VDDIO can be 1.71V-3.3V When using ICM-20948, VDDIO can be 1.71V-1.95V Easiest way to use ICM-20948 is to replace 1.5V VBAT LDO with 1.8V and set VDDIO=VBAT
External Connections
Regulators
Battery
IMU

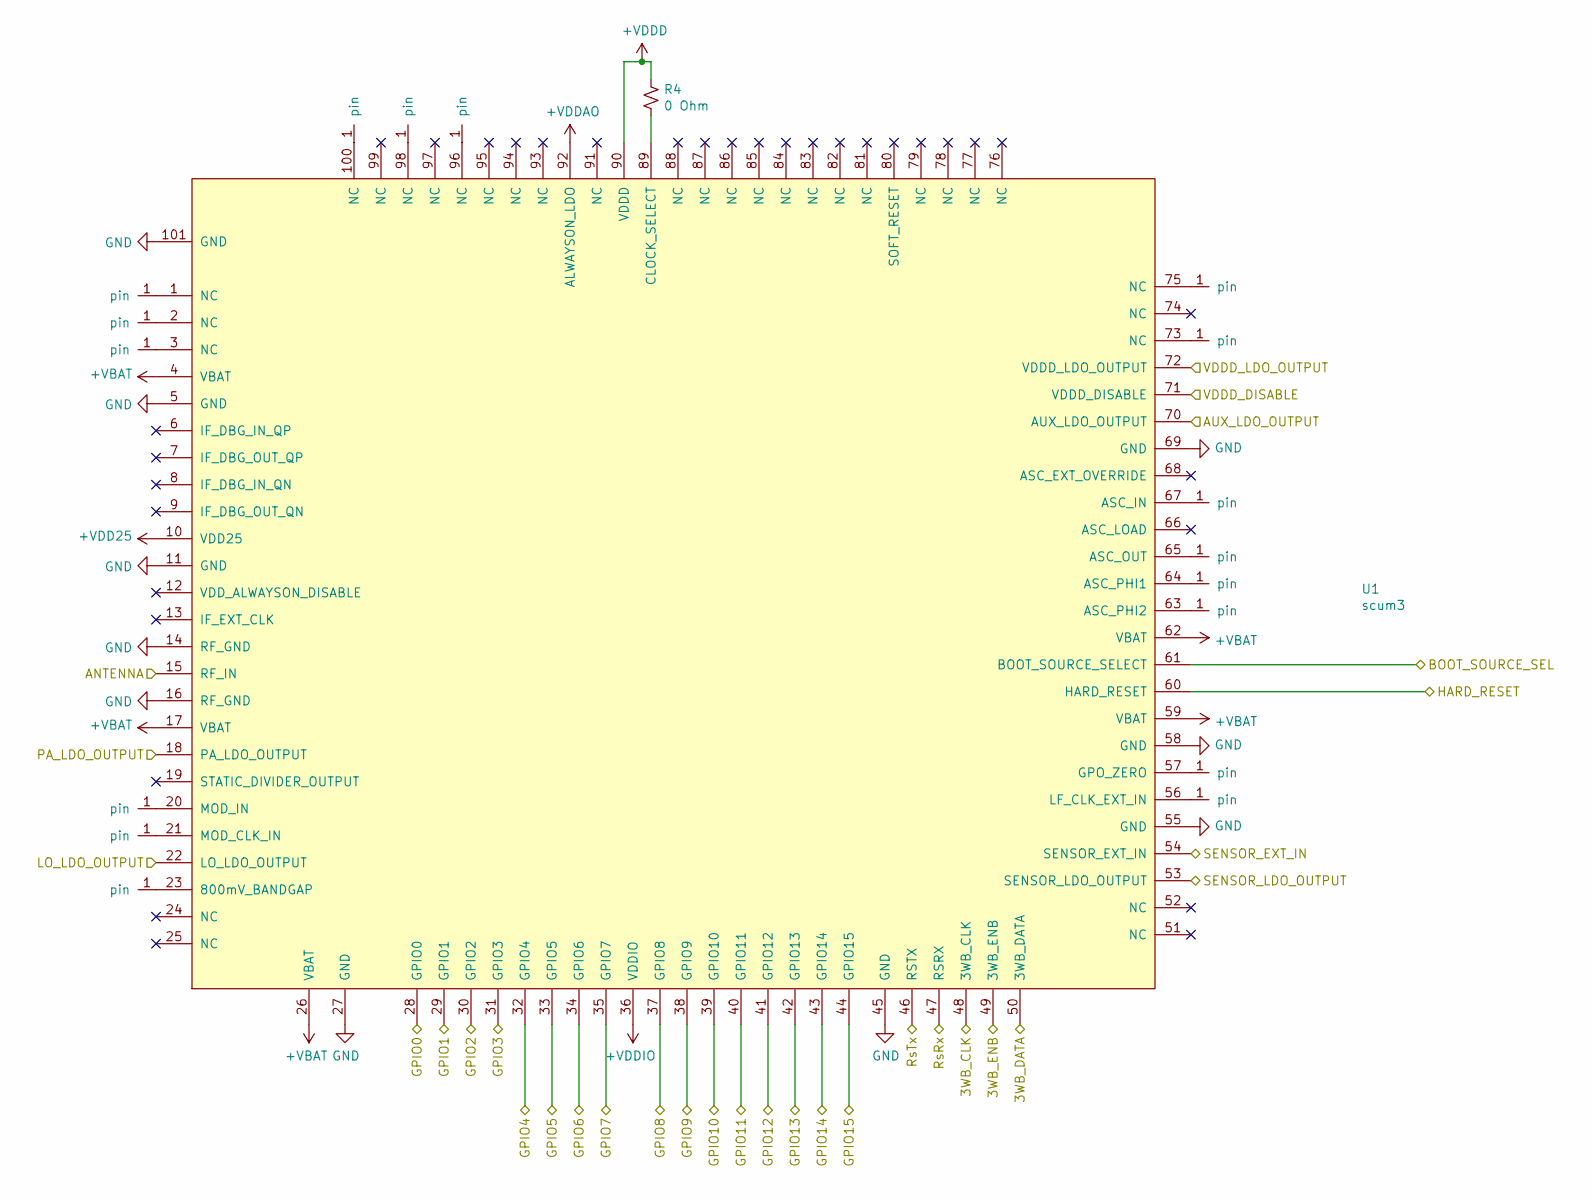
[picture p67: schematic scumsheet.kicad_sch]

Parts:
J5, J6, J7, J8, J9, J10, J11, J12, J13, J14, J15, J16, J17, J18, J19, J20, J21: through_hole
R4: 0 Ohm; R_0402_1005Metric
U1: scum3; QFN-100_EP_12x12_Pitch0.4mm_Margin0.25mm

Connections:
+VBAT: U1.4 (VBAT), U1.17 (VBAT), U1.26 (VBAT), U1.59 (VBAT), U1.62 (VBAT); also elsewhere on the board
+VDD25: U1.10 (VDD25)
+VDDAO: U1.92 (ALWAYSON_LDO); also elsewhere on the board
+VDDD: R4.1, U1.72 (VDDD_LDO_OUTPUT), U1.90 (VDDD); also elsewhere on the board
+VDDIO: U1.36 (VDDIO); also elsewhere on the board
/3WB_CLK: U1.48 (3WB_CLK); also elsewhere on the board
/3WB_DATA: U1.50 (3WB_DATA); also elsewhere on the board
/3WB_ENB: U1.49 (3WB_ENB); also elsewhere on the board
/BOOT_SOURCE_SEL: U1.61 (BOOT_SOURCE_SELECT); also elsewhere on the board
/GPIO0: U1.28 (GPIO0); also elsewhere on the board
/GPIO1: U1.29 (GPIO1); also elsewhere on the board
/GPIO2: U1.30 (GPIO2); also elsewhere on the board
/GPIO3: U1.31 (GPIO3); also elsewhere on the board
/GPIO4: U1.32 (GPIO4); also elsewhere on the board
/GPIO5: U1.33 (GPIO5); also elsewhere on the board
/GPIO6: U1.34 (GPIO6); also elsewhere on the board
/GPIO7: U1.35 (GPIO7); also elsewhere on the board
/GPIO8: U1.37 (GPIO8); also elsewhere on the board
/GPIO9: U1.38 (GPIO9); also elsewhere on the board
/GPIO10: U1.39 (GPIO10); also elsewhere on the board
/GPIO11: U1.40 (GPIO11); also elsewhere on the board
/GPIO12: U1.41 (GPIO12); also elsewhere on the board
/GPIO13: U1.42 (GPIO13); also elsewhere on the board
/GPIO14: U1.43 (GPIO14); also elsewhere on the board
/GPIO15: U1.44 (GPIO15); also elsewhere on the board
/HARD_RESET: U1.60 (HARD_RESET); also elsewhere on the board
/RsRx: U1.47 (RSRX); also elsewhere on the board
/RsTx: U1.46 (RSTX); also elsewhere on the board
/SENSOR_EXT_IN: U1.54 (SENSOR_EXT_IN); also elsewhere on the board
/SENSOR_LDO_OUTPUT: U1.53 (SENSOR_LDO_OUTPUT); also elsewhere on the board
/scumsheet/ANTENNA: U1.15 (RF_IN); also elsewhere on the board
/scumsheet/AUX_LDO_OUTPUT: U1.70 (AUX_LDO_OUTPUT); also elsewhere on the board
/scumsheet/LO_LDO_OUTPUT: U1.22 (LO_LDO_OUTPUT); also elsewhere on the board
/scumsheet/PA_LDO_OUTPUT: U1.18 (PA_LDO_OUTPUT); also elsewhere on the board
/scumsheet/VDDD_DISABLE: U1.71 (VDDD_DISABLE); also elsewhere on the board
GND: U1.5 (GND), U1.11 (GND), U1.14 (RF_GND), U1.16 (RF_GND), U1.27 (GND), U1.45 (GND), U1.55 (GND), U1.58 (GND), U1.69 (GND), U1.101 (GND); also elsewhere on the board
unnamed: J5.1 (pin), U1.73 (NC)
unnamed: J6.1 (pin), U1.1 (NC)
unnamed: J7.1 (pin), U1.2 (NC)
unnamed: J8.1 (pin), U1.3 (NC)
unnamed: J9.1 (pin), U1.63 (ASC_PHI2)
unnamed: J10.1 (pin), U1.64 (ASC_PHI1)
unnamed: J11.1 (pin), U1.20 (MOD_IN)
unnamed: J12.1 (pin), U1.21 (MOD_CLK_IN)
unnamed: J13.1 (pin), U1.23 (800mV_BANDGAP)
unnamed: J14.1 (pin), U1.100 (NC)
unnamed: J15.1 (pin), U1.67 (ASC_IN)
unnamed: J16.1 (pin), U1.65 (ASC_OUT)
unnamed: J17.1 (pin), U1.56 (LF_CLK_EXT_IN)
unnamed: J18.1 (pin), U1.98 (NC)
unnamed: J19.1 (pin), U1.96 (NC)
unnamed: J20.1 (pin), U1.75 (NC)
unnamed: J21.1 (pin), U1.57 (GPO_ZERO)
unnamed: R4.2, U1.89 (CLOCK_SELECT)

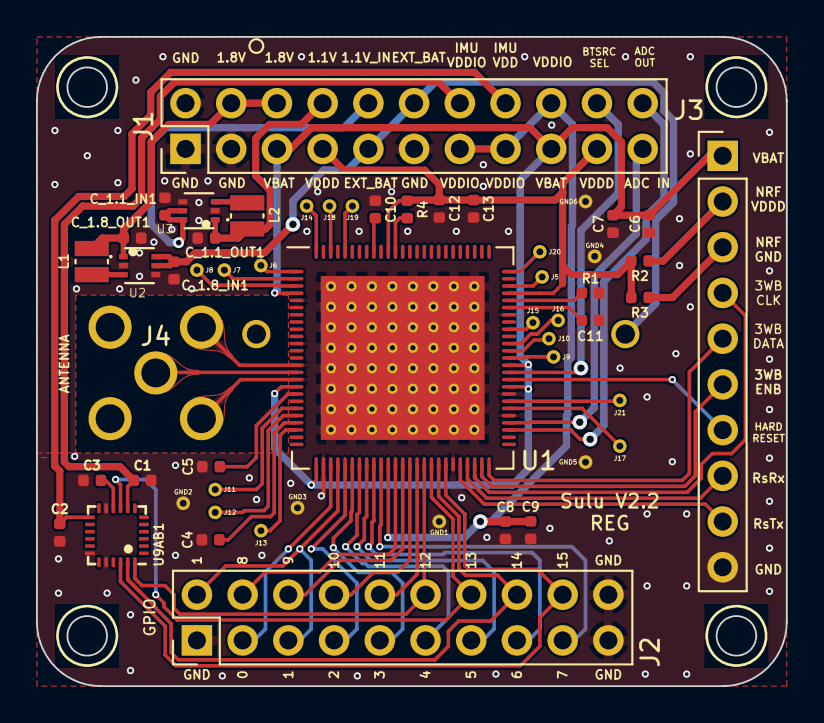
[picture p68: board scum3c-devboard.kicad_pcb from above]

Board: 2 copper layers, 41.7 x 36.1 mm, 55 parts (1 on the bottom side), 64 nets.
