PisterLab/scum-dev-board/sulu-ads1299/sulu_ads1299.kicad_pcb

## KiCad design sulu-ads1299/sulu_ads1299.kicad_pcb (2024-02-10)

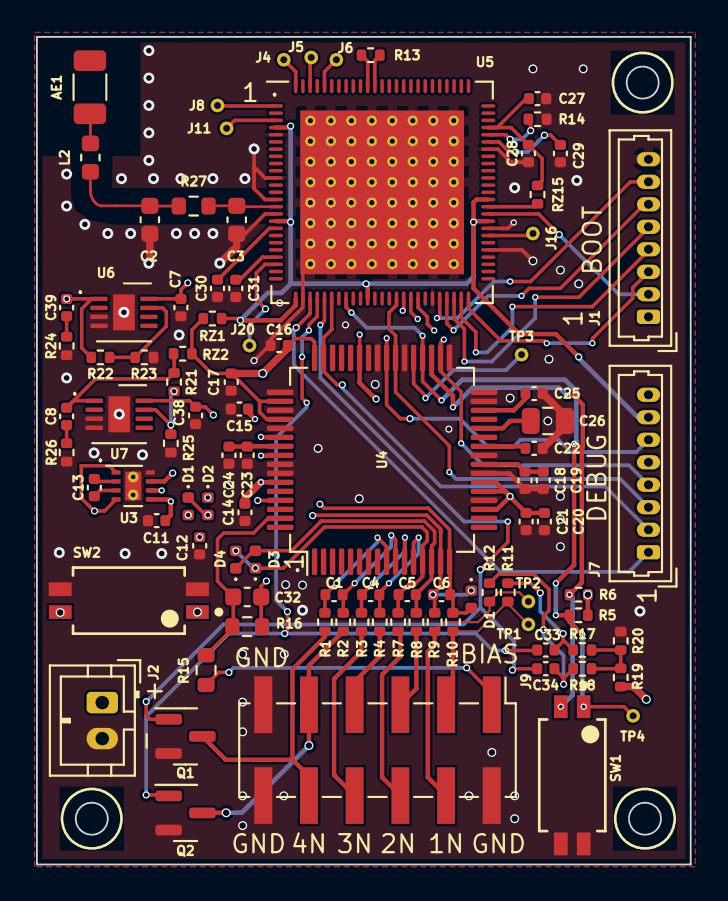
[picture p69: board sulu_ads1299.kicad_pcb from above]

Board: 6 copper layers, 36.3 x 46.0 mm, 95 parts (1 on the bottom side), 75 nets.

Parts:
AE1: RFANT3216120A5T; C_1206_3216Metric
C1, C4, C5, C6, C33, C34: 3.3 uF; C_0402_1005Metric
C2: 0.5 pF; C_0603_1608Metric
C3: NP; C_0603_1608Metric
C7, C13, C14, C17, C20, C22, C23, C25, C38: 1 uF; C_0402_1005Metric
C8, C39: 4.7 uF; C_0402_1005Metric
C11, C12, C19: 10 uF; C_0402_1005Metric
C15, C16, C18, C21, C24: 0.1 uF; C_0402_1005Metric
C26: 100 uF; C_0805_2012Metric
C27, C28, C29, C30, C31: NP; C_0402_1005Metric
C32: 0.01uF; C_0603_1608Metric
D1, D1#2, D2, D3, D4: GDZ5V1LP3-7; D_0402_1005Metric
J1, J7: Conn_01x08; Molex_PicoBlade_53047-0810_1x08_P1.25mm_Vertical
J2: Conn_01x02; JST_PH_B2B-PH-K_1x02_P2.00mm_Vertical
J4, J5, J6, J8, J11, J16, J20: through_hole
J9: Conn_02x06_Odd_Even; PinHeader_2x06_P2.54mm_Vertical_SMD
L2: 6.7 nH; L_0603_1608Metric
Q1, Q2: BSS138; SOT-23
R1, R2, R3, R4, R7, R8, R9, R10: 200; R_0402_1005Metric
R5, R6: 10K; R_0402_1005Metric
R11, R12: 0; R_0402_1005Metric
R13: 0 Ohm; R_0402_1005Metric
R14: NP; R_0402_1005Metric
R15: 4.99K; R_0603_1608Metric
R16: 392K; R_0603_1608Metric
R17, R18, R19, R20, R23, R25: 100K; R_0402_1005Metric
R21, R22: 46K; R_0402_1005Metric
R24, R26: 1; R_0402_1005Metric
R27: 0; R_0603_1608Metric
RZ1, RZ15: 0 Ohm; R_0402_1005Metric
RZ2: NP; R_0402_1005Metric
SW1, SW2: SW_DIP_x02; CK_Components-TDA02H0SB1-MFG
TP1, TP2, TP3, TP4: TestPoint; through_hole
U3: LM2775DSG; WSON-8-1EP_2x2mm_P0.5mm_EP0.9x1.6mm_ThermalVias
U4: ADS1299_TQFP-64; TQFP-64_10x10mm_P0.5mm
U5: scum3; QFN-100_EP_12x12_Pitch0.4mm_Margin0.25mm
U6, U7: LP2951-5.0_WSON; WSON-8-1EP_3x3mm_P0.5mm_EP1.2x2mm

Connections:
+5V_REG: C12.1, C14.1, C15.1, C20.1, C21.1, R19.1, U3.6 (VOUT), U4.19 (AVDD), U4.21 (AVDD), U4.22 (AVDD), U4.54 (AVDD1), U4.56 (AVDD), U4.59 (AVDD)
+EXT_BAT: J1.1, J2.1, SW2.1
/3WB_CLK: J1.5, U5.48 (3WB_CLK)
/3WB_DATA: J1.3, U5.50 (3WB_DATA)
/3WB_ENB: J1.4, U5.49 (3WB_ENB)
/+1.8V_ADS: C16.1, C17.1, J7.8, R5.1, R6.1, RZ1.1, RZ2.2, U4.48 (DVDD), U4.50 (DVDD), U4.52 (CLKSEL)
/+1.8V_BACKUP: C8.2, R21.2, RZ2.1, U7.1 (OUT)
/+1.8V_SCUM: C39.2, J7.7, R22.2, RZ1.2, U5.4 (VBAT), U5.17 (VBAT), U5.26 (VBAT), U5.36 (VDDIO), U5.59 (VBAT), U5.62 (VBAT), U6.1 (OUT)
/ADS1299/BIASINV: C32.1, R16.1, U4.61 (BIASINV)
/ADS1299/BIASOUT: C32.2, R15.2, R16.2, U4.63 (BIASOUT)
/ADS1299/VCAP1: C26.1, U4.28 (VCAP1)
/ADS1299/VCAP2: C25.1, U4.30 (VCAP2)
/ADS1299/VCAP3: C23.1, C24.1, U4.55 (VCAP3)
/ADS1299/VCAP4: C22.1, U4.26 (VCAP4)
/ADS1299/VREFP: C18.1, C19.1, U4.24 (VREFP)
/ADS_BIAS_ELEC: J9.1, R15.1
/ADS_IN1N: C6.1, D1.1 (K), D1#2.1 (K), D2.2 (A), R9.2, U4.15 (IN1N)
/ADS_IN1N_CONN: J9.4, R9.1, R12.2, TP2.1
/ADS_IN1P: C6.2, D1.2 (A), D1#2.2 (A), D2.1 (K), R10.2, U4.16 (IN1P)
/ADS_IN1P_CONN: J9.3, R10.1, R11.2, TP1.1
/ADS_IN2N: C5.1, D3.1 (K), D4.2 (A), R7.2, U4.13 (IN2N)
/ADS_IN2N_CONN: J9.6, R7.1
/ADS_IN2P: C5.2, D3.2 (A), D4.1 (K), R8.2, U4.14 (IN2P)
/ADS_IN2P_CONN: J9.5, R8.1
/ADS_IN3N: C4.1, R3.2, U4.11 (IN3N)
/ADS_IN3N_CONN: J9.8, R3.1
/ADS_IN3P: C4.2, R4.2, U4.12 (IN3P)
/ADS_IN3P_CONN: J9.7, R4.1
/ADS_IN4N: C1.1, R1.2, U4.9 (IN4N)
/ADS_IN4N_CONN: J9.10, Q1.3 (D), R1.1
/ADS_IN4P: C1.2, R2.2, U4.10 (IN4P)
/ADS_IN4P_CONN: J9.9, Q2.3 (D), R2.1
/EXT_BAT_SW: C7.1, C11.1, C38.1, SW2.4, U3.1 (PFM), U3.4 (OUTDIS), U3.5 (EN), U3.7 (VIN), U6.8 (IN), U7.8 (IN)
/HARD_RESET: J1.2, U5.60 (HARD_RESET)
/RsRx: J1.6, U5.47 (RSRX)
/RsTx: J1.7, U5.46 (RSTX)
/SCUM_GPIO0: J7.1, U5.28 (GPIO0)
/SCUM_GPIO1: C33.2, Q2.1 (G), U5.29 (GPIO1)
/SCUM_GPIO2: C34.2, Q1.1 (G), U5.30 (GPIO2)
/SCUM_GPIO3: J7.2, U4.47 (~DRDY), U5.31 (GPIO3)
/SCUM_GPIO5: R5.2, SW1.1, TP4.1, U4.36 (~RESET), U5.33 (GPIO5)
/SCUM_GPIO11: J7.3, U4.39 (~CS), U5.40 (GPIO11)
/SCUM_GPIO12: J7.4, U4.34 (DIN), U5.41 (GPIO12)
/SCUM_GPIO13: J7.5, U4.43 (DOUT), U5.42 (GPIO13)
/SCUM_GPIO14: J7.6, U4.40 (SCLK), U5.43 (GPIO14)
/SCuM-3C/+1.1V_REG: C27.1, C28.1, RZ15.2, U5.72 (VDDD_LDO_OUTPUT)
/SCuM-3C/ANTENNA: C3.2, R27.2, U5.15 (RF_IN)
/SELF_TEST_BIAS: R17.2, R18.1, R19.2, R20.1
/SELF_TEST_N: C34.1, R12.1, R18.2
/SELF_TEST_P: C33.1, R11.1, R17.1
/~ADS_PWDN: R6.2, SW1.2, U4.35 (~PWDN)
GND: C2.1, C3.1, C7.2, C11.2, C12.2, C14.2, C15.2, C16.2, C17.2, C18.2, C19.2, C20.2, C21.2, C22.2, C23.2, C24.2, C25.2, C26.2, C27.2, C28.2, C29.2, C30.2, C31.2, C38.2, J1.8, J2.2, J9.2, J9.11, J9.12, Q1.2 (S), Q2.2 (S), R14.2, R20.2, R23.1, R24.1, R25.1, R26.1, SW1.3, SW1.4, SW2.2, SW2.3, U3.8 (GND), U3.9 (GND), U4.20 (AVSS), U4.23 (AVSS), U4.25 (VREFN), U4.31 (RESV1), U4.32 (AVSS), U4.33 (DGND), U4.38 (START), U4.41 (DAISY_IN), U4.49 (DGND), U4.51 (DGND), U4.53 (AVSS1), U4.57 (AVSS), U4.58 (AVSS), U5.5 (GND), U5.11 (GND), U5.14 (RF_GND), U5.16 (RF_GND), U5.27 (GND), U5.45 (GND), U5.55 (GND), U5.58 (GND), U5.69 (GND), U5.101 (GND), U6.3 (SHUTDOWN), U6.4 (GND), U6.9 (EP), U7.3 (SHUTDOWN), U7.4 (GND), U7.9 (EP)
unnamed: AE1.1 (FEED), L2.2
unnamed: C2.2, L2.1, R27.1
unnamed: C8.1, R26.2
unnamed: C39.1, R24.2
unnamed: J4.1 (pin), U5.100 (NC)
unnamed: J5.1 (pin), U5.98 (NC)
unnamed: J6.1 (pin), U5.96 (NC)
unnamed: J8.1 (pin), U5.1 (NC)
unnamed: J11.1 (pin), U5.3 (NC)
unnamed: J16.1 (pin), U5.57 (GPO_ZERO)
unnamed: J20.1 (pin), U5.23 (800mV_BANDGAP)
unnamed: C13.1, U3.3 (C1+)
unnamed: C13.2, U3.2 (C1-)
unnamed: TP3.1, U4.37 (CLK)
unnamed: C29.1, U5.70 (AUX_LDO_OUTPUT)
unnamed: RZ15.1, U5.61 (BOOT_SOURCE_SELECT)
unnamed: R13.2, U5.89 (CLOCK_SELECT)
unnamed: C31.1, U5.22 (LO_LDO_OUTPUT)
unnamed: C30.1, U5.18 (PA_LDO_OUTPUT)
unnamed: R13.1, U5.90 (VDDD)
unnamed: R14.1, U5.71 (VDDD_DISABLE)
unnamed: R22.1, R23.2, U6.7 (FEEDBACK)
unnamed: R21.1, R25.2, U7.7 (FEEDBACK)
