PisterLab/scum-dev-board/scum-programmer/connector_board.kicad_pcb

## KiCad design scum-programmer/connector_board.kicad_pcb (2024-02-10)

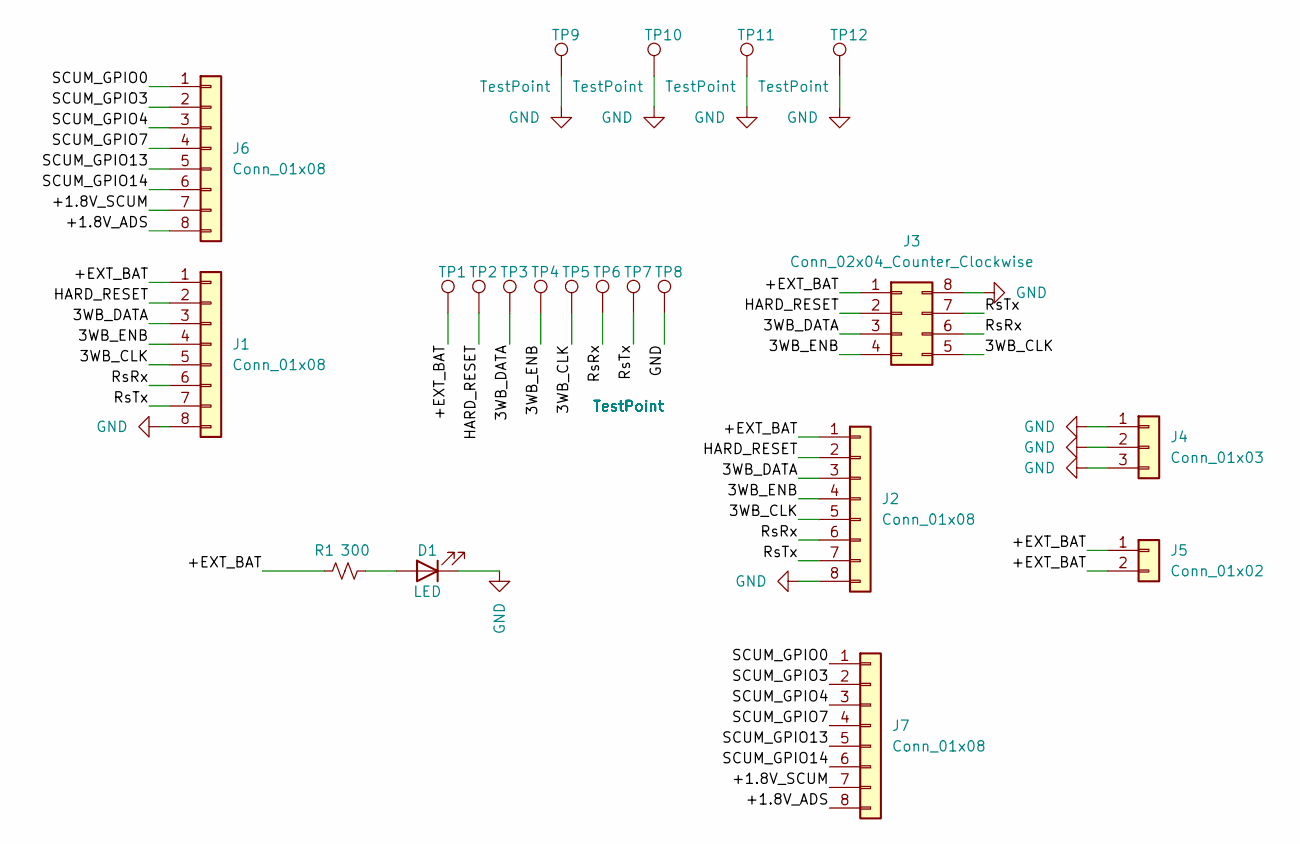
[picture p70: schematic connector_board.kicad_sch]

Parts:
D1: LED; LED_0805_2012Metric
J1, J6: Conn_01x08; Molex_PicoBlade_53047-0810_1x08_P1.25mm_Vertical
J2, J7: Conn_01x08; PinHeader_1x08_P2.54mm_Vertical
J3: Conn_02x04_Counter_Clockwise; PinHeader_2x04_P2.54mm_Vertical
J4: Conn_01x03; PinHeader_1x03_P2.54mm_Vertical
J5: Conn_01x02; PinHeader_1x02_P2.54mm_Vertical
R1: 300; R_0402_1005Metric
TP1, TP2, TP3, TP4, TP5, TP6, TP7, TP8: TestPoint; TestPoint_THTPad_1.0x1.0mm_Drill0.5mm
TP9, TP10, TP11, TP12: TestPoint; TestPoint_Keystone_5010-5014_Multipurpose

Connections:
/3WB_CLK: J1.5, J2.5, J3.5, TP5.1
/3WB_DATA: J1.3, J2.3, J3.3, TP3.1
/3WB_ENB: J1.4, J2.4, J3.4, TP4.1
/+1.8V_ADS: J6.8, J7.8
/+1.8V_SCUM: J6.7, J7.7
/+EXT_BAT: J1.1, J2.1, J3.1, J5.1, J5.2, R1.1, TP1.1
/HARD_RESET: J1.2, J2.2, J3.2, TP2.1
/RsRx: J1.6, J2.6, J3.6, TP6.1
/RsTx: J1.7, J2.7, J3.7, TP7.1
/SCUM_GPIO0: J6.1, J7.1
/SCUM_GPIO3: J6.2, J7.2
/SCUM_GPIO4: J6.3, J7.3
/SCUM_GPIO7: J6.4, J7.4
/SCUM_GPIO13: J6.5, J7.5
/SCUM_GPIO14: J6.6, J7.6
GND: D1.1 (K), J1.8, J2.8, J3.8, J4.1, J4.2, J4.3, TP8.1, TP9.1, TP10.1, TP11.1, TP12.1
unnamed: D1.2 (A), R1.2

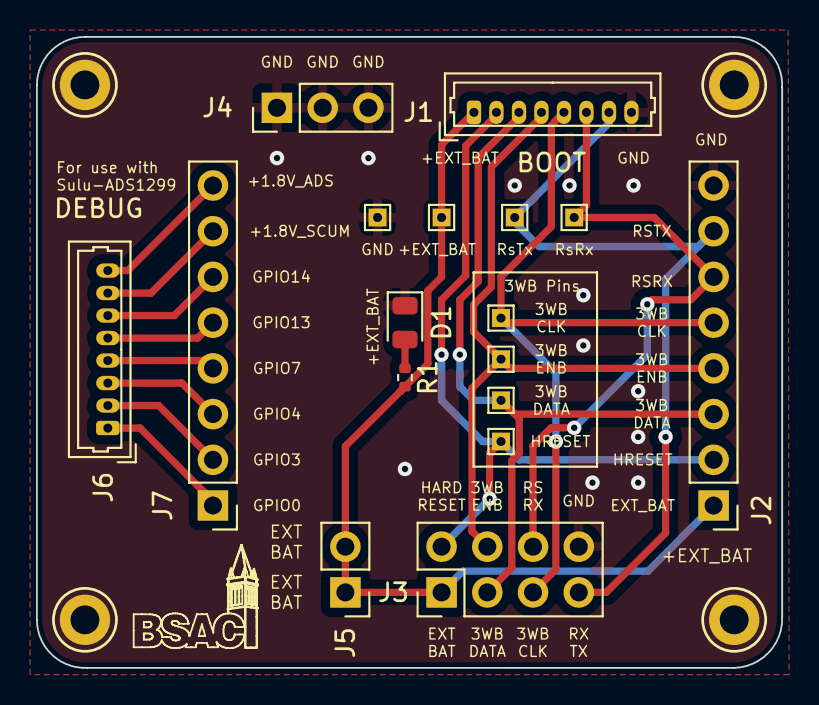
[picture p71: board connector_board.kicad_pcb from above]

Board: 2 copper layers, 41.4 x 35.1 mm, 21 parts (0 on the bottom side), 17 nets.
