PisterLab/scum-dev-board/spock/Spock.kicad_pcb

## KiCad design spock/Spock.kicad_pcb (2021-06-09)

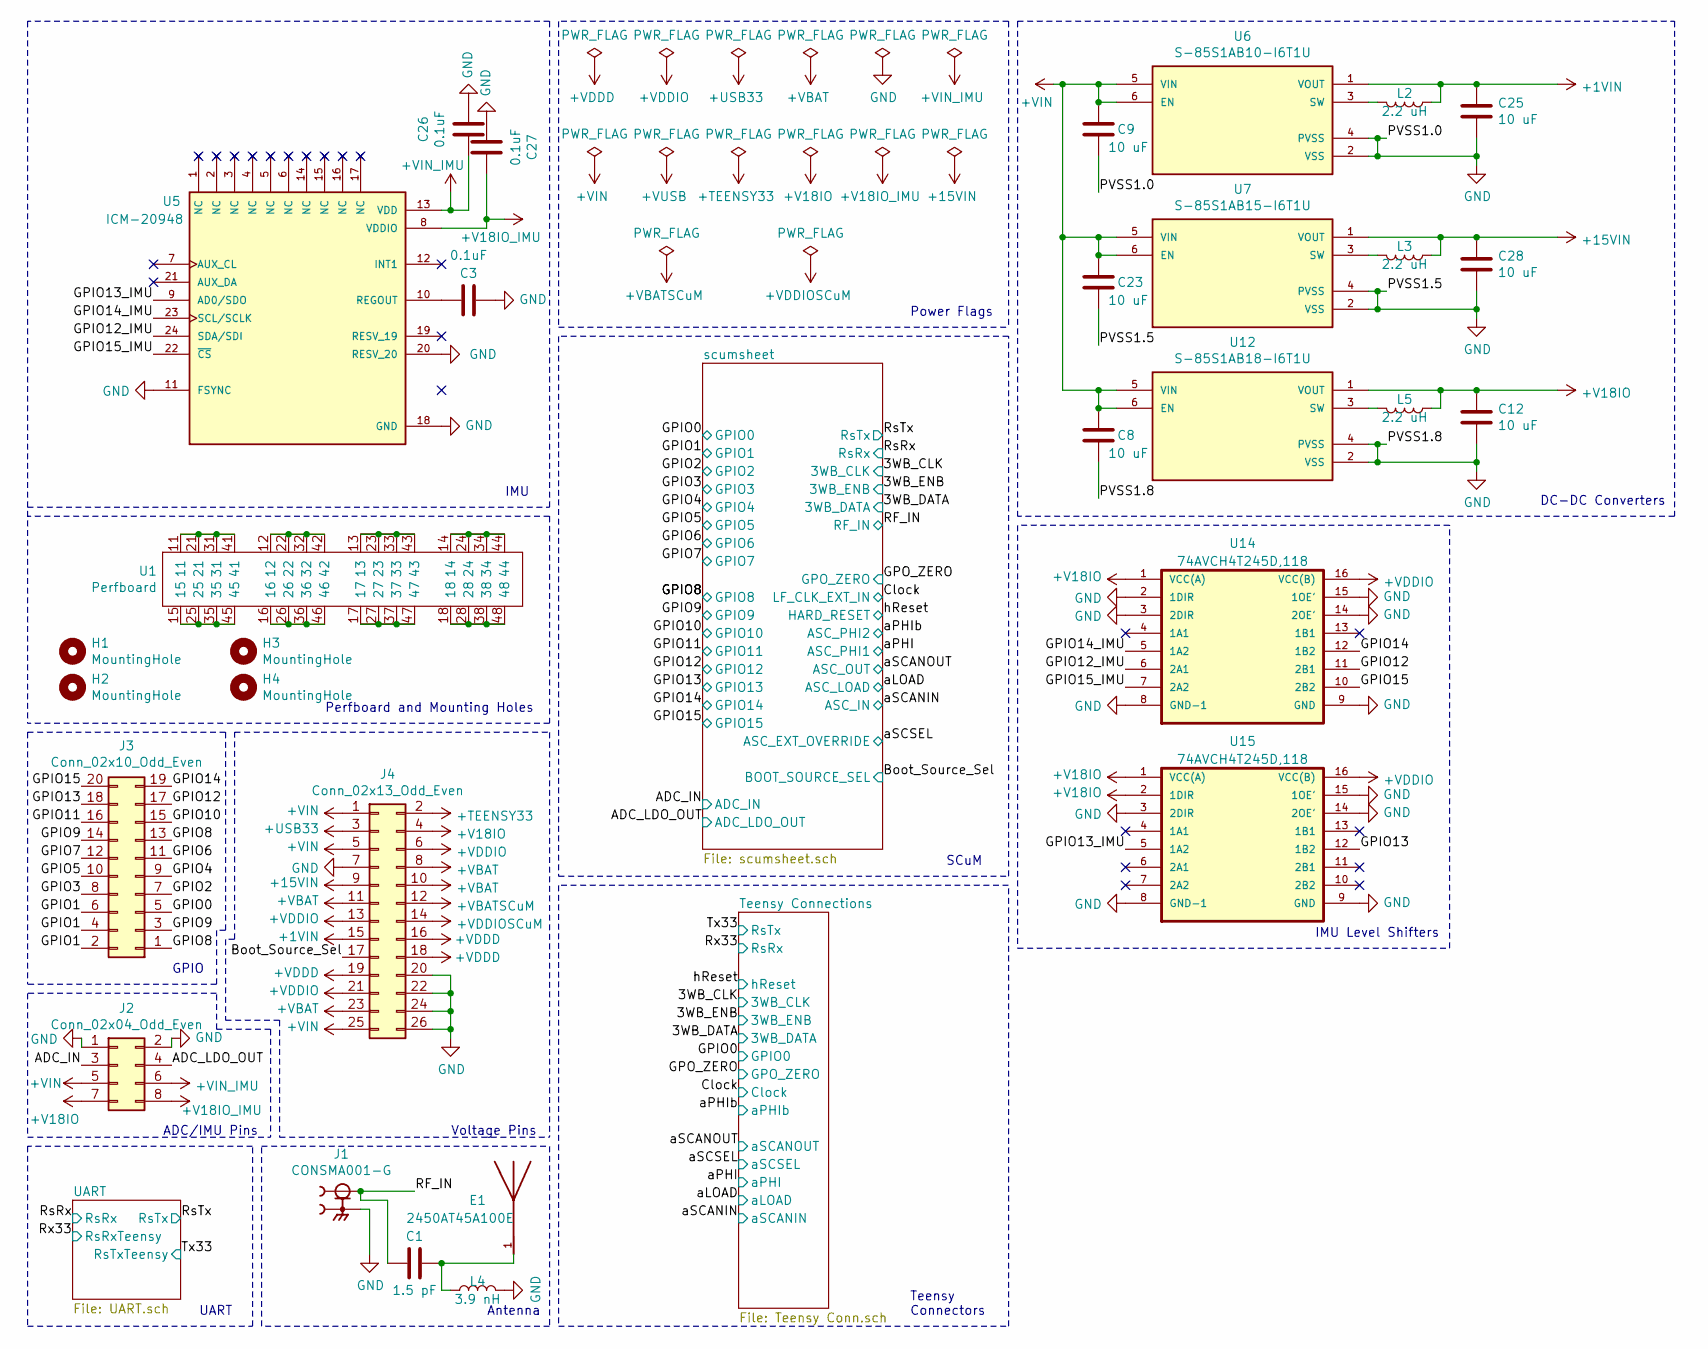
[picture p72: schematic Spock.sch, SCuM PCB1]

Parts:
C1: 1.5 pF; C_0402_1005Metric
C3, C26, C27: 0.1uF; C_0402_1005Metric
C8, C9, C12, C23, C25, C28: 10 uF; C_0402_1005Metric
E1: 2450AT45A100E; ANT_2450AT45A100E; PARTREV 3.1
H1, H2, H3, H4: MountingHole; MountingHole_2.7mm_M2.5
J1: CONSMA001-G; LINX_CONSMA001-G; PARTREV D
J2: Conn_02x04_Odd_Even; PinHeader_2x04_P2.54mm_Vertical
J3: Conn_02x10_Odd_Even; PinHeader_2x10_P2.54mm_Vertical
J4: Conn_02x13_Odd_Even; PinHeader_2x13_P2.54mm_Vertical
L2, L3, L5: 2.2 uH; L_0402_1005Metric
L4: 3.9 nH; L_0402_1005Metric
U1: Perfboard
U5: ICM-20948; QFN40P300X300X105-24N; PARTREV 1.3
U6: S-85S1AB10-I6T1U; SOFL50P180X50-6N; PARTREV 1.4_00
U7: S-85S1AB15-I6T1U; SOFL50P180X50-6N; PARTREV 1.4_00
U12: S-85S1AB18-I6T1U; SOFL50P180X50-6N; PARTREV 1.4_00
U14, U15: 74AVCH4T245D,118; SOIC127P600X175-16N

Connections:
+1VIN: C25.1, J4.15, L2.1, U6.1 (VOUT)
+15VIN: C28.1, J4.9, L3.1, U7.1 (VOUT)
+TEENSY33: J4.2; also elsewhere on the board
+USB33: J4.3; also elsewhere on the board
+V18IO: C12.1, J2.7, J4.4, L5.1, U12.1 (VOUT), U14.1 (VCC(A)), U15.1 (VCC(A)), U15.2 (1DIR)
+V18IO_IMU: C27.1, J2.8, U5.8 (VDDIO)
+VBAT: J4.8, J4.10, J4.11, J4.23; also elsewhere on the board
+VBATSCuM: J4.12; also elsewhere on the board
+VDDD: J4.16, J4.18, J4.19; also elsewhere on the board
+VDDIO: J4.6, J4.13, J4.21, U14.16 (VCC(B)), U15.16 (VCC(B)); also elsewhere on the board
+VDDIOSCuM: J4.14; also elsewhere on the board
+VIN: C8.1, C9.1, C23.1, J2.5, J4.1, J4.5, J4.25, U6.5 (VIN), U6.6 (EN), U7.5 (VIN), U7.6 (EN), U12.5 (VIN), U12.6 (EN); also elsewhere on the board
+VIN_IMU: C26.1, J2.6, U5.13 (VDD)
/ADC_IN: J2.3; also elsewhere on the board
/ADC_LDO_OUT: J2.4; also elsewhere on the board
/Boot_Source_Sel: J4.17; also elsewhere on the board
/GPIO0: J3.5; also elsewhere on the board
/GPIO1: J3.2, J3.4, J3.6; also elsewhere on the board
/GPIO2: J3.7; also elsewhere on the board
/GPIO3: J3.8; also elsewhere on the board
/GPIO4: J3.9; also elsewhere on the board
/GPIO5: J3.10; also elsewhere on the board
/GPIO6: J3.11; also elsewhere on the board
/GPIO7: J3.12; also elsewhere on the board
/GPIO8: J3.1, J3.13; also elsewhere on the board
/GPIO9: J3.3, J3.14; also elsewhere on the board
/GPIO10: J3.15; also elsewhere on the board
/GPIO11: J3.16; also elsewhere on the board
/GPIO12: J3.17, U14.11 (2B1); also elsewhere on the board
/GPIO12_IMU: U5.24 (SDA/SDI), U14.6 (2A1)
/GPIO13: J3.18, U15.12 (1B2); also elsewhere on the board
/GPIO13_IMU: U5.9 (AD0/SDO), U15.5 (1A2)
/GPIO14: J3.19, U14.12 (1B2); also elsewhere on the board
/GPIO14_IMU: U5.23 (SCL/SCLK), U14.5 (1A2)
/GPIO15: J3.20, U14.10 (2B2); also elsewhere on the board
/GPIO15_IMU: U5.22 (~CS), U14.7 (2A2)
/RF_IN: C1.2, J1.1; also elsewhere on the board
GND: C3.1, C8.2, C9.2, C12.2, C23.2, C25.2, C26.2, C27.2, C28.2, J1.S1, J1.S2, J1.S3, J1.S4, J2.1, J2.2, J4.7, J4.20, J4.22, J4.24, J4.26, L4.2, U5.11 (FSYNC), U5.18 (GND), U5.20 (RESV_20), U6.2 (VSS), U6.4 (PVSS), U7.2 (VSS), U7.4 (PVSS), U12.2 (VSS), U12.4 (PVSS), U14.2 (1DIR), U14.3 (2DIR), U14.8 (GND-1), U14.9 (GND), U14.14 (2OE'), U14.15 (1OE'), U15.3 (2DIR), U15.8 (GND-1), U15.9 (GND), U15.14 (2OE'), U15.15 (1OE'); also elsewhere on the board
unnamed: C1.1, E1.1, L4.1
unnamed: C3.2, U5.10 (REGOUT)
unnamed: L2.2, U6.3 (SW)
unnamed: L3.2, U7.3 (SW)
unnamed: L5.2, U12.3 (SW)
unnamed: U1.11, U1.21, U1.31, U1.41
unnamed: U1.12, U1.22, U1.32, U1.42
unnamed: U1.13, U1.23, U1.33, U1.43
unnamed: U1.14, U1.24, U1.34, U1.44
unnamed: U1.15, U1.25, U1.35, U1.45
unnamed: U1.16, U1.26, U1.36, U1.46
unnamed: U1.17, U1.27, U1.37, U1.47
unnamed: U1.18, U1.28, U1.38, U1.48

Notes on the sheet:
IMU
Perfboard and Mounting Holes
Power Flags
UART
SCuM
Antenna
Teensy Connectors
DC-DC Converters
GPIO
Voltage Pins
ADC/IMU Pins
IMU Level Shifters

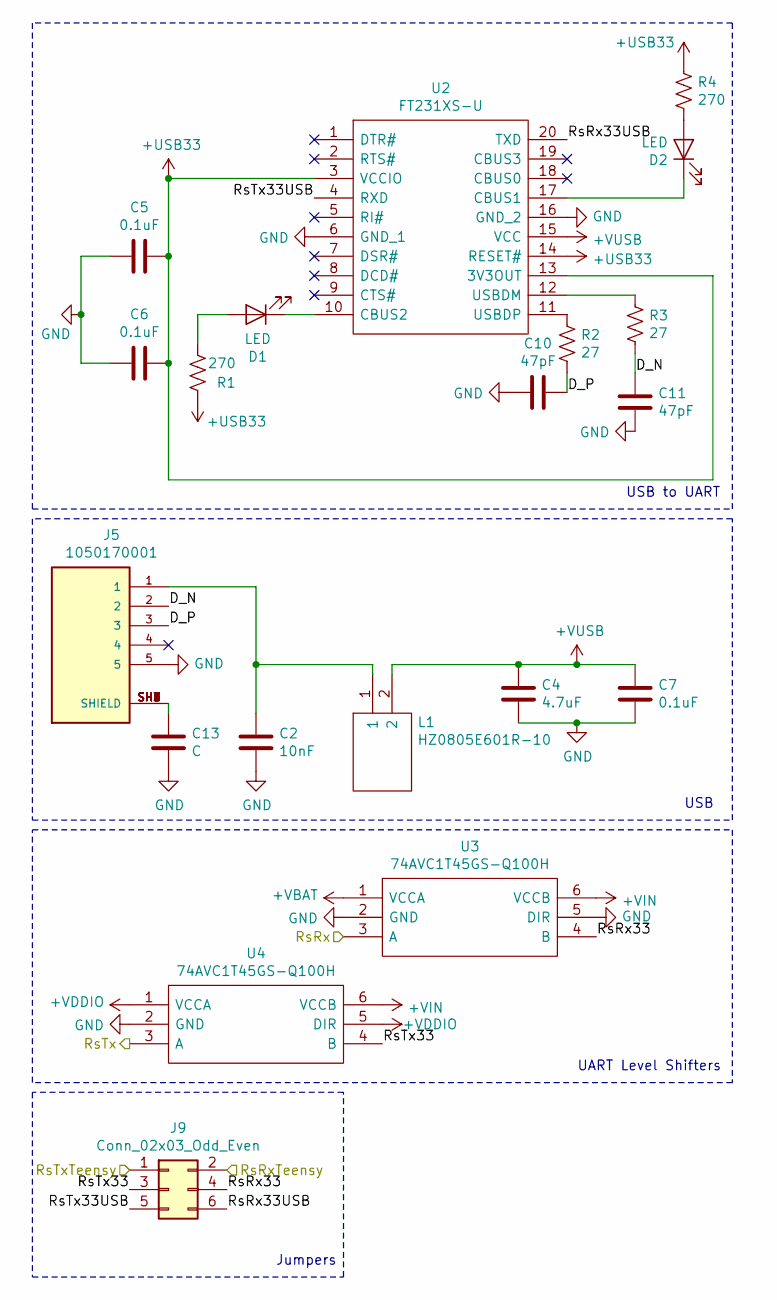
[picture p73: schematic UART.sch]

Parts:
C2: 10nF; C_0402_1005Metric
C4: 4.7uF; C_0402_1005Metric
C5, C6, C7: 0.1uF; C_0402_1005Metric
C10, C11: 47pF; C_0402_1005Metric
C13: C; C_0402_1005Metric
D1, D2: LED; LED_0402_1005Metric
J5: 1050170001; MOLEX_1050170001; PARTREV F
J9: Conn_02x03_Odd_Even; PinHeader_2x03_P2.54mm_Vertical
L1: HZ0805E601R-10; L_0805_2012Metric; Manufacturer_Part_Number HZ0805E601R-10
R1, R4: 270; R_0402_1005Metric
R2, R3: 27; R_0402_1005Metric
U2: FT231XS-U; SSOP-20_3.9x8.7mm_P0.635mm; Manufacturer_Part_Number FT231XS-U; Mouser Part Number 895-FT231XS-U
U3, U4: 74AVC1T45GS-Q100H; 74LVC1G3157GS132; Manufacturer_Part_Number 74AVC1T45GS,132; Mouser Part Number 771-74AVC1T45GS132

Connections:
+USB33: C5.1, C6.1, R1.1, R4.1, U2.3 (VCCIO), U2.13 (3V3OUT), U2.14 (RESET#); also elsewhere on the board
+VBAT: U3.1 (VCCA); also elsewhere on the board
+VDDIO: U4.1 (VCCA), U4.5 (DIR); also elsewhere on the board
+VIN: U3.6 (VCCB), U4.6 (VCCB); also elsewhere on the board
+VUSB: C4.1, C7.1, L1.2, U2.15 (VCC)
/RsRx: U3.3 (A); also elsewhere on the board
/RsTx: U4.3 (A); also elsewhere on the board
/Rx33: J9.2; also elsewhere on the board
/Tx33: J9.1; also elsewhere on the board
/UART/D_N: C11.2, J5.2, R3.2
/UART/D_P: C10.1, J5.3, R2.1
/UART/RsRx33: J9.4, U3.4 (B)
/UART/RsRx33USB: J9.6, U2.20 (TXD)
/UART/RsTx33: J9.3, U4.4 (B)
/UART/RsTx33USB: J9.5, U2.4 (RXD)
GND: C2.2, C4.2, C5.2, C6.2, C7.2, C10.2, C11.1, C13.2, J5.5, U2.6 (GND_1), U2.16 (GND_2), U3.2 (GND), U3.5 (DIR), U4.2 (GND); also elsewhere on the board
unnamed: C2.1, J5.1, L1.1
unnamed: C13.1, J5.SH1 (SHIELD), J5.SH2 (SHIELD), J5.SH3 (SHIELD), J5.SH4 (SHIELD), J5.SH5 (SHIELD), J5.SH6 (SHIELD), J5.SH7 (SHIELD), J5.SH8 (SHIELD)
unnamed: D1.1 (K), U2.10 (CBUS2)
unnamed: D1.2 (A), R1.2
unnamed: D2.1 (K), U2.17 (CBUS1)
unnamed: D2.2 (A), R4.2
unnamed: R2.2, U2.11 (USBDP)
unnamed: R3.1, U2.12 (USBDM)

Notes on the sheet:
USB to UART
USB
UART Level Shifters
Jumpers

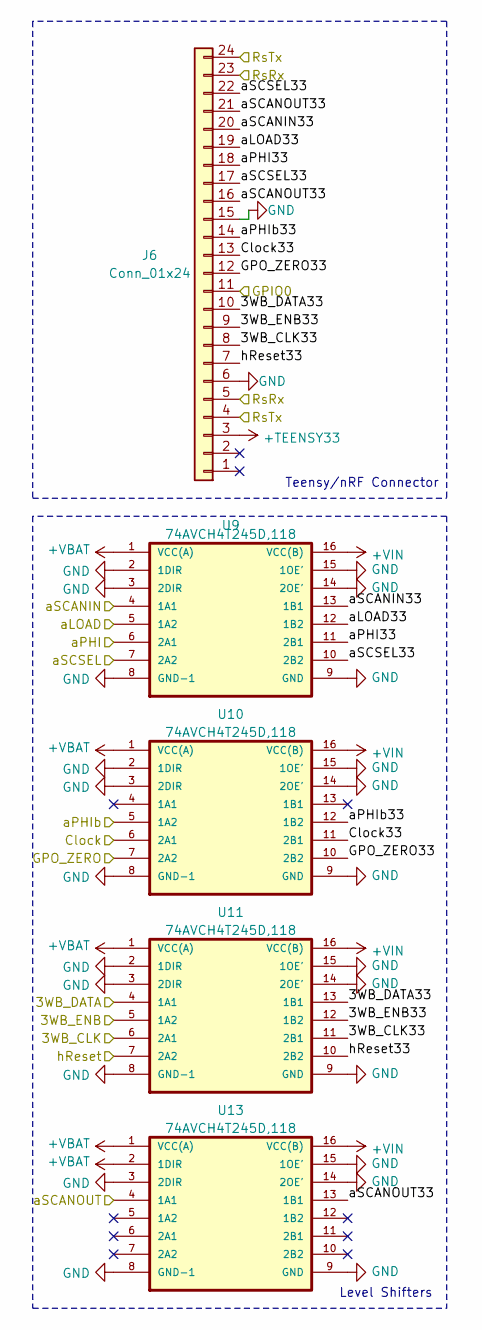
[picture p74: schematic Teensy Conn.sch]

Parts:
J6: Conn_01x24; PinSocket_1x24_P2.54mm_Vertical
U9, U10, U11, U13: 74AVCH4T245D,118; SOIC127P600X175-16N

Connections:
+TEENSY33: J6.3; also elsewhere on the board
+VBAT: U9.1 (VCC(A)), U10.1 (VCC(A)), U11.1 (VCC(A)), U13.1 (VCC(A)), U13.2 (1DIR); also elsewhere on the board
+VIN: U9.16 (VCC(B)), U10.16 (VCC(B)), U11.16 (VCC(B)), U13.16 (VCC(B)); also elsewhere on the board
/3WB_CLK: U11.6 (2A1); also elsewhere on the board
/3WB_DATA: U11.4 (1A1); also elsewhere on the board
/3WB_ENB: U11.5 (1A2); also elsewhere on the board
/Clock: U10.6 (2A1); also elsewhere on the board
/GPIO0: J6.11; also elsewhere on the board
/GPO_ZERO: U10.7 (2A2); also elsewhere on the board
/Rx33: J6.5, J6.23; also elsewhere on the board
/Teensy Connections/3WB_CLK33: J6.8, U11.11 (2B1)
/Teensy Connections/3WB_DATA33: J6.10, U11.13 (1B1)
/Teensy Connections/3WB_ENB33: J6.9, U11.12 (1B2)
/Teensy Connections/Clock33: J6.13, U10.11 (2B1)
/Teensy Connections/GPO_ZERO33: J6.12, U10.10 (2B2)
/Teensy Connections/aLOAD33: J6.19, U9.12 (1B2)
/Teensy Connections/aPHI33: J6.18, U9.11 (2B1)
/Teensy Connections/aPHIb33: J6.14, U10.12 (1B2)
/Teensy Connections/aSCANIN33: J6.20, U9.13 (1B1)
/Teensy Connections/aSCANOUT33: J6.16, J6.21, U13.13 (1B1)
/Teensy Connections/aSCSEL33: J6.17, J6.22, U9.10 (2B2)
/Teensy Connections/hReset33: J6.7, U11.10 (2B2)
/Tx33: J6.4, J6.24; also elsewhere on the board
/aLOAD: U9.5 (1A2); also elsewhere on the board
/aPHI: U9.6 (2A1); also elsewhere on the board
/aPHIb: U10.5 (1A2); also elsewhere on the board
/aSCANIN: U9.4 (1A1); also elsewhere on the board
/aSCANOUT: U13.4 (1A1); also elsewhere on the board
/aSCSEL: U9.7 (2A2); also elsewhere on the board
/hReset: U11.7 (2A2); also elsewhere on the board
GND: J6.6, J6.15, U9.2 (1DIR), U9.3 (2DIR), U9.8 (GND-1), U9.9 (GND), U9.14 (2OE'), U9.15 (1OE'), U10.2 (1DIR), U10.3 (2DIR), U10.8 (GND-1), U10.9 (GND), U10.14 (2OE'), U10.15 (1OE'), U11.2 (1DIR), U11.3 (2DIR), U11.8 (GND-1), U11.9 (GND), U11.14 (2OE'), U11.15 (1OE'), U13.3 (2DIR), U13.8 (GND-1), U13.9 (GND), U13.14 (2OE'), U13.15 (1OE'); also elsewhere on the board

Notes on the sheet:
Teensy/nRF Connector
Level Shifters

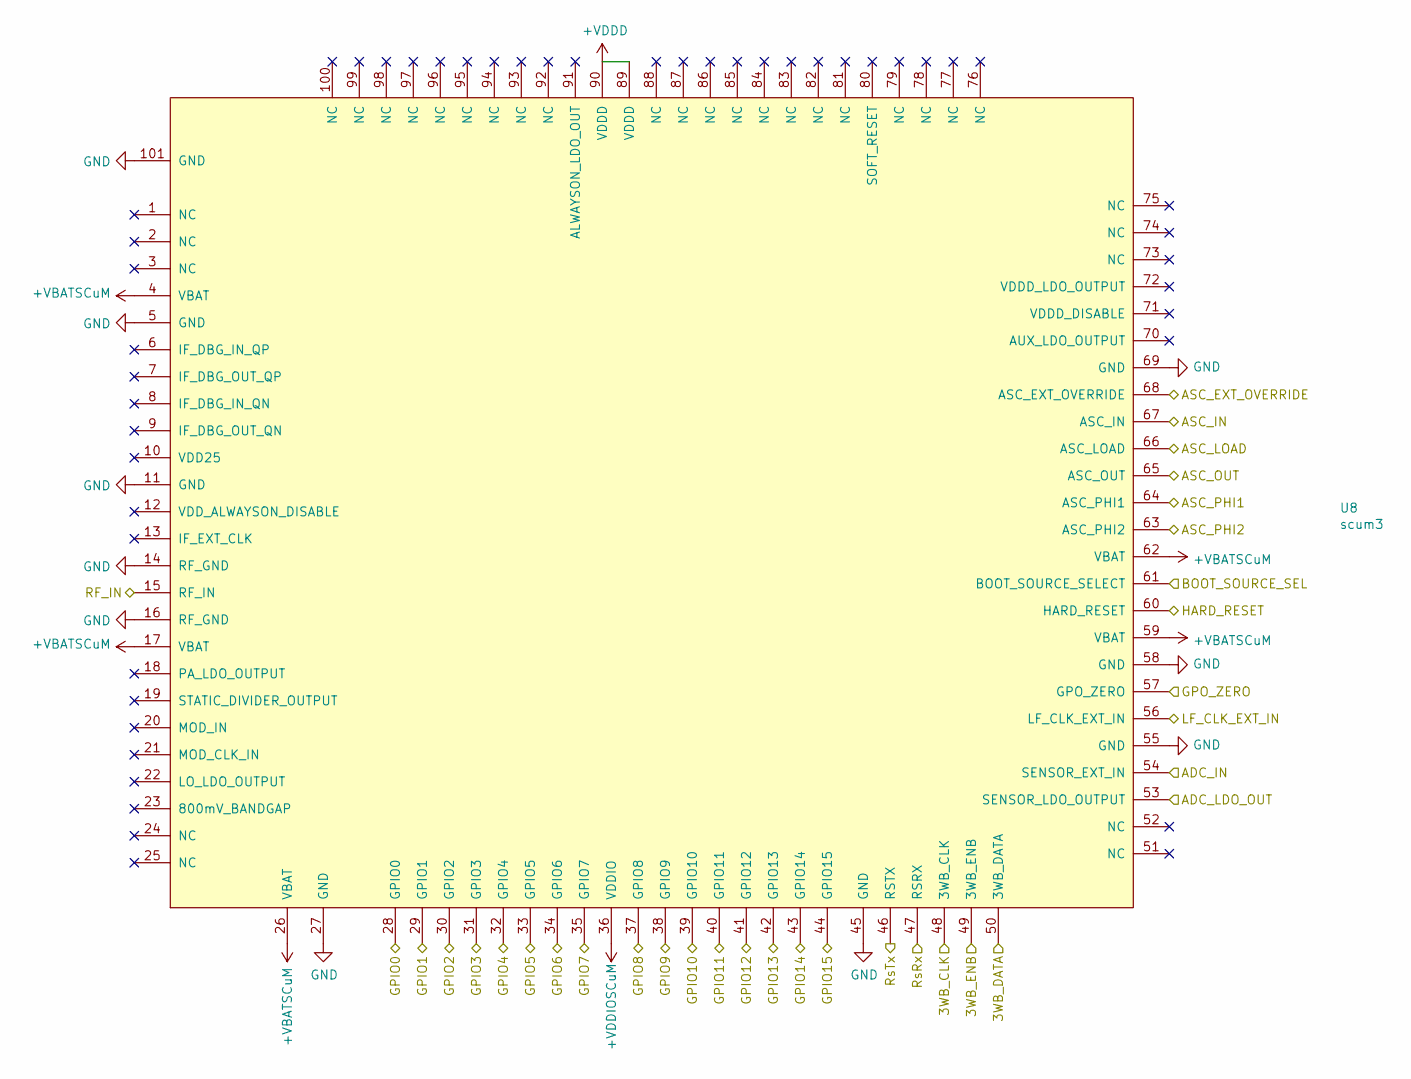
[picture p75: schematic scumsheet.sch]

Parts:
U8: scum3; QFN-100_EP_12x12_Pitch0.4mm

Connections:
+VBATSCuM: U8.4 (VBAT), U8.17 (VBAT), U8.26 (VBAT), U8.59 (VBAT), U8.62 (VBAT); also elsewhere on the board
+VDDD: U8.89 (VDDD), U8.90 (VDDD); also elsewhere on the board
+VDDIOSCuM: U8.36 (VDDIO); also elsewhere on the board
/3WB_CLK: U8.48 (3WB_CLK); also elsewhere on the board
/3WB_DATA: U8.50 (3WB_DATA); also elsewhere on the board
/3WB_ENB: U8.49 (3WB_ENB); also elsewhere on the board
/ADC_IN: U8.54 (SENSOR_EXT_IN); also elsewhere on the board
/ADC_LDO_OUT: U8.53 (SENSOR_LDO_OUTPUT); also elsewhere on the board
/Boot_Source_Sel: U8.61 (BOOT_SOURCE_SELECT); also elsewhere on the board
/Clock: U8.56 (LF_CLK_EXT_IN); also elsewhere on the board
/GPIO0: U8.28 (GPIO0); also elsewhere on the board
/GPIO1: U8.29 (GPIO1); also elsewhere on the board
/GPIO2: U8.30 (GPIO2); also elsewhere on the board
/GPIO3: U8.31 (GPIO3); also elsewhere on the board
/GPIO4: U8.32 (GPIO4); also elsewhere on the board
/GPIO5: U8.33 (GPIO5); also elsewhere on the board
/GPIO6: U8.34 (GPIO6); also elsewhere on the board
/GPIO7: U8.35 (GPIO7); also elsewhere on the board
/GPIO8: U8.37 (GPIO8); also elsewhere on the board
/GPIO9: U8.38 (GPIO9); also elsewhere on the board
/GPIO10: U8.39 (GPIO10); also elsewhere on the board
/GPIO11: U8.40 (GPIO11); also elsewhere on the board
/GPIO12: U8.41 (GPIO12); also elsewhere on the board
/GPIO13: U8.42 (GPIO13); also elsewhere on the board
/GPIO14: U8.43 (GPIO14); also elsewhere on the board
/GPIO15: U8.44 (GPIO15); also elsewhere on the board
/GPO_ZERO: U8.57 (GPO_ZERO); also elsewhere on the board
/RF_IN: U8.15 (RF_IN); also elsewhere on the board
/RsRx: U8.47 (RSRX); also elsewhere on the board
/RsTx: U8.46 (RSTX); also elsewhere on the board
/aLOAD: U8.66 (ASC_LOAD); also elsewhere on the board
/aPHI: U8.64 (ASC_PHI1); also elsewhere on the board
/aPHIb: U8.63 (ASC_PHI2); also elsewhere on the board
/aSCANIN: U8.67 (ASC_IN); also elsewhere on the board
/aSCANOUT: U8.65 (ASC_OUT); also elsewhere on the board
/aSCSEL: U8.68 (ASC_EXT_OVERRIDE); also elsewhere on the board
/hReset: U8.60 (HARD_RESET); also elsewhere on the board
GND: U8.5 (GND), U8.11 (GND), U8.14 (RF_GND), U8.16 (RF_GND), U8.27 (GND), U8.45 (GND), U8.55 (GND), U8.58 (GND), U8.69 (GND), U8.101 (GND); also elsewhere on the board

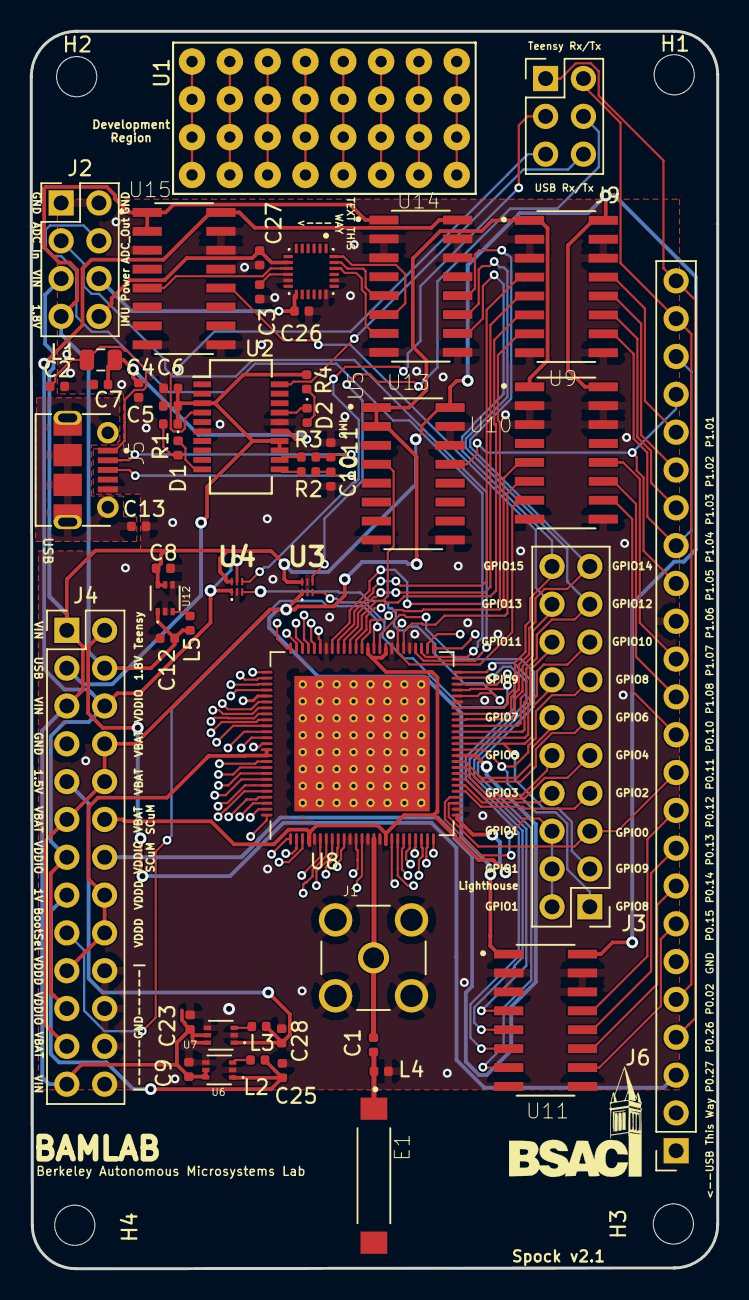
[picture p76: board Spock.kicad_pcb from above]

Board: 2 copper layers, 46.1 x 83.1 mm, 56 parts (0 on the bottom side), 94 nets.
