PisterLab/scum-dev-board/draft1/first try/draft1.kicad_pcb

## KiCad design draft1/first try/draft1.kicad_pcb (2020-07-24)

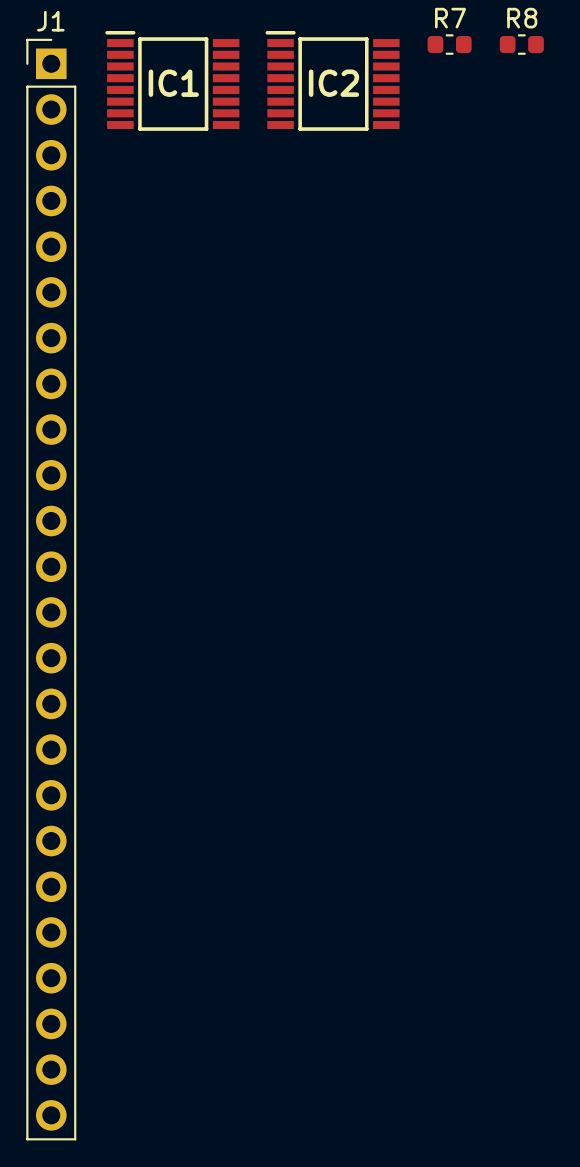
[picture p77: board draft1.kicad_pcb from above]

Board: 2 copper layers, 5 parts (0 on the bottom side), 11 nets, no tracks yet.

Parts:
IC1, IC2: 74AVC4TD245PW,118; SOP65P640X110-16N
J1: Conn_01x24; PinHeader_1x24_P2.54mm_Vertical
R7: NP; R_0603_1608Metric
R8: 100k; R_0603_1608Metric

Connections:
+UART33: IC1.16, IC2.16, R8.2
+VBAT: IC1.1, IC1.2, IC2.1
/ASC_EXT_OVER33: IC1.11, J1.24
/ASC_IN_33: IC1.12, J1.23
/ASC_LOAD_33: IC1.13, J1.22
/ASC_OUT33: IC1.14, J1.21
/ASC_PHI1_33: IC2.12, J1.20
/ASC_PHI2_33: IC2.11, J1.19
/HARD_RESET_33: IC2.13, J1.10, R7.1, R8.1
/LF_CLK_33: IC2.14, J1.6
GND: IC1.7, IC1.8, IC1.9, IC1.10, IC1.15, IC2.2, IC2.7, IC2.8, IC2.9, IC2.10, IC2.15, J1.15
