PisterLab/scum-dev-board/(commit log)

2020-05-29 created first draft
    [draft1.kicad_pcb, draft1.sch]
2020-06-03 step 20 of tutorial
    [tutorial1.kicad_pcb, tutorial1.sch]
2020-06-03 step 24
    [tutorial1.sch]
2020-06-08 step 48
    [tutorial1.sch]
2020-06-10 step 22
    [tutorial1.sch]
2020-07-13 moved old pdf into folder
    [draft1.sch]
2020-07-19 added components from aftermarket library
    [draft1.sch]
2020-07-23 added connector
    [draft1.sch]
2020-07-23 added power flags
    [draft1.sch]
2020-07-24 added some global labels
    [draft1.sch]
2020-07-24 added new sheet
    [draft1.kicad_pcb, draft1.sch, scumpadsheet.sch]
2020-08-08 added a pin number
2020-08-08 added scum pad to sch, made VDDIO pin
    [draft1.sch]
2020-08-08 added some pins
    [draft1.sch]
2020-08-14 added a pin
2020-08-16 added all pins to scum pad
    [draft1.sch]
2020-08-16 lengthened pin 1
    [draft1.sch]
2020-08-16 resized scum
    [draft1.sch, scumsheet.sch]
2020-08-16 added nc to scum
    [scumsheet.sch]
2020-08-16 added grounds
    [scumsheet.sch]
2020-08-16 fixed vdd descriptions
    [scumsheet.sch]
2020-08-16 added gpio labels
    [scumsheet.sch]
2020-08-16 labeled gpios
    [scumsheet.sch]
2020-08-16 finished bottom pins
    [scumsheet.sch]
2020-08-16 finished right side
    [scumsheet.sch]
2020-08-16 labeled something idk
    [scumsheet.sch]
2020-08-16 added resistors
    [scumsheet.sch]
2020-08-16 added temp sensor
    [scumsheet.sch]
2020-08-16 finished scum sheet
    [scumsheet.sch]
2020-08-16 added sheet
    [draft1.sch, file5F3B307D.sch, scumsheet.sch]
2020-08-16 added accelerometer
2020-08-16 noconned 9
    [file5F3B307D.sch]
2020-08-16 renamed sheets
    [draft1.sch, scumsheet.sch, top_sheet.sch]
2020-08-16 moved hierarchal sheets
    [draft1.sch, scumsheet.sch]
2020-08-16 moved out top_sheet parts
    [draft1.sch, scan_chain_boot.sch]
2020-08-16 deleted extras schematics
    [file5F3B307D.sch, scan_chain_boot.sch, scumpadsheet.sch, top_sheet.sch]
2020-08-16 moved components into hierarchal sheets
    [draft1.sch, scan_chain_boot.sch]
2020-08-16 fpga headers
    [draft1.sch, uart.sch]
2020-08-16 changed glabels to hlabels
    [scumsheet.sch]
2020-08-16 changed glabel to hlabel
    [draft1.sch]
2020-08-16 added scum pins
    [draft1.sch, scumsheet.sch]
2020-08-17 connected boot and scumsheet
    [draft1.sch, scumsheet.sch]
2020-08-17 labeled ft231xs-u
    [uart.sch]
2020-08-17 added usb
    [uart.sch]
2020-08-17 added stuff
    [uart.sch]
2020-08-17 added top pins
    [draft1.sch]
2020-08-17 deleted old MCU
    [draft1.sch]
2020-08-17 renamed components
    [draft1.sch, scumsheet.sch]
2020-08-17 good enough scumsheet
    [scumsheet.sch]
2020-08-17 good enough scan_chain_boot
    [draft1.sch, scan_chain_boot.sch, scumsheet.sch, uart.sch]
2020-08-17 UART good enough
    [scan_chain_boot.sch, uart.sch]
2020-08-17 good enough top sheet
    [draft1.sch, uart.sch]
2020-08-17 renamed weird inductor
    [uart.sch]
2020-08-17 changed grounds to passive
2020-08-17 some errors corrected
    [draft1.sch]
2020-08-17 added missing label
    [scan_chain_boot.sch]
2020-08-17 corrected errors
    [draft1.sch, scumsheet.sch, uart.sch]
2020-08-17 assigned 0402 footprint to caps
    [draft1.sch, scumsheet.sch, uart.sch]
2020-08-17 connector footprints
    [draft1.sch, scumsheet.sch, uart.sch]
2020-08-17 fresistor footprints
    [scumsheet.sch]
2020-08-17 footprints except for scum
    [draft1.sch, scumsheet.sch, uart.sch]
2020-08-17 made scum footprint
2020-08-17 made scum footprint draft
    [scumsheet.sch]
2020-08-17 made pcb ratsnest
    [draft1.kicad_pcb]
2020-08-17 placed some footprints
    [draft1.kicad_pcb]
2020-08-17 placed footprints
    [draft1.kicad_pcb]
2020-08-17 edge cut
    [draft1.kicad_pcb]
2020-08-17 tried autorouter
    [draft1.dsn, draft1.kicad_pcb]
2020-08-20 renamed files
    [scum3c-devboard.kicad_pcb, scum3c-devboard.sch]
2020-08-20 deleted old projects
    [draft1.kicad_pcb, draft1.sch]
2020-08-20 deleted tutorial
    [draft1.dsn, scan_chain_boot.sch, scum3c-devboard.kicad_pcb, scum3c-devboard.sch, scumsheet.sch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]
2020-08-20 copied in samacsys parts
    [74AVC1T45GS_132.step, 74AVC4TD245PW_118.step, FT231XS-U.step, HZ0805E601R-10.step, NE555DR.step]
2020-08-20 deleted downloaded libraries
    [74AVC1T45GS_132.step, 74AVC4TD245PW_118.step, FT231XS-U.step, HZ0805E601R-10.step, NE555DR.step]
2020-08-20 copied in samacsys files
    [74AVC1T45GS_132.step, 74AVC4TD245PW_118.step, FT231XS-U.step, HZ0805E601R-10.step, NE555DR.step]
2020-08-20 moved samacsys footprints from global to local library
2020-08-21 added SMA
    [scumsheet.sch]
2020-08-21 placed SMA footprint
2020-08-26 replaced placeholder scum footprint with 12x12 mm
    [scum3c-devboard.kicad_pcb, scumsheet.sch]
2020-08-27 auto-route failed
    [scum3c-devboard.dsn, scum3c-devboard.kicad_pcb]
2020-09-01 updated scum symbol footprint
2020-09-01 updated scum footprint on pcb
    [scum3c-devboard.kicad_pcb]
2020-09-01 changed resistor smd footprint to 0402
    [scan_chain_boot.sch, scum3c-devboard.kicad_pcb, scum3c-devboard.sch, scumsheet.sch, uart.sch]
2020-09-01 moved a resistor
    [scum3c-devboard.kicad_pcb]
2020-09-01 made up some design rules
    [scum3c-devboard.kicad_pcb]
2020-09-01 created new project for smaller version
    [scum3c-devboard.dsn, scum3c_small.kicad_pcb, scum3c_small.sch]
2020-09-02 added libraries to small board
    [74AVC1T45GS_132.step, 74AVC4TD245PW_118.step, FT231XS-U.step, HZ0805E601R-10.step, NE555DR.step, scum_footprint.sch]
2020-09-02 deleted most unnecessary things
    [74AVC1T45GS_132.step, 74AVC4TD245PW_118.step, FT231XS-U.step, HZ0805E601R-10.step, NE555DR.step, scan_chain_boot.sch, scum3c-devboard.dsn, scum3c-devboard.kicad_pcb]
2020-09-02 added placeholder battery
    [scum3c-devboard.dsn, scum3c-devboard.kicad_pcb, scum3c-devboard.sch, scumsheet.sch]
2020-09-02 added gnd layer
    [scum3c-devboard.kicad_pcb]
2020-09-02 made outline smaller
    [scum3c-devboard.dsn, scum3c-devboard.kicad_pcb]
2020-09-02 battery footprint
    [scumsheet.sch]
2020-09-02 deleted small board project
    [74AVC1T45GS_132.step, 74AVC4TD245PW_118.step, FT231XS-U.step, HZ0805E601R-10.step, NE555DR.step, scum3c_small.kicad_pcb, scum3c_small.sch, scum_footprint.sch]
2020-09-16 untracked everything gitignored filed
    [scum3c-devboard.dsn]
2020-10-05 added zener diode voltage protection
    [DDZ9678-7.step, scum3c-devboard.kicad_pcb, scum3c-devboard.sch, scumsheet.sch]
2020-10-05 added LED
    [2986.step, ADP2138ACBZ-1.8.step, scum3c-devboard.kicad_pcb, scum3c-devboard.sch, scumsheet.sch]
2020-10-05 moved pins
    [scum3c-devboard.kicad_pcb, scum3c-devboard.sch, scumsheet.sch]
2020-10-05 ground plane
    [scum3c-devboard.kicad_pcb]
2020-10-07 shrink to 30mm square
    [scum3c-devboard.kicad_pcb, scum3c-devboard.sch]
2020-10-07 finished traces hopefully
    [scum3c-devboard.kicad_pcb]
2020-12-01 changed header size
    [scum3c-devboard.kicad_pcb, scum3c-devboard.sch]
2020-12-01 replaced headers with smaller ones
    [scum3c-devboard.kicad_pcb, scum3c-devboard.sch, scumsheet.sch]
2020-12-01 added ground plane
    [scum3c-devboard.kicad_pcb]
2020-12-01 changed to mixed signals on front and back
    [scum3c-devboard.kicad_pcb]
2020-12-01 routed traces
    [scum3c-devboard.kicad_pcb, scum3c-devboard.sch, scumsheet.sch]
2020-12-02 copy-pasted over large board
    [2450AT42B100E--3DModel-STEP-56544.STEP, 74AVC1T45GS_132.step, 74AVC4TD245PW_118.step, FT231XS-U.step, HZ0805E601R-10.step, NE555DR.step, TPS8268150SIPT.STEP, UART.sch]
2020-12-02 made ground fill solid instead of thermal
    [scum3c-devboard.kicad_pcb]
2020-12-05 added ADC pins
    [scum3c-devboard.kicad_pcb, scum3c-devboard.sch, scumsheet.sch]
2020-12-05 deleted zener diode
    [scum3c-devboard.kicad_pcb, scum3c-devboard.sch]
2020-12-05 added gpio 8 9 10 and gnd pins
    [scum3c-devboard.kicad_pcb, scum3c-devboard.sch, scumsheet.sch]
2020-12-05 ready for merge
    [Teensy Conn.sch, UART.sch, scum3c-devboard.kicad_pcb, scum3c-devboard.sch, scumsheet.sch]
2020-12-06 flipped around gpio headers
    [scum3c-devboard.kicad_pcb, scum3c-devboard.sch]
2020-12-06 added scum footprint settings
2020-12-06 created new QFN for scum just in case other one bugged
2020-12-06 added gpio8-10
    [scum3c-devboard.kicad_pcb, scum3c-devboard.sch, scumsheet.sch]
2020-12-06 Revert "created new QFN for scum just in case other one bugged"
    This reverts commit 1ee4dfdbf7d43fb7091e5b49c8643484e4b92a24.
2020-12-06 Revert "added gpio8-10"
    This reverts commit daf7284f57cd8196d10e3621e3573955ecb68719.
    [scum3c-devboard.kicad_pcb, scum3c-devboard.sch, scumsheet.sch]
2020-12-06 deleted tracks
    [scum3c-devboard.kicad_pcb]
2020-12-06 placed components
    [scum3c-devboard.kicad_pcb]
2020-12-06 placed gpio, adc, and 3wb tracks
    [scum3c-devboard.kicad_pcb]
2020-12-06 placed vbat
    [scum3c-devboard.kicad_pcb]
2020-12-06 added layer 1 ground zone
    [scum3c-devboard.kicad_pcb]
2020-12-06 replaced gpio8-10
    [scum3c-devboard.kicad_pcb]
2020-12-06 placed scum contact tracks
    [scum3c-devboard.kicad_pcb]
2020-12-06 placed all tracks
    [scum3c-devboard.kicad_pcb]
2020-12-06 placed led ground
    [scum3c-devboard.kicad_pcb]
2020-12-06 untraced ground pins
    [scum3c-devboard.kicad_pcb]
2020-12-06 moved vbat to back
    [scum3c-devboard.kicad_pcb]
2020-12-06 refilled ground
    [scum3c-devboard.kicad_pcb]
2020-12-06 Revert "refilled ground"
    This reverts commit 937a25d859cc705142fc3d9099eb29337f2ecc38.
    [scum3c-devboard.kicad_pcb]
2020-12-06 redid ground layer
    [scum3c-devboard.kicad_pcb]
2020-12-06 cleaned vbat a bit
    [scum3c-devboard.kicad_pcb]
2020-12-06 labeled pins
    [scum3c-devboard.kicad_pcb]
2020-12-06 saved schematic pdf
2021-01-15 added missing BOOT_SOURCE_SELECT
    [scum3c-devboard.kicad_pcb, scum3c-devboard.sch, scumsheet.sch]
2021-01-20 made gerber files
    [scum3c-devboard-B_Cu.gbl, scum3c-devboard-B_Mask.gbs, scum3c-devboard-B_Paste.gbp, scum3c-devboard-B_SilkS.gbo, scum3c-devboard-Edge_Cuts.gm1, scum3c-devboard-F_Cu.gtl, scum3c-devboard-F_Mask.gts, scum3c-devboard-F_Paste.gtp]
2021-01-22 replaced level shifters and other changes
    [74AVCH4T245D_118.step, ICM-20948.step, Teensy Conn.sch, UART.sch, scum3c-devboard.kicad_pcb, scum3c-devboard.sch, scumsheet.sch]
2021-01-22 clean up labels
    [scum3c-devboard.kicad_pcb]
2021-01-23 connected IMU
    [scum3c-devboard.sch, scumsheet.sch]
2021-01-23 placed smds
    [scum3c-devboard.kicad_pcb, scum3c-devboard.sch]
2021-01-23 put in 2 rows for gpio
    [scum3c-devboard.kicad_pcb, scum3c-devboard.sch]
2021-01-23 2x6 grounds and imu power
    [scum3c-devboard.kicad_pcb, scum3c-devboard.sch]
2021-01-23 placed labels
    [scum3c-devboard.kicad_pcb, scum3c-devboard.sch]
2021-01-23 connected missing ground
    [scum3c-devboard.kicad_pcb]
2021-01-23 noconn on imu pin 12
    [scum3c-devboard.sch]
2021-01-23 added missing ground to scum
    [scum3c-devboard-B_Cu.gbl, scum3c-devboard-B_Mask.gbs, scum3c-devboard-B_Paste.gbp, scum3c-devboard-B_SilkS.gbo, scum3c-devboard-Edge_Cuts.gm1, scum3c-devboard-F_Cu.gtl, scum3c-devboard-F_Mask.gts, scum3c-devboard-F_Paste.gtp]
2021-01-24 zipped gerber files
    [scum3c-devboard-job.gbrjob]
2021-01-27 generated bom
2021-01-27 Added images
    [2450AT45A100E.step, CONSMA001-SMD-G-T--3DModel-STEP-56544.STEP, _saved_scum3c-devboard.sch, scum3c-devboard.kicad_pcb]
2021-01-31 match pads with small board
    [scum3c-devboard-B.Cu.gbr, scum3c-devboard-B.Mask.gbr, scum3c-devboard-B.SilkS.gbr, scum3c-devboard-Edge.Cuts.gbr, scum3c-devboard-F.Cu.gbr, scum3c-devboard-F.Mask.gbr, scum3c-devboard-F.SilkS.gbr, scum3c-devboard-NPTH.drl]
2021-02-12 Added antenna pin.
    Also:
    - added antenna pin to SCuM (not ideal, but it's there)
    - increased screw hole size slightly for better M1.6 screw fit
    - rounded board corners
    - fixed part labels
    - added name "McCoy" and logo
    [scum3c-devboard.kicad_pcb, scum3c-devboard.sch, scumsheet.sch]
2021-02-12 updated board images
2021-02-12 added pictures of board with antenna pin
2021-02-13 Bond diagram for large board
2021-02-18 clarified two labels on schematic
    [Teensy Conn.sch, _saved_scum3c-devboard.sch, scum3c-devboard.sch]
2021-03-09 With through-hole antenna
    [CONSMA001-G.step, UART.sch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]
2021-04-05 Added annotated schematic for McCoy
2021-04-05 Fixed bong diagram for large board
2021-04-05 Added bond diagram for essential bonds testing board
2021-04-09 ensuring large board up to date with master
    [scum3c-devboard.kicad_pcb, scum3c-devboard.sch]
2021-04-12 placed gpio traces
    [scum3c-devboard.kicad_pcb, scum3c-devboard.sch, scumsheet.sch]
2021-04-12 replaced footprints
    [scum3c-devboard.kicad_pcb, scum3c-devboard.sch]
2021-04-12 connected gpios
    [scum3c-devboard.kicad_pcb]
2021-04-12 routed vddio
    [scum3c-devboard.kicad_pcb]
2021-04-12 routed everything? except imu
    [scum3c-devboard.kicad_pcb]
2021-04-12 filled zones
    [scum3c-devboard.kicad_pcb, scumsheet.sch]
2021-04-12 changed drc rules
    [scum3c-devboard.kicad_pcb]
2021-04-12 added a bunch of vias that probably won't work
    [scum3c-devboard.kicad_pcb]
2021-04-12 labaled components
    [scumsheet.sch]
2021-04-13 changed edge cuts to a more regular size
    [scum3c-devboard.kicad_pcb, scum3c-devboard.sch]
2021-04-13 routed all traces
    [scum3c-devboard.kicad_pcb]
2021-04-14 added some through vias
    [scum3c-devboard.kicad_pcb, scum3c-devboard.sch, scumsheet.sch]
2021-04-14 fixed a label
    [scum3c-devboard.kicad_pcb]
2021-04-14 renamed folder
    [2986.step, 74AVC1T45GS_132.step, 74AVC4TD245PW_118.step, ADP2138ACBZ-1.8.step, DDZ9678-7.step, FT231XS-U.step, HZ0805E601R-10.step, NE555DR.step]
2021-04-14 updated pictures
    [scum3c-devboard-B_Cu.gbl, scum3c-devboard-B_Mask.gbs, scum3c-devboard-B_Paste.gbp, scum3c-devboard-Edge_Cuts.gm1, scum3c-devboard-F_Cu.gtl, scum3c-devboard-F_Mask.gts, scum3c-devboard-F_Paste.gtp, scum3c-devboard-F_SilkS.gto]
2021-04-14 created custom battery clip
    [scum3c-devboard.kicad_pcb, scum3c-devboard.sch]
2021-04-14 added a datasheet
    [scum3c-devboard.kicad_pcb]
2021-04-14 redid pictures
    [scum3c-devboard.kicad_pcb]
2021-04-14 renamed batter cell to battery clip
2021-04-14 placed bsac logo
    [scum3c-devboard.kicad_pcb]
2021-04-14 saved correct schematic image
2021-04-16 added a bunch of vias
    [scum3c-devboard.kicad_pcb]
2021-04-16 removed some geometry lines
    [scum3c-devboard.kicad_pcb]
2021-04-16 generated gerber files
    [scum3c-devboard-B_Cu.gbl, scum3c-devboard-B_Mask.gbs, scum3c-devboard-B_Paste.gbp, scum3c-devboard-B_SilkS.gbo, scum3c-devboard-Edge_Cuts.gm1, scum3c-devboard-F_Cu.gtl, scum3c-devboard-F_Mask.gts, scum3c-devboard-F_Paste.gtp]
2021-04-16 made new gerber zip
2021-04-16 added dimensions to edge cuts
    [scum3c-devboard.kicad_pcb]
2021-04-25 removed old tracks
    [scum3c-devboard.kicad_pcb, scum3c-devboard.sch]
2021-04-26 routed some gpios
    [scum3c-devboard.kicad_pcb]
2021-04-26 routed gpios
    [scum3c-devboard.kicad_pcb]
2021-04-26 moved the logos and labels
    [scum3c-devboard.kicad_pcb]
2021-04-26 moved a trace over
    [scum3c-devboard.kicad_pcb]
2021-04-26 changed version number
    [scum3c-devboard-B_Cu.gbl, scum3c-devboard-B_Mask.gbs, scum3c-devboard-B_Paste.gbp, scum3c-devboard-B_SilkS.gbo, scum3c-devboard-Edge_Cuts.gm1, scum3c-devboard-F_Cu.gtl, scum3c-devboard-F_Mask.gts, scum3c-devboard-F_Paste.gtp]
2021-04-26 added back labels
    [scum3c-devboard-B_Cu.gbl, scum3c-devboard-B_Mask.gbs, scum3c-devboard-B_Paste.gbp, scum3c-devboard-B_SilkS.gbo, scum3c-devboard-Edge_Cuts.gm1, scum3c-devboard-F_Cu.gtl, scum3c-devboard-F_Mask.gts, scum3c-devboard-F_Paste.gtp]
2021-04-26 adjusted some labelling
    [scum3c-devboard.kicad_pcb]
2021-04-26 created bom
    [mccoy_bom.csv, mccoy_bom.xlsx]
2021-04-26 redid gerber with some silkscreen adjusts
    [scum3c-devboard-B_Cu.gbl, scum3c-devboard-B_Mask.gbs, scum3c-devboard-B_Paste.gbp, scum3c-devboard-B_SilkS.gbo, scum3c-devboard-Edge_Cuts.gm1, scum3c-devboard-F_Cu.gtl, scum3c-devboard-F_Mask.gts, scum3c-devboard-F_Paste.gtp]
2021-04-26 got pictures
    [scum3c-devboard.kicad_pcb]
2021-04-28 updated with review material
    [scum3c-devboard.kicad_pcb, scum3c-devboard.sch, scumsheet.sch]
2021-04-28 label a hole
    [scumsheet.sch]
2021-04-28 moved some labels to be more visible
    [scum3c-devboard.kicad_pcb]
2021-04-28 generated new gerber
    [scum3c-devboard-B_Cu.gbl, scum3c-devboard-B_Mask.gbs, scum3c-devboard-B_Paste.gbp, scum3c-devboard-B_SilkS.gbo, scum3c-devboard-Edge_Cuts.gm1, scum3c-devboard-F_Cu.gtl, scum3c-devboard-F_Mask.gts, scum3c-devboard-F_Paste.gtp]
2021-04-29 added some labels for clarity
    [scum3c-devboard.kicad_pcb]
2021-04-29 swapped around GPIO 2 and 3 for nrf
    [scum3c-devboard.kicad_pcb, scum3c-devboard.sch]
2021-04-29 redid gerber with label fixes
    [scum3c-devboard-B_Cu.gbl, scum3c-devboard-B_Mask.gbs, scum3c-devboard-B_Paste.gbp, scum3c-devboard-B_SilkS.gbo, scum3c-devboard-Edge_Cuts.gm1, scum3c-devboard-F_Cu.gtl, scum3c-devboard-F_Mask.gts, scum3c-devboard-F_Paste.gtp]
2021-05-10 Added updated bonding diagrams for self testing for both boards
2021-05-11 Removed old standoffs note
2021-07-03 update mccoy board bond diagrams
2021-08-03 Added wirebond diagram for mccoy
2021-08-26 created external battery pin
2021-08-26 external battery symbol
2021-08-26 added larger left header set
    [scum3c-devboard.sch]
2021-08-26 external battery pin
2021-08-26 created regulator voltage symbols
2021-08-26 Revert "created regulator voltage symbols"
    This reverts commit 2e3631360fcf3ed4d9fbef1533d95bcecbf0b44b.
2021-08-26 Revert "external battery pin"
    This reverts commit 8073f7458466f43baadc01ed056c625e0f1e9e5a.
2021-08-26 regulator voltage pins
2021-08-26 added vddd nrf
    [scum3c-devboard.sch]
2021-08-26 created regulator symbol
    [scum3c-devboard.sch]
2021-08-26 assigned most footprints
    [scum3c-devboard.sch]
2021-08-27 created snt-6a footprint
    [scum3c-devboard.sch]
2021-08-27 added regulators to pcb
    [scum3c-devboard.sch]
2021-08-27 corrected pin labels on regulator
2021-08-27 moved pins for better tracing
    [scum3c-devboard.kicad_pcb, scum3c-devboard.sch]
2021-08-27 routed regulator traces
    [scum3c-devboard.kicad_pcb, scum3c-devboard.sch]
2021-08-27 moved north pins down a bit
    [scum3c-devboard.kicad_pcb]
2021-08-27 numbered reg caps
    [scum3c-devboard.sch]
2021-08-27 changed regulators to copy-pasted from spock
    [scum3c-devboard.kicad_pcb, scum3c-devboard.sch]
2021-08-27 added caps to bom
    [mccoy_bom.xlsx]
2021-08-27 started adding labels
    [mccoy_bom.xlsx, scum3c-devboard.kicad_pcb, scum3c-devboard.sch]
2021-08-27 finished labels
    [scum3c-devboard.kicad_pcb]
2021-08-27 brought bom up to date
    [mccoy_bom.csv, mccoy_bom.xlsx]
2021-08-27 added 0 ohm resistor footprint between pins 89 and 90
    [scum3c-devboard.kicad_pcb, scumsheet.sch]
2021-08-28 added sum total
    [mccoy_bom.xlsx]
2021-08-28 labeled R4
    [scum3c-devboard.sch, scumsheet.sch]
2021-08-28 refilled zones
    [scum3c-devboard.kicad_pcb]
2021-08-28 generated gerber files for mccoy 3.0
    [scum3c-devboard-B_Cu.gbl, scum3c-devboard-B_Mask.gbs, scum3c-devboard-B_Paste.gbp, scum3c-devboard-B_SilkS.gbo, scum3c-devboard-Edge_Cuts.gm1, scum3c-devboard-F_Cu.gtl, scum3c-devboard-F_Mask.gts, scum3c-devboard-F_Paste.gtp]
2021-08-28 added OOS label to IMU :(
    [mccoy_bom.xlsx]
2021-09-03 added CR2477 battery holder
    [scum3c-devboard.kicad_pcb, scum3c-devboard.sch]
2021-09-03 added 1.1V reg input
    [scum3c-devboard.kicad_pcb, scum3c-devboard.sch]
2021-09-03 added labels
    [scum3c-devboard.kicad_pcb]
2021-09-03 renamed mccoy3 to sulu
    [2986.step, 74AVC1T45GS_132.step, 74AVC4TD245PW_118.step, ADP2138ACBZ-1.8.step, DDZ9678-7.step, FT231XS-U.step, HZ0805E601R-10.step, NE555DR.step]
2021-09-03 checkout mccoy v2
    [2986.step, 74AVC1T45GS_132.step, 74AVC4TD245PW_118.step, ADP2138ACBZ-1.8.step, DDZ9678-7.step, FT231XS-U.step, HZ0805E601R-10.step, NE555DR.step]
2021-09-03 created folders for regulator and ldo versions
    [2986.step, 74AVC1T45GS_132.step, 74AVC4TD245PW_118.step, ADP2138ACBZ-1.8.step, DDZ9678-7.step, FT231XS-U.step, HZ0805E601R-10.step, NE555DR.step]
2021-09-03 added 3d model for battery holder
    [BH1000G.STEP, scum3c-devboard.kicad_pcb, scum3c-devboard.sch]
2021-09-03 updated ldo with 3d model from reg
    [BH1000G.STEP, scum3c-devboard.kicad_pcb, scum3c-devboard.sch]
2021-09-03 checked out ldo version from ldo branch
    [scum3c-devboard.kicad_pcb, scum3c-devboard.sch]
2021-09-03 updated sulu bom
    [mccoy_bom.xlsx, sulu_ldo_bom.xlsx, sulu_reg_bom.xlsx]
2021-09-03 aligned fill zones
    [scum3c-devboard.kicad_pcb]
2021-09-03 deleted mccoy 3 gerbers
    [scum3c-devboard-B_Cu.gbl, scum3c-devboard-B_Mask.gbs, scum3c-devboard-B_Paste.gbp, scum3c-devboard-B_SilkS.gbo, scum3c-devboard-Edge_Cuts.gm1, scum3c-devboard-F_Cu.gtl, scum3c-devboard-F_Mask.gts, scum3c-devboard-F_Paste.gtp]
2021-09-03 moved panelized to its own folder
    [sulu_ldo_and_reg_panel.kicad_pcb]
2021-09-03 generated gerber files - no solder paste
    [sulu_ldo_and_reg_panel-B_Cu.gbl, sulu_ldo_and_reg_panel-B_Mask.gbs, sulu_ldo_and_reg_panel-B_SilkS.gbo, sulu_ldo_and_reg_panel-Edge_Cuts.gm1, sulu_ldo_and_reg_panel-F_Cu.gtl, sulu_ldo_and_reg_panel-F_Mask.gts, sulu_ldo_and_reg_panel-F_SilkS.gto, sulu_ldo_and_reg_panel-job.gbrjob]
2021-09-03 added a dimension for the joint
    [sulu_ldo_and_reg_panel.kicad_pcb]
2021-09-03 added coax connector, not connected in layout
    [scum3c-devboard.kicad_pcb, scum3c-devboard.sch]
2021-09-03 hid a bunch of layers
    [scum3c-devboard.kicad_pcb]
2021-09-03 removed tab to separate panels
    [sulu_ldo_and_reg_panel.kicad_pcb]
2021-09-03 generated gerber for 2 panels without tab
    [sulu_ldo_and_reg_panel-B_Cu.gbl, sulu_ldo_and_reg_panel-B_Mask.gbs, sulu_ldo_and_reg_panel-B_SilkS.gbo, sulu_ldo_and_reg_panel-Edge_Cuts.gm1, sulu_ldo_and_reg_panel-F_Cu.gtl, sulu_ldo_and_reg_panel-F_Mask.gts, sulu_ldo_and_reg_panel-F_SilkS.gto, sulu_ldo_and_reg_panel-job.gbrjob]
2021-09-03 added dimensions and generated gerber for 8x6 panel
    [sulu_ldo_and_reg_panel-B_Mask.gbs, sulu_ldo_and_reg_panel-Edge_Cuts.gm1, sulu_ldo_and_reg_panel-F_Mask.gts, sulu_ldo_and_reg_panel-job.gbrjob, sulu_ldo_and_reg_panel.drl]
2021-09-04 moved parts out of the way of sma
    [scum3c-devboard.kicad_pcb]
2021-09-05 rearranged some architecture
    [733910060.stp, scum3c-devboard.kicad_pcb, scum3c-devboard.sch]
2021-09-05 connected most things except breakouts
    [scum3c-devboard.kicad_pcb]
2021-09-05 Revert "connected most things except breakouts"
    This reverts commit 7eebfed253d0b9308cc87a63beb7c5f4bd65d2a7.
    [scum3c-devboard.kicad_pcb]
2021-09-05 Revert "rearranged some architecture"
    This reverts commit c12dfdee068bb4749b85b6faf8935c1bd7e1da4a.
    [733910060.stp, scum3c-devboard.kicad_pcb, scum3c-devboard.sch]
2021-09-05 added keepout to antenna
    [scum3c-devboard.kicad_pcb]
2021-09-06 connected most things on the north headers
    [scum3c-devboard.kicad_pcb, scum3c-devboard.sch]
2021-09-06 finished routing
    [scum3c-devboard.kicad_pcb, scum3c-devboard.sch, scumsheet.sch]
2021-09-11 removed vbat under antenna
    [scum3c-devboard.kicad_pcb]
2021-09-11 moved battery north a little
    [scum3c-devboard.kicad_pcb]
2021-09-11 changed front ground to exclude antenna region
    [scum3c-devboard.kicad_pcb]
2021-09-11 added gnd connections to antenna
    [scum3c-devboard.kicad_pcb]
2021-09-11 put ground on west of antenna
    [scum3c-devboard.kicad_pcb]
2021-09-11 added ldos
    [scum3c-devboard.kicad_pcb, scum3c-devboard.sch, scumsheet.sch]
2021-09-11 put ldos on pcb
    [scum3c-devboard.kicad_pcb, scum3c-devboard.sch]
2021-09-11 moved labels for LDOOs
    [scum3c-devboard.kicad_pcb]
2021-09-11 turned on all layers
    [scum3c-devboard.kicad_pcb]
2021-09-11 shifted antenna south to match ldo board
    [scum3c-devboard.kicad_pcb]
2021-09-11 fill zones
    [scum3c-devboard.kicad_pcb]
2021-09-11 placed on grid
    [scum3c-devboard.kicad_pcb]
2021-09-11 deleted old gerber files
    [sulu_ldo_and_reg_panel-B_Cu.gbl, sulu_ldo_and_reg_panel-B_Mask.gbs, sulu_ldo_and_reg_panel-B_SilkS.gbo, sulu_ldo_and_reg_panel-Edge_Cuts.gm1, sulu_ldo_and_reg_panel-F_Cu.gtl, sulu_ldo_and_reg_panel-F_Mask.gts, sulu_ldo_and_reg_panel-F_SilkS.gto, sulu_ldo_and_reg_panel-job.gbrjob]
2021-09-11 added dimensions
    [scum3c-devboard.kicad_pcb]
2021-09-11 generated gerbers
    [scum3c-devboard-B_Cu.gbl, scum3c-devboard-B_Mask.gbs, scum3c-devboard-B_Paste.gbp, scum3c-devboard-B_SilkS.gbo, scum3c-devboard-Edge_Cuts.gko, scum3c-devboard-F_Cu.gtl, scum3c-devboard-F_Mask.gts, scum3c-devboard-F_Paste.gtp]
2021-09-11 aligned to 100 mil grid
    [scum3c-devboard.kicad_pcb]
2021-09-11 renamed gerber folders to match type of sulu
    [scum3c-devboard-B_Cu.gbl, scum3c-devboard-B_Mask.gbs, scum3c-devboard-B_Paste.gbp, scum3c-devboard-B_SilkS.gbo, scum3c-devboard-Edge_Cuts.gko, scum3c-devboard-F_Cu.gtl, scum3c-devboard-F_Mask.gts, scum3c-devboard-F_Paste.gtp]
2021-09-13 changed label to say LDO
    [scum3c-devboard.kicad_pcb]
2021-09-13 2x1 array. hopefully they can copy it about
    [sulu_ldo_and_reg_panel-B_Cu.gbl, sulu_ldo_and_reg_panel-B_Mask.gbs, sulu_ldo_and_reg_panel-B_Paste.gbp, sulu_ldo_and_reg_panel-B_SilkS.gbo, sulu_ldo_and_reg_panel-Edge_Cuts.gm1, sulu_ldo_and_reg_panel-F_Cu.gtl, sulu_ldo_and_reg_panel-F_Mask.gts, sulu_ldo_and_reg_panel-F_Paste.gtp]
2021-09-13 deleted a dimenion
    [sulu_ldo_and_reg_panel.kicad_pcb]
2021-09-14 added alignment holes to solder paste layer
    [sulu_ldo_and_reg_panel.kicad_pcb]
2021-09-14 added alignment holes
    [sulu_ldo_and_reg_panel-F_Paste.gtp, sulu_ldo_and_reg_panel-job.gbrjob]
2021-09-14 generated new files with alignment holes
    [sulu_ldo_and_reg_panel-B_Cu.gbl, sulu_ldo_and_reg_panel-B_Mask.gbs, sulu_ldo_and_reg_panel-B_Paste.gbp, sulu_ldo_and_reg_panel-B_SilkS.gbo, sulu_ldo_and_reg_panel-Edge_Cuts.gm1, sulu_ldo_and_reg_panel-F_Cu.gtl, sulu_ldo_and_reg_panel-F_Mask.gts, sulu_ldo_and_reg_panel-F_Paste.gtp]
2021-09-15 updated boms with antenna
    [sulu_ldo_bom.xlsx, sulu_reg_bom.xlsx]
2021-09-19 updated with parts that got ordered
    [sulu_ldo_bom.xlsx, sulu_reg_bom.xlsx]
2021-10-10 put inductor on reg bom
    [sulu_ldo_bom.xlsx, sulu_reg_bom.xlsx]
2021-11-03 added new inductor to bom
    [sulu_reg_bom_0402ind.xlsx, sulu_reg_bom_0806ind.xlsx]
2021-11-03 corrected swapped inductors
    [sulu_reg_bom_0402ind.xlsx, sulu_reg_bom_0806ind.xlsx]
2021-11-15 switched out dc-dc converter footprints to recommended components
    [scum3c-devboard.kicad_pcb, scum3c-devboard.sch]
2021-11-15 adjusted a label a touch
    [scum3c-devboard.kicad_pcb]
2021-11-15 updated pictures to current version
2021-11-20 changed 2x5 to 1x10 nrf header
    [scum3c-devboard.kicad_pcb, scum3c-devboard.sch]
2021-11-20 adjusted standoff holes
    [scum3c-devboard.kicad_pcb]
2021-11-20 moved labels for nrf header
    [scum3c-devboard.kicad_pcb]
2021-11-20 moved resistor and cap labels
    [scum3c-devboard.kicad_pcb]
2021-11-21 brought images up to date with single row nrf
    [scum3c-devboard.kicad_pcb, scum3c-devboard.sch]
2021-11-21 deleted old gerbers
    [scum3c-devboard-B_Cu.gbl, scum3c-devboard-B_Mask.gbs, scum3c-devboard-B_Paste.gbp, scum3c-devboard-B_SilkS.gbo, scum3c-devboard-Edge_Cuts.gko, scum3c-devboard-F_Cu.gtl, scum3c-devboard-F_Mask.gts, scum3c-devboard-F_Paste.gtp]
2021-11-21 added dots for orientation of ICs
    [scum3c-devboard.kicad_pcb]
2021-11-23 flipped around the nrf header
    [scum3c-devboard.kicad_pcb, scum3c-devboard.sch]
2021-11-23 unoverlapped labels
    [scum3c-devboard.kicad_pcb]
2021-11-23 gnd move
2021-11-24 moved trace away from via
    [scum3c-devboard.kicad_pcb]
2021-11-24 moved a trace away from vias
    [scum3c-devboard-B_Cu.gbl, scum3c-devboard-B_Mask.gbs, scum3c-devboard-B_Paste.gbp, scum3c-devboard-B_SilkS.gbo, scum3c-devboard-Edge_Cuts.gm1, scum3c-devboard-F_Cu.gtl, scum3c-devboard-F_Mask.gts, scum3c-devboard-F_Paste.gtp]
2021-12-10 updated to recommended caps
    [sulu_reg_bom.xlsx]
2021-12-10 put bom in zip
2021-12-10 changed battery from BT1 to B1
    [sulu_reg_bom.xlsx]
2021-12-10 bold schematic labels
    [scum3c-devboard.sch]
2021-12-10 changed schematic name
    [scum3c-devboard.sch]
2021-12-11 added headers to bom
    [sulu_reg_bom.xlsx]
2021-12-12 generated centroids
    [scum3c-devboard-bottom-pos.csv, scum3c-devboard-top-pos.csv]
2022-08-30 Added thermal relief to connector TH pads
    [scum3c-devboard.kicad_pcb]
2022-08-30 Version bumped silkscreen & schematic to V2.1
    [scum3c-devboard.kicad_pcb, scum3c-devboard.kicad_sch, scumsheet.kicad_sch]
2022-08-31 Added thermal relief to SMA connector and SCUM package footprint
    [scum3c-devboard.kicad_pcb]
2022-09-04 Added sulu-ads1299 project with partially complete sch
    [ads1299_sheet.kicad_sch, scumsheet.kicad_sch, sulu_ads1299.kicad_pcb, sulu_ads1299.kicad_sch]
2022-09-04 Sulu-ads1299 schematic largely completed
    [ads1299_sheet.kicad_sch, scumsheet.kicad_sch, sulu_ads1299.kicad_sch]
2022-09-05 Sulu-ads1299 migrating libs and fixing ERC
    [ads1299_sheet.kicad_sch, sulu_ads1299.kicad_sch]
2022-09-05 Sulu-ads1299 started layout & imported shared footprints
    [2986.step, 74AVC1T45GS_132.step, 74AVC4TD245PW_118.step, ADP2138ACBZ-1.8.step, BH1000G.STEP, DDZ9678-7.step, FT231XS-U.step, HZ0805E601R-10.step]
2022-09-06 Sulu-ads1299 finalized floorplan, began routing, updated schematic
    [ads1299_sheet.kicad_sch, scumsheet.kicad_sch, sulu_ads1299.kicad_pcb, sulu_ads1299.kicad_sch]
2022-09-06 Sulu-ads1299 added missing power nets & decap, more routing
    [ads1299_sheet.kicad_sch, sulu_ads1299.kicad_pcb, sulu_ads1299.kicad_sch]
2022-09-08 Sulu-ads1299 layout nearly complete
    [sulu_ads1299.kicad_pcb, sulu_ads1299.kicad_sch]
2022-09-09 Generated Sulu v2.1 gerbers, drill files & updated BOM
    [scum3c-devboard-B_Cu.gbl, scum3c-devboard-B_Mask.gbs, scum3c-devboard-B_Paste.gbp, scum3c-devboard-B_Silkscreen.gbo, scum3c-devboard-Edge_Cuts.gm1, scum3c-devboard-F_Cu.gtl, scum3c-devboard-F_Mask.gts, scum3c-devboard-F_Paste.gtp]
2022-09-13 Sulu-ads1299, completed place & route
    [ads1299_sheet.kicad_sch, scumsheet.kicad_sch, sulu_ads1299.kicad_pcb, sulu_ads1299.kicad_sch]
2022-09-14 Sulu-ADS1299 completed silkscreen
    [sulu_ads1299.kicad_pcb]
2022-09-14 Sulu-ads1299 switched to backside female connectors
    [sulu_ads1299.kicad_pcb, sulu_ads1299.kicad_sch]
2022-09-22 Upated schematic and layout.
    [ads1299_sheet.kicad_sch, scumsheet.kicad_sch, sulu_ads1299.kicad_pcb, sulu_ads1299.kicad_sch]
2022-09-22 Sulu-ADS1299 10uF DCDC output decap, BoM, and bigger C20 footprint
    [ads1299_sheet.kicad_sch, sulu_ads1299.kicad_pcb, sulu_ads1299.kicad_sch, sulu_ads1299_bom.xlsx]
2022-09-23 Partially complete BOM for Sulu-ADS1299
    [sulu_ads1299_bom.xlsx]
2022-09-23 Added sulu-ads1299 part list (not BOM)
    [sulu_ads1299_part_list.xlsx]
2022-09-28 Completed Sulu-ads1299 BOM
    [sulu_ads1299.kicad_sch, sulu_ads1299_bom.xlsx]
2022-09-28 Sulu-ads1299 3.3uF differential filter caps in bom
    [sulu_ads1299_bom.xlsx]
2022-09-28 Changed ADC's input RC value and updated resitors BOM.
    [sulu_ads1299.kicad_sch, sulu_ads1299_bom.xlsx]
2022-09-29 Sulu-ads1299 update pcb from sch
    [sulu_ads1299.kicad_pcb]
2022-09-29 Sulu-ads1299 added thermal relief to TH footprints, exported gerbers and DFs
    [sulu_ads1299-B_Cu.gbr, sulu_ads1299-B_Mask.gbr, sulu_ads1299-B_Paste.gbr, sulu_ads1299-B_Silkscreen.gbr, sulu_ads1299-Edge_Cuts.gbr, sulu_ads1299-F_Cu.gbr, sulu_ads1299-F_Mask.gbr, sulu_ads1299-F_Paste.gbr]
2022-10-27 Updated Sulu bom and component pos files for assembly
    [sulu_reg_bom.xlsx]
2022-10-27 Updated Sulu-ADS1299 bom and component files for assembly
    [sulu_ads1299_bom_final.xlsx]
2023-01-20 Sulu-ADS1299 filled in missing BoM entries, removed part list
    [sulu_ads1299_bom_final.xlsx, sulu_ads1299_part_list.xlsx]
2023-03-27 Sulu-ADS1299 added PDF of full schematic
2023-05-19 Sulu-ADS1299 started revision 2, added Molex libs, Banana for scale
    [scumsheet.kicad_sch, sulu_ads1299.kicad_pcb, sulu_ads1299.kicad_sch]
2023-05-21 Updated sulu-ads1299 rev2 layout and schematic
    [ads1299_sheet.kicad_sch, scumsheet.kicad_sch, sulu_ads1299.kicad_pcb, sulu_ads1299.kicad_sch]
2023-05-21 Sulu-ADS1299 rev2 component placements
    [sulu_ads1299.kicad_pcb, sulu_ads1299.kicad_sch]
2023-05-23 Sulu-ADS1299 components placed, new antenna, some routing
    [ads1299_sheet.kicad_sch, scumsheet.kicad_sch, sulu_ads1299.kicad_pcb, sulu_ads1299.kicad_sch]
2023-05-24 Sulu-ADS1299 rev2 most of the routing done
    [sulu_ads1299.kicad_pcb]
2023-05-25 Silkscreen cleaned, reduced TP footprint #, post design review
    [ads1299_sheet.kicad_sch, scumsheet.kicad_sch, sulu_ads1299.kicad_pcb, sulu_ads1299.kicad_sch]
2023-05-25 Sulu-ADS1299 rev2 commit before changing 1.1V regulator
    [BOM-sulu_ads1299.csv, scumsheet.kicad_sch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]
2023-05-27 BOM adjustments, protection Zener diodes, JLCPCB fab files
    [BOM-sulu_ads1299.csv, ads1299_sheet.kicad_sch, scumsheet.kicad_sch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]
2023-06-01 Final submitted layout, gerbers, drill files, bom, and cpl
    [BOM-sulu_ads1299.csv, C&K_Components_-_TDA02H0SB1.step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]
2023-06-02 Added Molex to std pitch connector/programmer board
    [BOM-connector_board.csv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]
2023-06-23 Sulu-ADS1299 Rev 3 improved routing surrounding QFN
    [scumsheet.kicad_sch, sulu_ads1299.kicad_pcb]
2023-07-12 Updated connector boards and Sulu-ADS1299 schematic
    [connector_board.kicad_pcb, connector_board.kicad_sch, scum3c-devboard.kicad_pcb, scumsheet.kicad_sch, sulu_ads1299.kicad_pcb, sulu_ads1299.kicad_sch]
2023-07-13 Sulu-ADS1299 rev 3 fixed gpios, debug connector, two regulators
    [ads1299_sheet.kicad_sch, scumsheet.kicad_sch, sulu_ads1299.kicad_pcb, sulu_ads1299.kicad_sch]
2023-07-14 Sulu-ADS1299 and connector board layout+sch progress
    [ads1299_sheet.kicad_sch, connector_board.kicad_pcb, connector_board.kicad_sch, scumsheet.kicad_sch, sulu_ads1299.kicad_pcb, sulu_ads1299.kicad_sch]
2023-07-20 Sulu-ADS1299 mosfet input protection circuit
    [scumsheet.kicad_sch, sulu_ads1299.kicad_pcb, sulu_ads1299.kicad_sch]
2023-07-20 Fixed DRC rules for JLC PCB
2023-07-20 DRC clean layout of Rev. 3
    [ads1299_sheet.kicad_sch, scumsheet.kicad_sch, sulu_ads1299.kicad_pcb, sulu_ads1299.kicad_sch]
2023-07-20 Completed silkscreen for Rev. 3
    [sulu_ads1299.kicad_pcb]
2023-07-27 SCuM Programmer Rev. 2, submitted for fab
    [BOM-connector_board.csv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]
2023-07-27 Folder rename sulu-programmer -> scum-programmer for consistency
    [BOM-connector_board.csv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]
2023-11-13 Sulu-ADS1299 rev3 progress
    [ads1299_sheet.kicad_sch, scumsheet.kicad_sch, sulu_ads1299.kicad_pcb, sulu_ads1299.kicad_sch]
2024-01-25 Sulu-ADS1299-rev3 progress
    [sulu_ads1299.kicad_pcb]
2024-01-25 Sulu-ADS1299 rev3 layout and schematic progress
    [sulu_ads1299.kicad_pcb, sulu_ads1299.kicad_sch]
2024-01-27 Sulu-ADS1299 rev3 nearly done
    [sulu_ads1299.kicad_pcb, sulu_ads1299.kicad_sch]
2024-02-05 Sulu-ADS1299 use regulators without inductors
    [BOM-sulu_ads1299.csv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]
2024-02-05 Finished Sulu-ADS1299 Rev 3 layout
    [BOM-sulu_ads1299.csv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]
2024-02-09 Sulu-ADS1299 rev3 matching network, BOM
    [BOM-sulu_ads1299.csv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]
2024-02-10 Final submitted Sulu-ADS1299 rev 3
    [BOM-sulu_ads1299.csv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]
2024-02-26 Re-order 3WB header locations
    [scum3c-devboard.kicad_pcb, scum3c-devboard.kicad_sch, scumsheet.kicad_sch]
2024-07-31 Add JLCPCB LCSC part numbers
    [scum3c-devboard.kicad_pcb, scum3c-devboard.kicad_sch, scumsheet.kicad_sch]
2024-07-31 Add ground stitching vias
    [BOM-scum3c-devboard.csv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]
2024-08-07 Modify mounting holes to fit M2 screws
    [scum3c-devboard-CuBottom.gbr, scum3c-devboard-CuTop.gbr, scum3c-devboard-EdgeCuts.gbr, scum3c-devboard-MaskBottom.gbr, scum3c-devboard-MaskTop.gbr, scum3c-devboard-NPTH.drl, scum3c-devboard-PTH.drl, scum3c-devboard-PasteBottom.gbr]
2025-04-04 Add Raspberry Pi Pico breakout board
    [BOM-pico-breakout.csv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]
2025-04-04 Add Raspberry Pi Pico W breakout board
    [BOM-pico-w-breakout.csv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]
2025-04-09 Fix mounting hole positions
    [pico-breakout-CuBottom.gbr, pico-breakout-CuTop.gbr, pico-breakout-EdgeCuts.gbr, pico-breakout-MaskBottom.gbr, pico-breakout-MaskTop.gbr, pico-breakout-NPTH.drl, pico-breakout-PTH.drl, pico-breakout-PasteBottom.gbr]
2025-04-09 Ignore KiCad backups
2025-04-12 Add series resistor to GPIO 2
    [BOM-pico-breakout.csv, BOM-pico-w-breakout.csv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]
2025-04-17 Final update to Pico breakout boards
    [BOM-pico-breakout.csv, BOM-pico-w-breakout.csv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]
